auxinnepaul/pads_vending_machine_with_coin_acceptor/firmware_dev_paperwork/README.md

# Pad Dispenser — Paperwork Index

*Build. Connect. Automate.*

The documentation set for `pads_vending_machine_with_coin_acceptor.ino`.
**Start here** — this page says which doc to read for what.

Client: Rebecca Mpiima · Ref `BT-PADVEND-2026-001` · Firmware v2.0

---

## Which doc do I need?

| I want to… | Read | Audience |
|---|---|---|
| **Understand the whole machine** (what it is, what it proves, what it deliberately does not, a tour of the firmware) | [`OVERVIEW.md`](OVERVIEW.md) | **Everyone — start here** |
| **See what's been built, decided, verified on hardware, and what's next** | [`FIRMWARE_PROGRESS.md`](FIRMWARE_PROGRESS.md) | Anyone picking up the work |
| **Know why the money is handled the way it is** (pay-on-delivery, the claim vs the cash, why part payment expires, why a recovered pad waits) | [`DESIGN_DECISIONS.md`](DESIGN_DECISIONS.md) | **Read before changing anything that touches `credit`** |
| **Wire the machine** (every pin, the power tree, the PC817 coin line, both relays, the LCD level converter, as built and with what has been metered) | [`WIRING.md`](WIRING.md) | **Whoever has a soldering iron. Authoritative for wiring** |
| **Bring a machine up, or find the dispense timeout** (the order, what "good" looks like at each step, the soak procedure) | [`BENCH_TESTING.md`](BENCH_TESTING.md) | Whoever is at the bench |
| **Look up a console command** (all of them, what each is actually for) | [`CONSOLE_COMMANDS.md`](CONSOLE_COMMANDS.md) | Developer / field |
| **Debug something that is misbehaving** (LCD gibberish, phantom coins, a relay that will not switch, credit that vanishes) | [`TROUBLESHOOTING.md`](TROUBLESHOOTING.md) | Whoever is cursing at the machine |
| **Learn from what went wrong** (three dead boards, the money bugs, the diagnostics that lied, and a checklist for the next build) | [`LESSONS_LEARNED.md`](LESSONS_LEARNED.md) | Anyone building this machine, or starting the next project |
| **Pick the next thing to build** (what is parked, what stage two needs) | [`IMPROVEMENTS_BACKLOG.md`](IMPROVEMENTS_BACKLOG.md) | Whoever is planning the next session |

The [top-level README](../README.md) is the **build guide**: bill of materials,
suppression, and the things that kill hardware. For wiring and the pin map,
[`WIRING.md`](WIRING.md) is the current version. Start
there if you are assembling a machine. Start here if you are changing one.

---

## The rule everything else follows from

**The coin is in the cash box before the firmware knows it exists.**

The acceptor banks a coin and only then sends its pulses. There is no eject, no
return chute and no hopper anywhere in this machine. Nothing here can give
anybody their money back — not a fault handler, not a timeout, not a reboot.

So the firmware does not try to protect the cash. It protects **the claim**:
its own record that it owes somebody a pad. Every money decision in
[`DESIGN_DECISIONS.md`](DESIGN_DECISIONS.md) follows from that one fact, and
none of them make sense without it.

---

## Status at a glance

| | |
|---|---|
| Firmware | Complete, compiles clean on ESP32 core 2.0.11 |
| Size | ~339 KB flash (25%), 24 KB RAM |
| Coin handling | ✅ all four coins exact through the PC817 (1 / 5 / 10 / 20 pulses), accumulation, change, KSh 40 double vend |
| Coin-line protection | ✅ PC817 built and metered: no spike reaches the GPIO side. Three boards were lost before it |
| Power-cut recovery | ✅ verified on hardware |
| Jam retry / customer button | ✅ verified on hardware |
| Drop times | ⏳ first real drops 1038 & 1950 ms (2 pads); full 25–50 pad soak pending to set `DISPENSE_TIMEOUT_MS` (still 7000 ms) |
| Pads feeding off the coil | ⏳ **2 of 2 fed cleanly** (first real pads, 2026-10-22); full soak with a stack of pads still needed to prove it |
| LCD | ✅ working through an I²C level converter, found at 0x27 (`WIRING.md` §9) |
| Coin inhibit relay | ✅ active-HIGH module on the NC contact; clicks correctly, holds through boot |
| Motor noise | ✅ 0 pulses discarded |
| Loop timing | ✅ 51 ms idle, 227 ms around a vend (was 2.2 s) |
| New board (2026-10-01) | ✅ flashed, `SELF-TEST: PASS`, no relay click during boot |

`FIRMWARE_PROGRESS.md` is the living detail behind this table.
