auxinnepaul/pads_vending_machine_with_coin_acceptor/firmware_dev_paperwork/FIRMWARE_PROGRESS.md

# Firmware progress

The living memory for this project. **Read the RESUME block first.** Update it
every time the work moves on, and add a dated section saying what changed, why,
what the behaviour change is, and whether it is verified on hardware.

Mark **✅ verified on hardware** vs **⏳ pending** explicitly. A thing that
compiles is not a thing that works.

---

# ▶ RESUME HERE

**State as of 2026-10-22.** Assembled in the box; TVS and the GPIO 27
pull-down fitted; six days' unbroken uptime with flat heap; and the coil fed
its first real pads (2 of 2 present). The one open item is the full
soak — a bigger stack of pads to prove the coil and set the real dispense
timeout. Committed and pushed through `ba7f594`; the board runs that plus the
local `service_contact.h`.

### ⚡ Switch the 12 V off before plugging or unplugging the coin acceptor

The PC817 protects the ESP32 from the coin line, and the P6KE15CA TVS is now
fitted at the 12 V block, so the buck is protected too. Switching the 12 V off
before plugging the acceptor is no longer strictly required, but stays good
practice.

**Wiring as built: `WIRING.md`.** **Lessons so far: `LESSONS_LEARNED.md`.**

**The electronics are done and verified on the bench.** Every coin decodes
exactly, every vend delivers, the machine cannot open the slot or turn the
motor while booting, and the display no longer freezes the loop. What is left
is **mechanical**: a chute, real pads, and the soak.

### Verified on hardware ✅

- **Coins:** all four decode exactly through the PC817: **1 / 5 / 10 / 20**
  pulses → KSh 5 / 10 / 20 / 40, every gap 155 ms, same count every time.
  (The old 2 / 10 / 20 / 40 table was every pulse counted twice; fixed with
  a 75 ms debounce and a 400 ms coin gap. See the test log.)
- Accumulation 4 × KSh 5 and 2 × KSh 10; KSh 20; KSh 40 vends two pads
- Two coins inserted as fast as the acceptor allows read as two
- **Motor noise: 0 pulses discarded** (was 5–46/s)
- **Loop max 51 ms idle, 227 ms around a vend** (was up to 2.2 s: the LCD
  library's init() waited a second on every rebuild)
- Change carries across a vend; meter survives a power cut; recovered pad
  held and released by button or coin; jam retry and its three-attempt cap
- **Inhibit relay:** active HIGH on NC, clicks correctly (`n`), no click
  during boot, fail-safe (shorting the port inhibits)
- **Guard:** no stock-line flapping through 24 relay clicks and many vends
- **Boot window:** pull-downs hold GPIO 19 and 26; no relay moves at reset
- **Power:** 5.01 V buck, Schottky into VIN, 3V3 holds 3.33 V with the
  motor running, bulk caps at the 12 V block and buck output, 47 nF + 1N5408
  at the motor
- **PC817 coin line (meter):** 3.29 V idle, 33 mV held low, no change when
  the acceptor is unplugged and replugged
- **LCD** through the level converter (LV 3.29 V, HV 5.02 V), found at 0x27;
  backlight sleeps after 2 min; **the retry button or a coin wakes it**
- **Service number** set; the self-test no longer warns

### Pending ⏳

| | Blocked on |
|---|---|
| **TVS on the 12 V block** | ✅ P6KE15CA fitted 2026-10-22 (bidirectional) |
| **Real drop times** | No chute. Every timing so far is a finger at the IR sensor |
| **`DISPENSE_TIMEOUT_MS`** | **7000 ms placeholder.** Run `T25` down a real chute, set twice the slowest |
| **Do pads feed off the coil without jamming** | The number one risk in the whole project, still entirely open |
| **Which pass takes the 227 ms** | Not measured. Probably the coin-finish/vend-start pass, before the coil can drop a pad. The soak will show a missed drop if not |
| **`k`, `l`, `L` console commands** | Listed in the help, never implemented. Write them or remove them from the help |

**Service number now holds on the top line ✅ verified on hardware.**
It used to sit inside the paged sentence on line 2: two seconds a page, and
because pages break on spaces a spaced number could be split across two pages
depending on the credit shown before it. Every screen that gives the number
now puts it on line 1 via `callLine()` (`CALL <number>` if it fits 16, else
`TEL <number>`, else the number alone) and pages the message on line 2, so the
number is on screen for as long as the fault lasts. To verify: `t`, leave
the beam clear so the test vend times out, and the fault screen should show
the number on the top line while line 2 pages; `x` clears it. Done on the
bench 2026-10-01: the number held on the top line throughout the fault.

### Next session should

**At commissioning:** go through "Questions for Rebecca at commissioning" at the top of `IMPROVEMENTS_BACKLOG.md`, then set the firmware to her answers.

0. ~~Fit the 1 MΩ pull-down on GPIO 27~~ ✅ 2026-10-22. ~~Buy the TVS~~ ✅ P6KE15CA fitted.
1. **Build the chute and load the coil with real pads.**
2. **`T25`**: read `SLOWEST`, set `DISPENSE_TIMEOUT_MS` to twice that, reflash.
3. **The 50-cycle soak** — the number the client asked for.
4. ~~Buy and fit the TVS~~ ✅ P6KE15CA fitted 2026-10-22.
5. Decide `k`/`l`/`L`.

**Flashing on another computer:** create `service_contact.h` from
`service_contact.example.h` first, or the fault screen shows the placeholder.
The number is deliberately not in git.

---

## 2026-10-22 — In the box: TVS and pull-down fitted, 6-day run, first real pads

**Status: ✅ milestones, ⏳ full soak still pending (short of pads).**

Everything is assembled in the box.

**Fitted since the last session:**
- **P6KE15CA** TVS at the 12 V terminal block. The "C" is the bidirectional
  version — clamps both polarities, no band to fit the wrong way — and fine
  here (12.8 V standoff on a 12 V rail).
- **1 MΩ** pull-down on GPIO 27 (the 100 kΩ was too strong; see 2026-10-08).

**A six-day continuous run** (uptime 537,935 s): free heap flat at 306,880
(no leak), motor noise 0, loop max ~249 ms (the coin-finish pass, under the
300 ms flag). The watchdog `H` test was re-run on the assembled unit and
recovered: `task watchdog` → `SELF-TEST: PASS`. Buzzer cold and chirps.

**First real pads off the coil (the project's #1 open risk):**
```
T25 soak, pads loaded:
  #1  delivered in 1950 ms
  #2  delivered in 1038 ms
  #3..#5  NO PAD  -> auto-stopped (3 misses = empty coil)
```
Only two pads were on hand, so the "2 of 5 / 60% no pad" is the **empty coil,
not a feed failure**. Every cycle with a pad present fed and dropped: **2 of
2**, no misfeed, no jam. A single advance is ~1–2 s.

**Dispense timeout left at 7000 ms.** The soak recommended 4000 (2 × 1950),
but that is from only two drops. 7000 is safe (real drops are 1–2 s) and the
only cost of leaving it high is a few extra seconds before a genuine jam is
declared. Set the real value from a 25–50 pad soak, which is also the
acceptance test for the coil and the number the client asked for.

**Coil loading note (builder's observation).** The spiral has ~8 slots and
drops the *front* pad per rotation (~1–2 s), so a single dispense is fast
whatever the fill. A pad loaded at the *far* end with empty slots ahead has to
be wound all the way forward, which exceeds the 7 s timeout — but that only
happens when the front slots are empty. **Load full from the dropping side**
and every dispense is a quick single advance. Do **not** raise the timeout to
cover far-end loading. Watch, during the full soak, that the stock switch
reads EMPTY while a few pads still sit in the front slots, so the machine is
never asked to dispense the last pad from the far end.

**Next:** get a stack of pads, run `T25` (then `T50`), set
`DISPENSE_TIMEOUT_MS` to twice the true worst drop, flash.

---

## 2026-10-08 (night) — Lit, frozen screen; a loop watchdog

**Status: ✅ verified on hardware.**

**Reported by the builder:** the screen sat lit on `PAD = KSH 20` /
`THIS MACHINE` for over ten minutes, not rotating and not going dark.

**Investigated before changing anything.** `s` was sent with DTR/RTS held so
the board did not reset: the loop was alive (no hang), `faults : 1`. A typed
command wakes the display, which corrected the state; two minutes later the
backlight slept normally, which a correctly-tracked lit screen would have done
long before. **Reproduced on the old firmware:** idle until the backlight
slept, sensor VCC off (CHECK SENSOR), back on (recovered): lit and frozen
within seconds.

**Cause.** A rebuild in `say()` (set pending by the relay moving when the
slot shut) called `lcd.backlight()` unconditionally, lighting the screen while
`backlightOn` said asleep. The idle rotation and the sleep timer both require
`backlightOn`, so both stopped: lit, frozen, never sleeping. Separately, the
idle rotation stopped whenever the backlight slept, freezing mid-sentence in
the dark.

**Fixes.**
- The rebuild restores the backlight to what `backlightOn` says, and the
  raw re-sync bytes carry the matching backlight bit (no flash in the dark).
- The idle message keeps rotating while the backlight sleeps.
- A fault or out-of-stock wakes the screen, so `CALL THE NUMBER ABOVE` and
  `SORRY - NO PADS` are readable.
- `sayPaged()` rewrites only line 2 when line 1 is unchanged (the builder's
  suggestion): no clear, half the I²C traffic, no blink.
- **Loop watchdog** (the builder asked to guard against a real hang, where
  the coin interrupt would count coins that nothing banks): `enableLoopWDT()`
  at the end of setup, with the core's 5 s timeout and panic-and-reset.
  Deliberate waits call `feedWatchdog()`. Console `H` hangs the loop on
  purpose to test it.

**Results ✅**
- `H`: `task_wdt: Task watchdog got triggered ... Aborting`, restart, next
  boot `last reset : task watchdog` and `The firmware crashed last run`,
  `SELF-TEST: PASS`, back in service, all within ~5 s.
- Idle past 2 min: backlight off, text keeps moving; top line no longer blinks.
- Sensor VCC off: CHECK SENSOR and the screen lights. Back on: recovers.
  Two minutes later: dark, text still moving. No freeze.

---

## 2026-10-08 (evening) — Blank screen on some cold power-ups; pull-down fitted

**Status: ✅ verified on hardware** (results at the end of this section).

**Reported by the builder:** sometimes, on plugging the power in, the screen
showed nothing all session while coins, vends and everything else worked.

**Cause.** The LCD was looked for once, in self-test [4]. Missed then, `lcdOk`
stayed false and every screen update returned at once for the whole session,
which is why even a vend didn't bring it back. On a cold power-up the 5 V rail
ramps as its 1000 µF charges, and the ESP32 can run the self-test before the
backpack answers on I²C. An EN reset always finds it (rails already up).
Not reproduced on demand; the code path explains the symptom exactly.

**Fixes.**
- Self-test [4] waits up to `LCD_BOOT_WAIT_MS` (2 s) for the LCD to answer.
- If it is still missing, `loop()` looks again every `LCD_REPROBE_MS` (5 s),
  outside a vend, and brings the screen up the moment it answers.
- The library is always initialised at boot: `lcd.init()` is the only place
  that sets its line count, and `setCursor()` indexes an array with it.
- The display is re-initialised once more after the boot screen, when the
  rails have settled, in case its controller took its first setup on a
  still-rising rail.

**Also:** the 100 kΩ pull-down on GPIO 27 is fitted. Measured across its legs
it read 33 kΩ: that is the meter measuring the parallel path through the
sensor and the unpowered board, not a wrong resistor. The powered check
(GPIO 27 ≈ 3.0 V with the beam clear, 0 V with the sensor unplugged) is still
to record.

**Bench test plan:** unplug and replug the 12 V power several times, with the
USB unplugged (so the ESP32 starts from the ramping rail); the screen must
come up every time. If one boot does miss it, the console should say
`LCD answered after boot. Screen is up.` within about 5 s.

**Results ✅**
- **6 of 6 cold power-ups** (12 V replugged, USB unplugged): the screen came
  up every time. Each boot: buzzer chirp (self-test [9]), backlight off then
  on (`lcd.init()`), text.
- **2 of the 6 took an extra 2–4 s** before the backlight cycled. That is
  the new wait for the LCD to answer: on those two boots the backpack was not
  ready when the self-test first asked, which is exactly the case that used
  to leave the screen blank all session. (No console on those boots, so the
  `LCD answered after ... ms` line was not seen; the timing fits.)
- **Pull-down:** GPIO 27 reads **0.00 V** with the sensor's VCC disconnected,
  and the self-test halts on CHUTE BLOCKED, as intended.
- **❌ But with the sensor connected and the beam clear it reads 2.01 V**,
  below the ESP32's guaranteed HIGH (~2.5 V). It reads "clear" only because
  this chip happens to switch lower. A dip during a vend could read as a pad
  falling. 100 kΩ is too strong for this sensor. **Removed;** with no
  pull-down GPIO 27 reads **3.02 V** with the beam clear, which puts the
  sensor's output at ~3.02 V behind ~50 kΩ (not the ~10 kΩ assumed).
  **Fit 1 MΩ when one is bought** (~2.88 V clear; check ≥ 2.8 V). Until
  then an unplugged sensor floats, which on this board has drifted LOW.
  WIRING.md section 6 updated.
- With no pull-down and the sensor's **VCC** removed, GPIO 27 reads
  **0.000 V** and the machine goes out of order: the module's own pull-up ties
  the pin to its dead VCC. The 1 MΩ is therefore for a lost **OUT** wire (or
  the sensor unplugged, or likely a lost GND), where the pin truly floats.

---

## 2026-10-08 (later) — The buzzer coil carried current between every beep

**Status: ✅ verified on hardware.** Buzzer module VCC moved to the ESP32's
3V3; the module is now cold at idle (it was warm), and the beep is cleaner.

**Reported by the builder:** the buzzer works but the module gets slightly warm
when the board runs for a long time.

**Cause, confirmed in the source.** The module (ASK Electronics passive buzzer)
drives its coil with a 9012 PNP: the coil is on while the input is LOW. The
firmware silenced it with `ledcWriteTone(ch, 0)`, which in ESP32 core 2.0.11
is `ledcWrite(ch, 0)`: 0% duty, a steady LOW. So between beeps the transistor
was fully on and DC flowed through the coil the whole time. A passive buzzer
makes no sound on DC, so nothing was heard; the coil just got warm.

A firmware fix alone is not enough while the module is on 5 V: a 3.3 V HIGH
leaves ~1.7 V across the PNP's emitter-base and it stays partly on. The same
lesson as the active-LOW relay (`LESSONS_LEARNED.md` 1.4).

**Fix.** `buzzerSilence()` takes the pin off the PWM channel and drives it
HIGH; `beep()` reattaches it. Power the module from the ESP32's 3V3 so HIGH
turns the PNP fully off (WIRING.md section 6).

**To verify:** after moving VCC to 3V3 and flashing, the boot chirp and coin
beeps still sound; idle, GPIO 25 reads ~3.3 V and the module stays cold.

**Flashed 2026-10-08, buzzer VCC moved to 3V3:** boot chirp and coin beep
both sound, and the builder reports the beep is **cleaner** than before (the
coil now starts each beep from rest instead of already carrying DC). Idle
temperature: **cold** (checked after several minutes; previously warm).
The builder had swapped the module for another, thinking it faulty, and was
about to buy a new one: the part was fine, the circuit was not.

**Also added: `SOUND_ON`** (SECTION 6, default `true`). `false` makes the
machine silent; the screen still says everything and the bench test `b` still
chirps. A client decision: Q5 in "Questions for Rebecca at commissioning".
Flashed and verified: boot chirp and `b` play with `SOUND_ON = true`.

---

## 2026-10-08 — Sensor faults: read the beam always, clear by themselves; screens that can't be misread

**Status: ✅ verified on hardware 2026-10-08** (results at the end of this
section). Hardware still to fit: 100 kΩ pull-down on GPIO 27.

**Reported by the builder:**
1. The fault screen read "COINS ARE BEING TAKEN". The pager filled pages word
   by word and split `... - NO COINS ARE BEING TAKEN` after the "NO".
2. With the sensor unplugged at boot, the machine halted correctly, but
   plugging it back in did nothing until the button was held.
3. Unplugging the sensor on a running machine was not noticed at all.
4. `SEE SERIAL` on a customer screen means nothing.

**Causes:** (1) word-by-word paging; (2) faults latch by design, even when the
machine can see the fix; (3) the beam debouncer was only polled during a vend,
so at rest nothing read the sensor, and GPIO 27 floats when the sensor is
unplugged; (4) the boot halt never set the fault line, so the rotating fault
screen fell back to `SEE SERIAL`.

**Fixes:**
- `lcdPage()` honours `|` as a forced page break. Every customer message now
  pages deliberately (e.g. `OUT OF ORDER` / `CHUTE BLOCKED` /
  `COIN SLOT CLOSED` / `PLEASE CALL THE` / `NUMBER ABOVE`). No screen says
  `SEE SERIAL`; "no coins are being taken" is now `COIN SLOT CLOSED`.
- A boot halt copies its reason into the fault line, so it stays on screen.
- `padSeen()` runs on every pass. A beam blocked at rest for 5 s now goes to
  `FAULT CHECK SENSOR` and shuts the slot (was a console warning only).
- Beam faults (that one, the `CHECK SENSOR` refusal before a vend, and a boot
  halt for `CHUTE BLOCKED`) clear themselves once the beam reads clear for
  3 s; the boot case re-runs the self-test. Jams still latch.
- WIRING.md: **100 kΩ pull-down on GPIO 27**, so an unplugged sensor always
  reads BLOCKED. (47 kΩ was suggested first and was wrong: against the
  sensor's ~10 kΩ pull-up it, like the internal ~45 kΩ, leaves the clear
  level at ~2.7 V, too near the 2.5 V threshold. 100 kΩ gives ~3.0 V.)

Docs: DESIGN_DECISIONS 22c and 22d, LESSONS_LEARNED 3.8 and 3.9, WIRING.

**Bench test plan:**
1. Boot with the sensor unplugged: `OUT OF ORDER` / `CHUTE BLOCKED` /
   `COIN SLOT CLOSED` / `PLEASE CALL THE` / `NUMBER ABOVE`, and it stays on
   `CHUTE BLOCKED`. Plug it back in: within ~3 s the self-test re-runs and the
   machine returns to service on its own.
2. Running and idle, unplug the sensor: after ~5 s, `CHECK SENSOR`, relay
   click (slot shut). Plug back in: ~3 s later, back in service.
   (Without the pull-down this depends on which way the pin floats.)
3. Hold a finger in the chute for 5 s at rest: same as test 2.
4. A jam (KSh 20, no finger): `JAMMED` still needs the button.

**Bench results 2026-10-08 ✅**

| Test | Log | Result |
|---|---|---|
| Unplugged at boot | `FAIL: chute is BLOCKED` → `HALTED` → replugged → `The beam has read clear for 3 s` → self-test re-run `PASS` → `ENABLED` | recovered with no button |
| Unplugged while running | `BLOCKED at rest for 5 s` → `CHECK SENSOR`, slot `INHIBITED` → replugged → back in service | ✅ (pull-down not yet fitted; this board's pin floated LOW) |
| Finger in the chute | same | ✅ |
| Jam | `JAMMED` ×4, credit kept every time, attempts 3 → 0, button needed each time | jams still latch |

**Attendant recovery once the retries are spent** (asked by the builder):
1. Fix the jam, then lift the pads out and put them back. The stock switch
   cycling while faulted is treated as a service visit: retries reset and the
   owed pad dispenses at once. No tools.
2. EN reset on the ESP32 (inside the box). The credit survives in flash; the
   machine then holds the pad (`PAD IS PAID FOR` / `PRESS THE BUTTON TO
   COLLECT IT`) until a button press or a coin.
3. `x` from a laptop.

**Open policy question for the client:** if the payer has left before the
jam is fixed, the held pad goes to the next person who presses the button.
Whether staff should be able to cancel that credit is the client's call.
Logged as **Q1 in `IMPROVEMENTS_BACKLOG.md` → "Questions for Rebecca at
commissioning"**, to ask on the day and then implement as she decides.

---

## 2026-10-07 — Garbled LCD once on jumper wires; soldered

The sale-flow build (`fbbaf4f`) was flashed by the builder from the Arduino
IDE and is running on the board. Its bench test plan (2026-10-02 section) has
not been reported yet.

The display garbled once with the new firmware, while the LCD was connected
with Dupont jumper wires, and cleared itself on the next rebuild. A push-on
contact that breaks for a fraction of a millisecond under motor and relay
vibration has the same effect as a supply dip. The builder has since soldered
the LCD wiring (still through the level converter, I²C lines short and
crossing nothing).

**Fitted 2026-10-08:** a 100 nF ceramic soldered across the LCD backpack's
VCC and GND pins.

**LCD decoupling dropped from the to-do list.** The LCD is about 4 cm from the
buck's output, whose 1000 µF + 100 nF already serve as its local
decoupling; the wire inductance over that distance is negligible. A 100 nF
across the backpack's VCC/GND is optional.

**Not changing the I²C clock.** A suggestion to drop it to 10 kHz was
considered and rejected: the garbling is a power/contact effect, not an I²C
signal-integrity one, and at 10 kHz a full repaint would take ~0.4–0.5 s,
bringing back the blind spot at the start of every vend. Checked in the ESP32
core 2.0.11 source: the LCD library's second `Wire.begin()` logs "Bus already
started" and returns, so the sketch's `Wire.setClock(100000)` stays in effect.

---

## 2026-10-02 — Shut the slot during a sale, and make the sale talk

**Status: ✅ verified on hardware 2026-10-07** (flashed from the commit,
`fbbaf4f`; results at the end of this section).

### The money hole

The builder noticed a coin could be inserted while the machine was
dispensing. Decision 2 (25 Sep) kept the slot open mid-vend and banked those
coins; decision 18 (26 Sep) muted the coin line while the motor turns and
bins any burst. Together: a coin inserted while the coil turns is in the box
and never credited. Never reconciled until now (`LESSONS_LEARNED.md` 2.11).

**Fix.** New state `ST_PAID` between IDLE and DISPENSING. The slot rule is
now `state == ST_IDLE` and the credit short of a pad, so the acceptor shuts
the instant the price is met and stays shut through PAID, DISPENSING and
DELIVERED. PAID holds `PAID_HOLD_MS` (2 s) **and** waits for the coin line to
go quiet (up to `PAID_MAX_WAIT_MS`, 8 s) before the motor starts, so a coin
already inside the acceptor is counted, not muted. Cost: two relay operations
per sale.

**Not done, by recommendation:** shutting the slot for ~2 s after every coin.
Fast coins already read correctly, a coin dropped in during the shut window
would be rejected back out, and it would work the relay twice per coin.

### The screens

Each step now has its own screen, held by a deadline in loop() (nothing
blocks): `THAT IS KSH 5!` / `TOTAL KSH 5` (1.5 s) → `ADD KSH 15 MORE` /
`TIME LEFT 1:58` → `KSH 20 - PAID!` / `A FULL PAD!` (2 s) →
`HERE IT COMES...` → `PLEASE COLLECT` / `YOUR PAD :)` (2.5 s) →
`THANK YOU!` / `HAVE A GOOD DAY` (2 s, slot reopens). KSh 40: `2 PADS
COMING!`, `PAD 1 OF 2`, then `ONE MORE COMING` / `PAD 2 OF 2` (1 s). Every
line measured at 16 characters or fewer for any value a real sale produces.

Docs updated: DESIGN_DECISIONS 2 (rewritten) and 22b (new), OVERVIEW (six
states), README (behaviour diagram, screens table, part-payment examples, slot
rule), LOG_REFERENCE, LESSONS_LEARNED 2.11.

### Bench test plan

1. **KSh 5, then 5, 5, 5:** `THAT IS KSH 5!` each time with the total, then
   the `ADD ... MORE` countdown; at 20, `KSH 20 - PAID!` for ~2 s before the
   motor; the relay clicks the slot shut as PAID appears.
2. **Coin during the PAID pause or the motor run:** it must come back out
   (slot shut), or, if it was already inside, be banked toward the next pad.
3. **KSh 20:** `PAID!`, `HERE IT COMES...`, `PLEASE COLLECT YOUR PAD :)`,
   `THANK YOU!`, and the slot reopens (relay click) under THANK YOU.
4. **KSh 40:** `2 PADS COMING!`, `PAD 1 OF 2`, collect, `ONE MORE COMING`,
   `PAD 2 OF 2`, collect, THANK YOU. Slot shut throughout.
5. `s`: state names, and loop max still low.

### Bench results 2026-10-07 ✅

| Test | Log | Result |
|---|---|---|
| 4 × KSh 5 | `INHIBITED` → `Price met — pad 1 of 1. Slot shut` → motor → delivered → `ENABLED` | slot shut before the motor, reopened after |
| 2 × KSh 10, KSh 20 | same sequence | ✅ |
| KSh 40 | `pad 1 of 2` → delivered → `pad 2 of 2` → delivered → `ENABLED` | slot stayed shut between the two pads |
| KSh 40, first try | `Refusing to start: the beam already reads BLOCKED` → `CHECK SENSOR` | the finger was in the beam during the PAID pause; the machine refused to run blind, kept KSh 40, and one retry delivered both pads |
| KSh 20, no finger | `No pad in 7000 ms` → `JAMMED`, credit kept → retry → delivered | money kept through the fault |

The builder confirmed the screens worked. The CHECK SENSOR fault cannot
happen with real pads, which are never in the beam before the motor turns.

---

## 2026-10-01 — New board up: level converter, LCD and a clean first boot

**Status: ✅ verified on hardware** for everything listed below. No firmware
change; the sketch flashed is the repo's working tree (the active-HIGH relay
setting from `4bb1319` plus the still-uncommitted inhibit-relay/stock-switch
guard).

### Level converter

Wired per `WIRING.md` §9, with the channels as drawn (GPIO 21 → LV1 → HV1 →
LCD SDA, GPIO 22 → LV2 → HV2 → LCD SCL). Metered before the ESP32 was
connected:

| Pin | Reading |
|---|---|
| LV1, LV2 | 3.29 V |
| HV1, HV2 | 5.02 V |

Each side idles at its own rail, so the board has pull-ups on both sides and
the ESP32 can only ever see 3.3 V on SDA and SCL.

### First power-up of the new ESP32

- 12 V on, USB unplugged: nothing warm, no relay click. 3V3 pin 3.28 V.
- USB in: esptool connected first time with automatic reset (ESP32-D0WD-V3,
  rev 3.1, 40 MHz crystal, MAC `f4:2d:c9:89:bf:d4`). Flashed at 460800, all
  four images hash-verified.
- **COM3 was first refused with "Access denied":** the Arduino IDE's serial
  monitor was holding the port. Close it before flashing from the command
  line.

### Boot self-test: PASS

| Section | Reported |
|---|---|
| [3] Coin line | GPIO 18 reads HIGH (idle, correct), through the PC817 |
| [4] Screen | I²C scan finds 0x27; LCD present |
| [5] IR sensor | chute clear |
| [7] Inhibit | GPIO 19, active HIGH, NC, inhibited during the test |
| [8] Stock switch | PADS PRESENT |
| [8b] Stored balance | store open and writing, KSh 0. **Service number is still the placeholder** |
| [9] Buzzer | chirped |

After the self-test the firmware drove GPIO 19 HIGH and enabled the acceptor.

### Observed at the bench

- **No relay click before the chirp.** The pull-downs hold GPIO 19 and 26 low
  through reset, so the slot cannot open and the motor cannot twitch before
  the firmware is running.
- The LCD shows the idle screen and pages "PAD IS 20 / THIS MACHINE TAKES
  5 10 20 OR 40".
- After 2 minutes idle the backlight goes off (`BACKLIGHT_TIMEOUT_MS`); the
  text is still readable in the dark. Intended: a coin or the button wakes it.

### Bench test log

**Test 1 — inhibit relay ✅**

- `n` click test run four times. Each run drove GPIO 19 LOW (released, slot
  blocked) and HIGH (energised, slot live) three times; the relay clicked
  every time. `n0`/`n1` were not run separately: `n` drives both levels.
- Three EN resets: identical `SELF-TEST: PASS`, the inhibit pin LOW and coins
  inhibited during the test, GPIO 19 driven HIGH only after `Ready`. No click
  before the chirp.
- **No stock-switch change during 24 relay switches.** Before the guard and
  the new relay, relay switching flipped the stock line and reset the board
  twice. First evidence the guard (flashed, uncommitted) is holding. Idle
  only; not yet seen during a vend.

**Test 2 — coins through the PC817** ⏳ in progress

- **Step 1, one KSh 5 ✅.** `2 pulses`, `50 ms burst, gaps 50-50 ms`,
  recognised KSh 5, credit KSh 5 of 20, no vend. The first coin decoded
  through the optocoupler: clean, bounce-free pulse edges.
- **Observed:** ~60 garbled characters on the serial monitor just before the
  coin report, where its separator line starts. Suspected cause: the
  acceptor's gate solenoid fires on every coin, and its ground disturbance
  reaches the USB serial link, since the ESP32 ground is joined to the PC's
  through the USB cable. The coin decoded correctly regardless. **It did not
  repeat on any later coin**, so the per-coin solenoid explanation is
  withdrawn; most likely a one-off such as the serial monitor connecting.
  LCD showed KSh 5 credit and the countdown.
- **Step 2, three more KSh 5 ✅ for the vend.** Credit 10 → 15 → 20 (gaps
  50–51 ms), `Motor on — credit met`, `PAD DELIVERED in 1345 ms` (finger at
  the sensor). No phantom coins after the motor ran; no stock-line change
  during the vend.
- **❌ DEFECT under investigation: a KSh 5 coin swallowed twice.** The
  builder's account: the step-1 coin was then refused twice (came back out;
  no pulses logged, so a refused coin produces nothing, which is correct).
  A second KSh 5 was inserted five times: three times it sent 2 pulses and
  was credited, **twice it sent 1 pulse, was reported as not in the table,
  and went into the cash box.** KSh 10 lost. Both events passed the 20 ms
  debounce, so they were real low periods, not spikes.

  The ISR (falling edge, 20 ms debounce, pulses 50 ms apart) counts both
  pulses as long as the line returns high between them. Same coin, different
  counts, so it is not a coin that simply maps to an unused channel. Two
  candidate causes:

  1. **Acceptor programming.** It has 6 channels; COIN_TABLE uses 4. The
     table's own instructions suggest 1 pulse for the cheapest coin. If KSh 5
     was ever taught into a 1-pulse channel as well as the 2-pulse one, a KSh 5
     can match either. Fix on the acceptor.
  2. **A pulse lost in the new signal path** (the line not returning high
     between pulses). New wiring, so a fair suspect, but the PC817 switches
     in microseconds against a ~25 ms gap. Fix in the circuit.

  **Discriminating test:** a lost pulse would hit every coin (10 → 9,
  20 → 19); a channel mismatch only produces specific counts. Running KSh 10
  ×5, KSh 20 ×5, KSh 40 ×2, and asking whether KSh 5 was taught into more
  than one channel.

  **Result: it is pulse loss, on every coin. Cause 1 ruled out.** Every coin
  went into the cash box; none was rejected.

  | Coin | Expected | Counted |
  |---|---|---|
  | KSh 5 | 2 | 2, 2, 1, 2, 1, 2 (second run) |
  | KSh 10 | 10 | 10, 9, 8, 7, 8, 7, 8, 8, 7, 8, 9 |
  | KSh 20 | 20 | 16, 17, 19, 16, 15 |
  | KSh 40 | 40 | 33, 37 |

  Always short, never over; larger coins lose more. Gaps of 155 ms now appear
  where the acceptor's normal spacing is 50–105 ms, i.e. a pulse missing in
  between. **Retuning COIN_TABLE cannot fix this**: the same coin arrives with
  different counts. Nothing like this was recorded with the direct wiring, so
  the new signal path is the prime suspect.

  Not yet known: whether the missing pulses never pull GPIO 18 low, or the pin
  fails to return high between pulses. Those need opposite resistor changes.
  **Added console command `P`** (uncommitted, compiles clean): samples GPIO 18
  every ~20 µs for one coin and prints each LOW/HIGH period beside what the
  interrupt counted. Reads the pin only; counting and banking unchanged.

  **Separate finding:** the help lists `k`, `l` and `L`, but none is
  implemented, in HEAD or the working tree. Typing them gives "Unknown
  command". Backlog.

  **✅ ROOT CAUSE FOUND with `P` — the pulses were never lost; the
  firmware was counting extra ones.** One KSh 10 under the probe:

  ```
    #   LOW ms   then HIGH ms
     1  50.4     104.6
     2  50.4     104.7
     3  50.4     104.6
     4  50.4     104.8
     5  50.4     -  (end of coin)
    raw LOW periods seen : 5
    interrupt counted    : 9
  ```

  Five clean pulses on the wire; nine counts from the interrupt. The
  interrupt is FALLING, but a few-microsecond glitch on the ESP32's rising
  edge can fire it too, and that false count lands 50 ms after the real one,
  past the 20 ms debounce. **With the direct wiring it fired on every rising
  edge, so every coin read exactly double and COIN_TABLE was calibrated to
  the doubled counts (2/10/20/40).** The "gaps 50–105 ms" recorded back then
  (fall→rise, rise→next fall) was the fingerprint all along. The PC817 changed
  the edge shape so the false count became occasional, which is what
  exposed it. The data fits exactly: counts were never below the true number
  and never above double (KSh 10: 5 real, read 7–10; KSh 40: 20 real, read
  33 and 37).

  My earlier "pulses are being lost in the signal path" was wrong. The
  builder's instinct that the table needed changing was right, for a
  different reason.

  **Fix (uncommitted, compiles clean, flashing next):**
  - `COIN_PULSE_DEBOUNCE_MS` 20 → **75**: between the false count (+50 ms)
    and the next real pulse (+155 ms).
  - `COIN_GAP_MS` 250 → **400**: real pulses are 155 ms apart, so twice the
    widest gap is 310 ms; still under the 600 ms ceiling.
  - `COIN_TABLE` → **1 / 5 / 10 / 20** pulses for KSh 5 / 10 / 20 / 40.
  - Every comment stating the old counts updated.
  All existing self-test and per-coin sanity checks pass with these values.

**Test 2 result after the fix ✅** (flashed with debounce 75 ms, gap 400 ms,
table 1 / 5 / 10 / 20):

| Check | Result |
|---|---|
| `P` with a KSh 5 | raw LOW periods 1, interrupt counted 1 |
| KSh 5 × 4 | `1 pulse` each, 5 → 20, vend (1452 ms) |
| KSh 10 × 2 | `5 pulses` each, gaps 155–155 ms, vend (2108 ms) |
| KSh 20 | `10 pulses`, gaps 155–156 ms, vend (1307 ms) |
| KSh 40 | `20 pulses`, 2946 ms burst, two pads back to back (1163, 1902 ms) |
| Gap warnings | none |

Every gap is now the true 155 ms; the 50 and 105 ms gaps that marked the
double count are gone. Before the fix the KSh 10 read wrong on 10 of 11
drops. Drop times are a finger at the sensor and mean nothing yet. The
50-cycle soak is the full proof.

**3V3 under load ✅.** Meter on the ESP32's 3V3 pin during a vend: 3.33 V,
no visible dip while the motor ran. No brown-out risk from the motor start.

**Two fast coins ✅.** Two KSh 5 as fast as the acceptor would take them
(2 s apart): two separate `1 pulse` reports, credit 5 → 10. No merge at the
400 ms coin gap.

**Test 3 — motor noise ✅.** `s` after vends: `motor noise : 0 pulses
discarded`. It was 5–46/s before the PC817, 47 nF and 1N5408. The count is
taken before any debounce, so zero means no edges at all while the motor ran.

**⚠ Open from the same `s`:**
- **`loop max : 1288116 us`.** One pass of loop() took 1.3 s. The status
  line blames I²C, but that is an assumption in the firmware, not a
  measurement. The paged blocking screens (`sayAllPages`) only run on
  fault/refusal paths, none of which happened in that session. Matters
  because loop() watches the IR beam during a vend: a stall as a pad falls
  could miss the drop and fault or retry (a second pad). Coins are safe; the
  interrupt counts regardless. To find it: `r`, then `s` after each kind of
  event.
- **`stock changes : 2 in the last minute`** with no coin, motor or relay
  activity in that minute. **Resolved:** the builder was pressing the stock
  switch to test it.

**✅ Loop stall found: the LCD library's init() waits over a second.**
After `r`, loop max read **2.2 s** with the machine idle, and a KSh 20 vend
did not raise it. Both high readings (1.3 s, 2.2 s) came in a minute when the
stock switch was being pressed, which switches the inhibit relay, which marks
the display for a rebuild. The rebuild in `say()` called `lcd.init()`, and
`LiquidCrystal_I2C` 1.1.2's `begin()` runs `delay(50)` then **`delay(1000)`**
before anything else: ~1.07 s per rebuild, two in one pass = 2.2 s. The
status line's "means I2C is stalling" was a wrong guess.

It mattered in the vend: `motorOn()` marks the display for rebuild and the
dispensing screen follows, so for the first second of every vend loop() was
not watching the IR beam. A real pad falls through in a fraction of that and
would have been missed (retry = a second pad, or a false jam). The finger
tests hid it by holding the beam blocked.

**Fix (uncommitted, compiles clean):** `lcdResync()` re-syncs the 4-bit
interface with the HD44780 software reset (0x3 ×3, 0x2, then function set,
display on, clear, entry mode) in ~15 ms, writing the first nibbles straight
to the PCF8574 because the library keeps them private. Every rebuild trigger
is kept; they exist so a display garbled by a supply dip repairs itself, and
the reset sequence is what does that. The full `lcd.init()` stays at boot
only. To verify: loop max after `r`, a vend, a stock-switch press, and the
screen staying readable after each.

**Also:** the name removed from the boot banner and LCD boot screen
(`PAD DISPENSER` / `FIRMWARE v2.0`), and from LOG_REFERENCE's banner quote.

**Also: the retry button wakes a sleeping screen** (uncommitted, compiles
clean). Before, only a coin or a console command woke it. Now any debounced
press calls `wakeDisplay()` at once, before the 1 s hold, so the person at the
machine can read it; the hold still retries or releases a recovered pad. Two
comments still called it an attendant control "INSIDE the locked door",
contradicting the design note above them (moved to the front on purpose);
both corrected, and the README parts list with them. To verify: let the
backlight sleep (2 min), press the button, and the screen lights immediately.

**Verified on hardware ✅** (flashed, `SELF-TEST: PASS`):

| Check | Result |
|---|---|
| LCD boot screen | `PAD DISPENSER` / `FIRMWARE v2.0` |
| Retry button with the backlight asleep | lights the screen at once |
| `loop max` after `r`, idle | **51 ms** (was 2.2 s) |
| `loop max` after a KSh 20 vend | **227 ms** (was over 1 s on every vend) |

51 ms is one ordinary repaint: 32 characters through the PCF8574 at 100 kHz.
The 227 ms is most likely the pass that finishes a coin and starts the vend
(serial report, flash write, a repaint for the coin and one for dispensing),
which ends before the coil can have moved a pad; drops so far take over a
second. **Not measured which pass it was.** The soak with real pads will
show a missed drop if there is one; a per-state loop max would settle it.

The status line's "loop max over ~50000 us means I2C is stalling" called a
normal repaint a stall. Reworded to "a screen paint is ~50 ms; over
~300000 us, something blocked" (compiled; shows from the next flash).

---

## 2026-09-28 (later) — Why the boards keep dying: inductive kickback on the coin line

**Status: ✅ cause measured, ⏳ fix not yet built.** No firmware change. This is
the most consequential hardware finding in the project so far.

### The pattern

**Three ESP32 boards have gone silent.** That is not bad luck, it is a circuit
killing them. Do not put another board on the bench until the fix below is in.

### The measurement

Meter from supply ground to the acceptor's COIN output, **ESP32 disconnected**:

| Condition | Reading |
|---|---|
| Idle | ~0.002 mV — effectively 0 V |
| Hot-swapping the acceptor | **24 V**, and separately **36 V**, very briefly |

### What it means

**Idle 0 V clears the wiring.** The COIN output is a true open-collector, not
internally pulled to 12 V. The 10 k pull-up to 3.3 V is the correct way to
drive it. The wiring was never the mistake.

**24 V and 36 V are 2× and 3× the 12 V rail** — the signature of **inductive
kickback**. The acceptor contains a reject solenoid and motor windings.
Interrupting that current dumps the coil's stored energy as a spike
(`V = L·di/dt`) onto the signal line feeding the GPIO.

**The meter under-reports badly.** A DMM samples a few times a second and
filters heavily; it cannot capture a microsecond spike. A DMM showing 36 V
implies a true peak likely **well over 100 V**. The ESP32 GPIO absolute maximum
is **3.6 V**.

This explains everything observed: steady-state running is safe (the machine
worked for whole sessions), and every connect/disconnect fires a spike tens of
times over the pin rating. It also fits the previously logged motor coupling of
up to 472 induced pulses on GPIO 18 — that line has been abused for a while.

### Post-mortem on the dead boards ✅ (2026-09-30)

Continuity checks on two of the dead boards, unpowered:

| Board | Finding | Reading |
|---|---|---|
| A | **GPIO 18 shorted to GND.** 3V3 not shorted; stays cold when powered | The spike entered through the coin pin and destroyed its input stage |
| B | GPIO 18 not shorted. **3V3 shorted to GND; runs hot when powered** | The same path one step further: through the pin's clamp diode into the internal 3.3 V rail |

Board A shows the damage where the spike came in, board B shows the next step
along the path. This is direct physical evidence for the coin-line mechanism,
not an inference. Board A's 3V3 still regulates and is usable as a bench 3.3 V
source, with its GPIO 18 left unconnected. Board B must not be powered: its
shorted rail loads the buck.

### PC817 stage built and metered ✅ (2026-09-30)

Built as in the README, with the clamp diode (a 1N4007, as no 1N4148 was
bought) connected from COIN to the 12 V side of the 1 k rather than to pin 1.
That clamps COIN to about 12.6 V and still holds the LED to ~0.6 V reverse, so
it was kept. Meter at pin 4 (collector) to GND, pulled up to 3.3 V from a dead
board's still-working 3V3, GPIO 18 not connected:

| Check | Reading |
|---|---|
| Idle | 3.29 V |
| Coin dropped | dips to ~2.2 V on the meter and recovers (the meter averages the pulses) |
| COIN held to GND (a very long pulse) | **33 mV**, well below the 0.8 V logic-low threshold |
| Acceptor unplugged and replugged, several times | **No change** from 3.29 V |

The last row is the one that matters. The same action used to put 24–36 V on
the line. **⏳ Not yet verified with firmware:** coin decoding through the
optocoupler still has to be re-run on a live board.

Also fitted the same day: 10 k pull-downs on GPIO 19 and GPIO 26 (neither pin
had one), the active-HIGH inhibit relay, 1000 µF at the 12 V terminal block,
1000 µF + 100 nF at the buck output, 47 nF + 1N5408 at the motor. Buck
output 5.01 V; the VIN diode is a Schottky. **No TVS yet**, so switch the 12 V
off before plugging or unplugging the acceptor until one is fitted.

### Procedure is necessary but NOT sufficient

"Stop hot-plugging" is not a fix. **The solenoid energises and de-energises
during normal operation**, every time a coin is rejected. The same mechanism
fires on a healthy machine, smaller and less often. Plug-order discipline
(**ground first on connect, ground last on disconnect**; better, one switched
supply for everything) removes the worst case only.

### The fix — optocouple the coin line

Also expected to eliminate the motor-induced false pulses, since it removes the
galvanic path entirely:

```
12 V --[1k]--> PC817 LED ---- COIN signal (acceptor sinks it low)

PC817 transistor:
  collector --+-- ESP32 GPIO 18
              +--[10k]-- 3.3 V
  emitter   ----- ESP32 GND
```

Supporting parts, in order of value:

1. **Flyback diode (1N4007) across the solenoid**, at the coil — kills the
   spike at source rather than downstream.
2. **1 k in series** with the GPIO — limits fault current to what a clamp diode
   survives.
3. **3.3 V zener or TVS to GND** on the GPIO side, belt-and-braces.

### Also suspected, lower priority

The **5 V I2C LCD backpack** (PCF8574) idles SDA/SCL at 5 V through its
pull-ups. ESP32 GPIOs are not 5 V tolerant. But the current through typical
4.7 k pull-ups is only ~0.3 mA into the clamp diode — a slow degrader, not an
instant killer. Fix with an I2C level shifter or a 3.3 V-powered backpack.
**⏳ Unmeasured:** with the LCD powered and the ESP32 out of circuit, measure
SDA→GND and SCL→GND; 5 V confirms it needs shifting.

### Inhibit port: shorting inhibits ✅ (2026-09-29)

Shorting the acceptor's two inhibit pins by hand with it powered stops it
accepting coins. So **NC contacts are the fail-safe choice**: coil off (board
dead, booting or crashed) means contacts closed and the acceptor inhibited.

**Decided:** replace the active-LOW inhibit relay module with an **active-HIGH**
one matching the motor relay. When it is fitted: set
`INHIBIT_RELAY_ACTIVE_HIGH = true`, move GPIO 19's 10 k from pull-UP to
pull-DOWN, and rewrite the pull-up comment above that constant. No MOSFET.

**Flyback diode placement:** the solenoid is inside the acceptor, so the 1N4007
goes reverse-biased across the acceptor's 12 V input at its connector (cathode
to +12 V). It is a secondary defence; the PC817 is the primary one.

### Still to confirm

Reconnect the 10 k pull-up to 3.3 V, ESP32 still out of circuit, and measure
idle. Expect **3.3 V**, dropping to 0 V per coin pulse. Anything above 3.3 V
means a second problem.

---

## 2026-09-28 (later) — The board went silent, and the full disk was a red herring

**Status: ⏳ unresolved, blocked on bench measurement.** No firmware change.

### What was actually wrong with the tooling

`C:` had **zero bytes free**. `esptool` unpacks a Python runtime into a temp
directory on every run, so it was dying before it ever reached the serial port.
Every upload failure logged before this point is explained by that and says
nothing about the hardware. Disk cleared to 16.3 GB; `esptool` now runs to
completion.

### What is wrong with the board

With a working `esptool`, the board is silent in every state tested:

| Test | Result |
|---|---|
| `esptool --chip esp32 --port COM3 chip_id` | `No serial data received` |
| Passive listen @ 115200 and @ 74880 | 0 bytes |
| Forced EN reset via RTS, listening @ 74880 | 0 bytes |
| All four DTR/RTS combinations after reset | 0 bytes each |

**Two inferences worth keeping.**

1. **Zero bytes rules out a baud mismatch.** A wrong baud rate yields framing
   garbage, not silence. Nothing at all means no activity on the ESP32's TX
   line — an absent signal, not a misread one.
2. **The USB side is healthy.** COM3 enumerates as a CP210x, which runs off USB
   5 V. So the cable's data lines and the bridge chip are alive; the fault is
   downstream, on the ESP32 itself. The ROM bootloader prints its
   `ets Jul 29 2019` banner on every EN release regardless of flashed firmware,
   given power, a clock and a TX path. It printed nothing.

### Prime suspect

The board was **verified working earlier the same day** (all coin paths). The
last work done was the inhibit-relay investigation, which involved **jumpering
5 V** to release an active-low relay module. A slip there — 5 V onto a 3.3 V
GPIO or onto the 3V3 rail — would kill the regulator or the chip while leaving
the USB bridge enumerating exactly as observed. **Unconfirmed**, but inspect
before replacing anything.

### Next session: measure, in this order, stop at the first failure

1. **3V3 → GND** — expect ~3.3 V. 0 V or ~5 V means the regulator is gone.
2. **EN → GND** — expect ~3.3 V at rest. Near 0 V means permanent reset.
3. **Swap USB cable and port** — a cable that enumerates but sags on 5 V can
   brown out the ESP32 while the bridge still works.
4. **Try a spare ESP32 on COM3** and re-run `chip_id`. That settles
   board-versus-everything-else in one move.

### Unrelated, done the same session

The uncommitted working-tree changes to the sketch (173 insertions, stock
switch) now **compile clean** — 25% program storage, 6% dynamic memory, only
the cosmetic `LiquidCrystal_I2C` architecture warning. **⏳ Not flashed, not
verified on hardware**, and cannot be until the board responds.

---

## 2026-09-28 — The inhibit relay: an ESP32 cannot turn off a 5 V active-low module

**Settled, with the bare Blink example.** GPIO 19 toggling HIGH/LOW every
second, nothing else running, and the relay never moved. A jumper from **5 V**
releases it; a jumper from the ESP32's **3V3** does not.

Not a firmware problem. No firmware setting fixes it.

**Why the motor relay working was never evidence.** Two different circuits:

- **active HIGH** (motor): `pin -[R]-|>- GND`. 3.3 V switches it on, LOW off.
  A 3.3 V MCU drives it perfectly.
- **active LOW** (inhibit): `5V -|>-[R]- pin`. LOW switches it on. Turning it
  **off** needs the pin near 5 V; 3.3 V leaves ~1.7 V across the LED, enough
  to keep conducting. It energises and never releases.

I had this right first, retracted it when the motor-relay evidence was raised,
and was wrong to. The evidence was real but did not apply.

**Multi-channel boards dodge it** with a `JD-VCC` jumper separating logic from
coil supply. **Single-channel boards have no such jumper** — the case here.

**Fix: one NPN.** Pin HIGH → transistor on → pulls the module input to 0.2 V →
relay on. Pin LOW or floating → transistor off → module's own pull-up takes it
to 5 V → relay off.

Two config consequences when it is fitted:
- `INHIBIT_RELAY_ACTIVE_HIGH = true` — the transistor inverts the logic
- The pull resistor becomes a pull-**DOWN**, and the boot window becomes
  fail-safe by default rather than by careful wiring

**Verified.** ⏳ Transistor not yet fitted. Config unchanged until it is.

---

## 2026-09-28 — The soak stopped after every first cycle

**The bug.** `T25` ran one cycle and stopped:

```
  #1  delivered in 1127 ms
  Chute is blocked. Clear it and start again. Stopping.
```

Reproducible on every run, whatever the cycle count.

**Cause.** `padSeen()` is a debouncer and carries state from whenever it was
last called. Immediately after a delivery that state is BLOCKED — the pad
tripped the beam and nothing has called it since to notice the pad has gone.
The soak's beam check bailed out on the **first** reading, so it read that
stale value and declared a blocked chute on a chute that was empty.

**Why it never showed in a paid vend.** Luck. `ST_DELIVERED` polls `padSeen()`
on every pass for 2.5 seconds, so the debouncer was always fresh by the time
`startVend()` ran. Nothing polled it during the soak's gap between cycles.

**Fix.** One shared `chuteClear()` that polls the **whole** settle window and
only judges at the end, so the debouncer catches up before the verdict.
`startVend()`, `soakTest()` and `attemptClear()` all use it — the first had the
same latent bug and was surviving on that accident.

**Verified.** ⏳ Compiles. Needs a re-run of `T5` on hardware.

---

## 2026-09-28 — Paperwork, soak command, silent boot

**What changed.** Added `T<n>`, a soak that runs *n* vends back to back, times
every drop, and reports twice the slowest as the timeout to set. Added
`SERIAL_LOG_BOOT` so a field machine can boot completely silently. Created this
paperwork set.

**Why.** `DISPENSE_TIMEOUT_MS` had been set three times from whatever happened
to be in the last log, and once from a finger at the sensor. That is not a
measurement. The soak makes it one — and its ceiling is deliberately far longer
than the real timeout, because a stopwatch that stops before the event cannot
measure it.

`SERIAL_LOG_DEFAULT` did not cover the boot: the banner and self-test were
forced on regardless, so a unit set quiet still printed a second of text at
every power-up. "Off" was not off.

**Behaviour change.** A failing self-test on a quiet boot is re-run with the
console forced on. Silent when healthy, loud when broken.

**Verified.** ⏳ Compiles clean. Soak not yet run against real pads.

---

## 2026-09-28 — A recovered pad waits to be collected

**What changed.** A recovered balance covering a whole pad is now **held**
rather than dispensed on boot. A button press or a coin releases it.

**Why.** Power comes back at three in the morning, the machine wakes owing a
pad, and drops one into an empty washroom. Dispensing to nobody is not
honouring the debt — it is losing a pad on top of the money.

**Also fixed.** `REMEMBER_CREDIT_ACROSS_POWER_LOSS = false` did not fully
remove persistence: `setup()` still called `prefs.begin()` unconditionally. The
NVS partition is now never opened when the feature is off.

**Verified.** ✅ On hardware — both release routes seen in the log.

---

## 2026-09-27 — The unsigned underflow that broke KSh 5 and 10

**The bug.** Part payment was cleared on the very pass it was banked. Signature:

```
cleared after an actual wait of 4294967 s (limit 120 s)
```

2³²−1 ms. `lastCoinMs` was *ahead* of the loop's `now`, so `(now - lastCoinMs)`
wrapped to 4.29 billion and every timeout test built on it fired instantly.

**Cause — one word, a regression.** `loop()` reads `now` once at the top. The
original code stamped `lastCoinMs = now`. When banking moved into `bankCoin()`
it became `lastCoinMs = millis()`, which runs later in the same pass and is
therefore larger than `now`.

**Why only 5 and 10.** KSh 20 and 40 meet the price and vend before the timeout
check is ever reached. Only partial credit goes down that path.

**Fix.** Added `sinceMs()` to measure, used the existing wrap-safe `reached()`
to decide, and converted **all eight** comparisons of the stale `now` against a
stamp written later in the same pass. Two were live bugs: this one, and the
backlight sleeping on the first coin pulse.

**Verified.** ✅ On hardware.

---

## 2026-09-26 — Motor noise was being spent as money

**The bug.** KSh 40 vended three pads. Phantom 2-pulse "KSh 5" coins appeared
immediately after every `Motor on`.

**Cause.** Switching the coil induces edges on GPIO 18 indistinguishable from
coin pulses, arriving in ones and twos — the pulse count of the cheapest coin.
Up to **472 induced pulses in one 5-second run**.

**It was a regression of mine.** The older sketch *rejected* mid-vend coins, so
the noise was invisible. Changing to bank them turned it into money.

**Fix.** The coin interrupt counts nothing while the motor runs, nor for
`MOTOR_NOISE_SETTLE_MS` after. Discarded pulses are counted and reported with
their **rate**, because a fixed burst per run and a steady rate scaling with run
time are different faults needing different parts.

**Later finding.** The rate was 70/second steady — **brush arcing**, not the
switching spike. A flyback diode alone does nothing for it; it needs 100 nF
across the motor terminals. The earlier advice was wrong.

**Verified.** ✅ Muting works. ⏳ Suppression not finished — rate is 5–46/s.

---

## 2026-09-25 — The money model

A run of review rounds reshaped how money is handled. The full reasoning is in
[`DESIGN_DECISIONS.md`](DESIGN_DECISIONS.md); the headlines:

- **Pay on delivery, not on motor start.** Charging at motor start meant taking
  money for a pad that never came out
- **The meter survives a power cut.** Without it, a cut with KSh 5 on the meter
  was a clean swallow with no record anywhere
- **Never leave the stored balance above the real one** — that direction can
  vend a pad nobody paid for
- **A full pad's worth of credit never times out**, in any state
- **The retry button is a customer control**, on the front. `attemptClear()`
  was zeroing the credit, which threw away her money at the exact moment she
  was standing there asking for the pad

**Verified.** ✅ All on hardware.

---

## Recurring lesson

Three separate defects in this project came from **claims made without
checking**: that `putUShort()` compares before writing, that it was "three
writes per sale", that clearing a stale balance was strictly safe. Each was
fixed not by writing a more careful comment but by **removing the dependency on
the claim** — a shadow copy makes "identical writes are skipped" true by
construction; a `>` comparison makes the safety argument hold without a caveat.

A second pattern: every time the logic changed, a comment somewhere else kept
describing the old design. The inhibit rule, the state table, and the flash
claim were all the same failure. **A wrong comment is worse than none**, because
the next person reasons from it.
