auxinnepaul/pads_vending_machine_with_coin_acceptor/pads_vending_machine_with_coin_acceptor.ino

/*
  Pads Vending Machine — Coin Acceptor Prototype
  Bricapa Technologies · Client: Rebecca Mpiima
  Ref: BT-PADVEND-2026-001          Firmware v2.0

  ---------------------------------------------------------------------------
  WHAT THIS DOES
  ---------------------------------------------------------------------------
  Coin in  ->  acceptor pulses  ->  firmware decodes which coin it was
           ->  credit reaches the price  ->  relay closes  ->  motor turns
           ->  pad falls through the chute and breaks the IR beam
           ->  motor stops.  LCD and buzzer report each step.

  If no pad breaks the beam within DISPENSE_TIMEOUT_MS the motor stops anyway
  and the machine latches into a fault. It does NOT reverse and does NOT retry
  by itself — the relay drives one direction only, which is a deliberate design
  decision agreed with the client.

  ---------------------------------------------------------------------------
  THE SERIAL CONSOLE IS THE POINT OF THIS VERSION
  ---------------------------------------------------------------------------
  Open the Serial Monitor at 115200. Everything you need to bring the machine
  up, calibrate it and diagnose it is there. Type ? for the command list.

  Set the Serial Monitor line ending to "Newline" if you can. If you leave it
  at "No line ending" the console still works — it takes a command after a
  short pause in typing.

  ONE thing is stored in flash: the amount on the meter, so a power cut does
  not swallow part payment. See SECTION 3, REMEMBER_CREDIT_ACROSS_POWER_LOSS.

  Nothing else is. Every console setting, and every counter — vends, takings,
  faults — is lost on reset, and that is on purpose: the console is for finding
  the right number, then you write that number into CONFIG below and flash it.

  ---------------------------------------------------------------------------
  WIRING
  ---------------------------------------------------------------------------
    12 V adaptor --+-- LM2596 buck -> 5.0 V -> Schottky -> ESP32 VIN
                   |                        +- ESP32 3V3 pin -> KY-032 VCC
                   +-- coin acceptor  (12 V)
                   +-- relay COM/NO   -> motor  (flyback diode across motor)

    GPIO 21  LCD SDA
    GPIO 22  LCD SCL
    GPIO 18  Coin acceptor pulse   (via PC817, INPUT_PULLUP, pulled LOW per pulse)
    GPIO 19  Coin inhibit relay    (active HIGH, 10k pull-DOWN to GND, NC contact)
    GPIO 26  Relay control         (active HIGH, 10k pull-DOWN to GND)
    GPIO 27  KY-032 IR output
    GPIO 25  Passive buzzer

  ---------------------------------------------------------------------------
  BEFORE FIRST POWER-UP — three things that kill hardware
  ---------------------------------------------------------------------------
    1. Set the LM2596 to 5.0 V with a meter BEFORE connecting the ESP32.
    2. The coin line goes through a PC817, never straight to GPIO 18. It idles
       at 0 V, so measuring it proves nothing: plugging and unplugging the
       acceptor put 24-36 V on it and killed three boards. See README.
    3. Fit the 10k pull-down on GPIO 26 so the motor stays still through boot
       and through every reset while you are flashing.

  ---------------------------------------------------------------------------
  MAP OF THIS FILE — what lives where
  ---------------------------------------------------------------------------
  Everything you need to change to commission a machine is in CONFIG, in nine
  numbered sections. Below the END OF CONFIG banner is machinery you should be
  able to read but rarely need to touch.

    CONFIG
      SECTION 1   PIN MAP            which GPIO does what
      SECTION 2   COIN TABLE         pulses -> shillings, per coin
      SECTION 3   PRICE AND CHANGE   what a pad costs, what happens to change
      SECTION 4   POLARITY           IR, relays, stock switch, LCD address
      SECTION 5   TIMING             every delay and timeout, explained
      SECTION 6   SOUND              buzzer tones
      SECTION 7   CONSOLE / FIELD    logging switch, self-test behaviour

    MACHINERY
      STATE               the five states and what each one means
      ISR                 counting coin pulses without missing any
      HARDWARE HELPERS    motor, inhibit relay, buzzer, LCD, sensors
      FAULT / EMPTY       how the machine goes out of service and comes back
      SERIAL REPORTING    the per-coin report
      SELF-TEST           the nine checks run at every boot
      SERIAL CONSOLE      the commands, and what each one is for
      SETUP               boot order, and why it is that order
      LOOP                the main cycle, and why its order matters

  ---------------------------------------------------------------------------
  HOW THIS MACHINE HANDLES MONEY, AND WHY
  ---------------------------------------------------------------------------
  Read this before changing anything that touches `credit`. Every rule below
  exists because of one physical fact:

      THE COIN IS IN THE CASH BOX BEFORE THIS FIRMWARE KNOWS IT EXISTS.

  The acceptor banks a coin and only then sends its pulses. There is no eject,
  no return chute and no hopper anywhere in this machine. Nothing here can give
  anybody their money back — not a fault handler, not a timeout, not a reboot.

  So the firmware cannot protect the cash. What it protects instead is THE
  CLAIM: its own record that it owes somebody a pad. Five rules follow from
  that, and each one is a deliberate answer to "who loses if this goes wrong".

   1. PAY ON DELIVERY, NOT ON MOTOR START.
      Credit comes off the meter at the moment the beam confirms a pad fell,
      and nowhere else. A jam, an empty coil or a missed beam therefore costs
      the customer nothing — the claim is still on the meter and is honoured
      as soon as the machine can serve it. Charging at motor start would have
      meant taking money for a pad that never came out.
      -> ST_DISPENSING, the one line that calls setCredit() on delivery.

   2. A COIN THAT LANDS MID-VEND IS BANKED, NOT DISCARDED.
      Inhibiting the acceptor stops the NEXT coin; one already rolling through
      the mechanism still completes. Those states end in IDLE within a second
      or two, so the machine CAN honour it — it buys the next pad. Throwing it
      away would mean keeping the money and giving nothing back.
      EMPTY and FAULT still refuse, because there the machine genuinely cannot
      deliver and must not take the claim on.

   3. A FULL PAD'S WORTH OF CREDIT IS NEVER TIMED OUT.
      Part payment expires (rule 4). Credit that already covers a pad does not,
      in any state, because that is a debt the machine has already been paid
      for. It waits — through IDLE, through EMPTY, through a refill.

   4. PART PAYMENT EXPIRES, AND THAT IS A POLICY CHOICE, NOT A DEFAULT.
      No setting returns the money, so all CREDIT_TIMEOUT_MS decides is whether
      abandoned part-payment stays with the business or eventually buys a pad
      for whoever walks up next. Two minutes, with a countdown on the screen so
      she knows how long she has. Set it to 0 to wait forever.

   5. THE METER SURVIVES A POWER CUT.
      Without this, a cut with KSh 5 on the meter is a clean swallow: coin in
      the box, no record anywhere. The balance is the only thing this firmware
      writes to flash. The countdown restarts from boot rather than resuming,
      so a short cut protects the customer still standing there and a long one
      does not leave a stranger's balance up all night.

  Two places the money still goes nowhere, stated so nobody thinks otherwise:
  a coin already mid-flight when the machine faults or runs out, and part
  payment that nobody comes back for. Both are logged, never silent.

  ---------------------------------------------------------------------------
  THE SIX STATES
  ---------------------------------------------------------------------------
    IDLE        Waiting for money. Coins accepted.
    PAID        The price is met. "KSH 20 - PAID!" for a moment before the
                motor starts. Slot already shut.
    DISPENSING  Motor turning, watching the beam. Slot shut.
    DELIVERED   Pad fell, "PLEASE COLLECT YOUR PAD" on screen. Slot shut.
    EMPTY       Stock switch says no pads. Coins refused. NOT a fault: it
                comes back on its own the moment the coil is refilled.
    FAULT       Something is wrong that needs a person. Coins refused.
                Latched until the clear button is held, or  x  is typed.

  ---------------------------------------------------------------------------
  THE FOUR TIMINGS YOU WILL ACTUALLY TUNE
  ---------------------------------------------------------------------------
    DISPENSE_TIMEOUT_MS   how long to wait for a pad before deciding that
                          nothing dropped.  <- the one you asked about
    COIN_GAP_MS           how long a silence means "that coin is finished"
    CREDIT_TIMEOUT_MS     how long part-payment sits before it is forgotten
    MESSAGE_HOLD_MS       how long "PLEASE COLLECT YOUR PAD" stays up

  The first three can be changed live from the console, so you can find the
  right number without reflashing, then write it into SECTION 5. See the
  detailed notes on each one there.
*/

#include <Wire.h>
#include <LiquidCrystal_I2C.h>
#include <esp_system.h>
#include <esp_task_wdt.h>
#include <Preferences.h>

// The service phone number is kept out of git. It lives in service_contact.h
// next to this sketch, which .gitignore excludes; copy
// service_contact.example.h to create it. Without it the placeholder below is
// used and the boot self-test warns.
#if __has_include("service_contact.h")
#include "service_contact.h"
#endif
#ifndef SERVICE_CONTACT_TEXT
#define SERVICE_CONTACT_TEXT "07XX XXX XXX"
#endif

#define FW_VERSION "2.0"

// Declared up here, above everything else, because the Arduino build inserts
// its auto-generated function prototypes ahead of the first function in the
// file — and takeCoin() takes one of these. A struct used in any signature has
// to be visible before that insertion point or the sketch will not compile.
struct CoinBurst
{
  uint16_t pulses;
  uint16_t gapMin; // ms between pulses, smallest seen in this coin
  uint16_t gapMax; // ms between pulses, largest seen in this coin
  uint32_t durMs;  // first pulse to last pulse
};

// ---------------------------------------------------------------------------
//  Logging.  Every Serial.print in this sketch goes through these, so the one
//  switch in SECTION 7 silences the lot for a field install.
//
//  logEvents is the setting. logOn is the momentary gate: handleCommand()
//  forces it true for the duration of a typed command, so the console always
//  answers a human even on a machine installed with logging off, then puts it
//  back. Serial.begin/available/read are never gated — input always works.
// ---------------------------------------------------------------------------
bool logEvents = true; // set from SERIAL_LOG_DEFAULT in setup()
bool logOn = true;     // momentary gate, see above

#define LOG(...) do { if (logOn) Serial.print(__VA_ARGS__); } while (0)
#define LOGLN(...) do { if (logOn) Serial.println(__VA_ARGS__); } while (0)


// ###########################################################################
// #                                                                         #
// #   CONFIG — THIS IS THE PART YOU EDIT.  NOTHING BELOW SECTION 7 NEEDS    #
// #   CHANGING TO COMMISSION A MACHINE.                                     #
// #                                                                         #
// ###########################################################################

// ===========================================================================
//  SECTION 1 — PIN MAP
// ===========================================================================
//
//  These are not arbitrary. On an ESP32 most pins have a second job and only
//  some are safe for general use:
//
//    0, 2, 5, 12, 15   strapping pins. The chip reads them at boot to decide
//                      how to start. Pull one the wrong way and the board will
//                      not boot, or will boot into the wrong mode.
//    1, 3              the USB serial port. Using them kills the console.
//    6 - 11            wired to the flash chip. Touching them bricks the run.
//    34 - 39           INPUT ONLY, and with NO internal pull-up. Fine for an
//                      analogue sensor, useless for a switch to GND — which is
//                      why the stock switch is not up there.
//
//  Everything below is outside all of that. If you move a pin, check it
//  against this list first.
//
//  Three of these need an external resistor. See the header block at the top
//  of this file — a floating pin during the boot window is a motor that twitches
//  and a coin slot that is live.
//
const uint8_t PIN_COIN = 18;
const uint8_t PIN_RELAY = 26;
const uint8_t PIN_IR = 27;
const uint8_t PIN_BUZZER = 25;
const uint8_t PIN_SDA = 21;
const uint8_t PIN_SCL = 22;
const uint8_t PIN_INHIBIT = 19; // relay 2 -> HX-916 2-pin inhibit port
const uint8_t PIN_CLEAR = 23;   // jam-clear button to GND (INPUT_PULLUP)
// On 13 rather than 33 purely because 13 lands next to the terminal block on
// this build. Both are equally valid: plain GPIOs, no strapping, no flash, and
// both have the internal pull-up a switch-to-ground needs. 13 is ADC2, which
// does not matter here because this pin is only ever read digitally.
const uint8_t PIN_PADS = 13;    // stock limit switch to GND (INPUT_PULLUP)

// ===========================================================================
//  SECTION 2 — THE COIN TABLE.  WHAT EACH COIN IS WORTH.
// ===========================================================================
//
//  A multi-coin acceptor does not say "that was twenty shillings". It says
//  "that coin was channel 3", and it says it by sending three pulses in quick
//  succession. This table is where you write down what each channel is worth.
//
//  HOW TO FILL THIS IN
//    1. Put the acceptor in learn mode and teach it your coins. Give each coin
//       type a DIFFERENT pulse count. One pulse for the cheapest is the usual
//       convention. Write down which channel you taught which coin to.
//    2. Flash this sketch, open the Serial Monitor, and drop a real coin in.
//       The console prints the pulse count it saw, whether it recognised it,
//       and what it did with it. Unknown coins are reported loudly, never
//       silently swallowed.
//    3. Come back here and make the table agree with what you saw.
//
//  Pulse counts must be UNIQUE. Self-test refuses to run a table with
//  duplicates, because two coins on one channel is money you cannot account
//  for. Order does not matter.
//
struct CoinDef
{
  uint16_t pulses;  // how many pulses the acceptor sends for this coin
  uint16_t value;   // what it is worth, in whole shillings
  const char *name; // what the console calls it. Keep it short.
};

const CoinDef COIN_TABLE[] = {
    //  pulses   value   name
    {1, 5, "KSH 5"},
    {5, 10, "KSH 10"},
    {10, 20, "KSH 20"}, // two 20s taught as one channel, or delete
    {20, 40, "KSH 40"}, // delete any line you have not taught
    // Measured on the raw waveform with console  P  (2026-10-01): each pulse
    // is 50 ms LOW then 105 ms HIGH. An earlier table of 2 / 10 / 20 / 40 was
    // exactly double, because every pulse was being counted twice; see
    // COIN_PULSE_DEBOUNCE_MS.
};
const uint8_t COIN_TABLE_LEN = sizeof(COIN_TABLE) / sizeof(COIN_TABLE[0]);

// ===========================================================================
//  SECTION 3 — PRICE AND CHANGE
// ===========================================================================

// What one pad costs, in whole shillings.
uint16_t PAD_PRICE = 20;

// THE MACHINE GIVES NO CHANGE. It has no hopper and no second motor, so it
// physically cannot. This flag decides what happens to money above the price:
//
//   true  — overpayment stays on the meter. KSh 50 at a KSh 20 price buys two
//           pads back to back and leaves KSh 10 on screen, which the next
//           customer gets or which times out. Fairer, and what a real machine
//           does.
//   false — one pad per transaction, the rest is forfeit. Simpler to watch on
//           the bench. Do not ship it this way.
//
const bool KEEP_CHANGE_AS_CREDIT = true;

// --- SURVIVING A POWER CUT --------------------------------------------------
//
//  true  = the amount on the meter is written to flash whenever it changes, so
//          a power cut does not swallow part payment. Somebody who has put in
//          KSh 5 of KSh 20 when the power goes still has her KSh 5 when it
//          comes back.
//  false = nothing is written to flash at all. A power cut with money on the
//          meter loses it silently.
//
//  WHY THIS IS WORTH THE FLASH WRITES. Without it, a cut at the wrong moment
//  is a clean swallow: the coin is in the box, the firmware forgets it ever
//  arrived, and nobody — not the customer, not the log, not the takings — has
//  any record. That is the one failure this machine should never have, and
//  mains cuts are not hypothetical at a Kenyan site.
//
//  WHAT IT DOES NOT FIX. It restores the CLAIM, not the cash; nothing can
//  return the coin. And if the outage is long, the person who comes back to it
//  is not the person who paid. That is bounded on purpose: the countdown
//  restarts from boot, so a restored balance expires CREDIT_TIMEOUT_MS after
//  the power returns rather than sitting on the screen all night. A short cut
//  protects the customer standing there; a long one does not leave a standing
//  balance for a stranger.
//
//  COST. One write per coin plus one on the vend. With KSh 5 coins and a KSh 20
//  pad that is FIVE writes for a single sale, not three — the smallest coin in
//  the table sets the worst case, so re-check this if you add a smaller one.
//  Call it 90,000 writes a year at fifty sales a day.
//
//  That is still not a wear problem, but for the right reason rather than the
//  one first claimed here: NVS packs many writes into a flash page before it
//  erases anything, and wear-levels those erases across the partition, so the
//  flash sees far fewer erase cycles than the firmware does writes. Decades,
//  comfortably. Redundant writes are skipped in setCredit() by comparing
//  against a shadow of what is actually stored — Preferences does not do that
//  for you.
const bool REMEMBER_CREDIT_ACROSS_POWER_LOSS = true;

// What to do when a recovered balance already covers a whole pad.
//
//  true  = hold it and wait for a person. The machine says the pad is paid
//          for and asks for a press.
//  false = dispense it immediately on boot.
//
//  WHY HOLDING IS BETTER. Power comes back at three in the morning, the
//  machine wakes up owing a pad, and drops one into an empty washroom. Nobody
//  is there. It lies in the tray until whoever opens up finds it, or it walks.
//  Dispensing to nobody is not honouring the debt, it is losing a pad on top
//  of the money.
//
//  Held, the pad stays in the coil where it is safe until the next person
//  touches the machine — a button press, or a coin, which equally means
//  somebody is standing there. That is not the customer who paid either, but
//  she was gone the moment the power went, and at least the pad reaches a
//  person instead of a floor.
const bool HOLD_RECOVERED_PAD = true;

// ===========================================================================
//  SECTION 4 — SENSOR AND RELAY POLARITY
// ===========================================================================

// true  = sensor output goes LOW when it sees the pad  (usual for KY-032)
// false = sensor output goes HIGH when it sees the pad
// If you use the "aim across the chute at the far wall" trick, this inverts.
// Console command  i  shows the live reading so you can settle this in ten
// seconds with your hand.
const bool IR_DETECTED_IS_LOW = true;

// Relay module polarity. This build uses an active-high module.
const bool RELAY_ACTIVE_HIGH = true;

// I2C address of the LCD backpack. Almost always 0x27, sometimes 0x3F.
// Console command  z  scans the bus and tells you.
const uint8_t LCD_I2C_ADDR = 0x27;

// --- COIN ACCEPTOR INHIBIT -------------------------------------------------
// The HX-916's 2-pin port: upper pin floating = accepting, upper pin shorted
// to the lower pin (its GND) = inhibited. Driven by a dry relay contact, never
// by a GPIO — on some units that pin sits at 12 V.
//
// true  = the relay module energises when its input is driven HIGH. This is
//         the same module as the motor relay, and what is fitted.
// false = energises when pulled LOW. Do not go back to one: an ESP32's 3.3 V
//         cannot turn a 5 V active-LOW module OFF, so it energises and never
//         releases. That is why it was replaced.
// IMPORTANT: the pull resistor on PIN_INHIBIT follows this setting. Active HIGH
// needs a 10k pull-DOWN to GND (the same as the motor's GPIO 26); active LOW
// would need a pull-UP. Get it backwards and the relay energises through the
// boot window, the NC contact opens, and the slot is live on every reset.
const bool INHIBIT_RELAY_ACTIVE_HIGH = true;

// Which contact of the relay you wired across the 2-pin port.
//   true  = NC. Closed with the coil off, so the acceptor is inhibited
//           whenever this board is unpowered, booting, halted or crashed.
//           Fail-safe. Ship it this way.
//   false = NO. A dead controller accepts coins and delivers nothing.
//           Bench use only.
const bool INHIBIT_CONTACT_IS_NC = true;

// --- PAD STOCK SWITCH ------------------------------------------------------
// A mechanical limit switch that tells the machine whether there are pads left
// to dispense, so it can stop taking money BEFORE somebody pays for nothing.
//
// WIRE IT: one side to PIN_PADS, the other to GND. Nothing else. The ESP32's
// internal pull-up does the rest.
//
// CLOSED (pin LOW) = pads present.  OPEN (pin HIGH) = empty.
//
// That direction is deliberate and it is the safe one. A broken wire, a pulled
// connector or a corroded contact all leave the pin floating HIGH, which reads
// EMPTY — so the machine refuses money. Wired the other way round, the same
// faults read FULL and the machine cheerfully takes coins over an empty coil.
// A failure should always cost you a sale, never a customer's money.
const bool PADS_PRESENT_IS_LOW = true;

// Set this true ONLY once the switch is actually wired. While it is false the
// stock check is bypassed entirely and the machine behaves as it did before —
// otherwise an unwired pin floats HIGH, reads EMPTY, and the machine sits
// there refusing to vend while you wonder why.
const bool PAD_SWITCH_FITTED = true;

// --- RETRY BUTTON ---
//
//  This is a CUSTOMER control, on the front where she can reach it, not an
//  attendant control behind a lock. The reason is the money: by the time a
//  vend fails, her coin is already in the cash box and the machine owes her a
//  pad. Making her find a member of staff to get what she has paid for is the
//  wrong answer when the machine can simply try again.
//
//  Held for CLEAR_BTN_HOLD_MS it clears the fault AND KEEPS HER CREDIT, so the
//  machine dispenses on the next pass. A hold rather than a tap so that
//  brushing past it does nothing.
//
//  How many times she may retry before it stops listening. A jam that survives
//  this many attempts is not going to clear itself, and continuing just works
//  the coil against whatever is stuck. At that point it is genuinely a staff
//  problem: the console  x  still clears it, and so does a power cycle.
//  Reset by any successful delivery.
const uint8_t MAX_BUTTON_RETRIES = 3;

// What the screen tells her once the retries are gone and it really does need
// a person. Put the actual number that is printed on the machine here — a
// screen that says GET HELP without saying who to get is no help at all.
//
// SIXTEEN CHARACTERS MAXIMUM. The display is 16 x 2 and anything longer is
// silently cut off, which is worse than a short message.
//                                 |<-- 16 chars max -->|
const char *SERVICE_CONTACT      = SERVICE_CONTACT_TEXT; // set in service_contact.h

// --- RETRY BUTTON ----------------------------------------------------------
// Momentary NO button between PIN_CLEAR and GND. Mount it on the FRONT, where
// a customer can reach it: see the note above MAX_BUTTON_RETRIES. A press also
// wakes a sleeping screen.
const uint32_t CLEAR_BTN_DEBOUNCE_MS = 50;
const uint32_t CLEAR_BTN_HOLD_MS = 1000; // must be held, not brushed
const uint32_t FAULT_ROTATE_MS = 2000;   // LCD line 2 rotation

// ===========================================================================
//  SECTION 5 — TIMING
// ===========================================================================
//
//  Every delay and timeout in the machine, in one place.
//
//  Each one is written up the same way:
//
//    WHAT        what the number actually controls
//    TOO SHORT   what goes wrong if you set it too low
//    TOO LONG    what goes wrong if you set it too high
//    HOW TO SET  how to find the right value on the bench
//    CONSOLE     the live command, if it has one
//
//  Three can be changed from the console while the machine is running, so you
//  can hunt for the right number without reflashing every time. Those changes
//  are NOT saved — once you have the number, write it in here and flash it.
//
//  Quick index:
//    COIN_PULSE_DEBOUNCE_MS   noise filter on each individual coin pulse
//    COIN_GAP_MS              silence that means "that coin is finished"   [g]
//    DISPENSE_TIMEOUT_MS      give up waiting for the pad to drop          [o]
//    CREDIT_TIMEOUT_MS        forget part-payment nobody came back for
//    IR_DEBOUNCE_MS           noise filter on the drop beam
//    IR_SETTLE_MS             prove the chute is clear before starting
//    MESSAGE_HOLD_MS          how long "PLEASE COLLECT YOUR PAD" stays up
//    MOTOR_LIMIT_MARGIN_MS    the backstop that can never be reached normally
//    PAD_SWITCH_DEBOUNCE_MS   noise filter on the stock switch
//    IR_STUCK_WARN_MS         nag about something sitting in the chute
//

// ---------------------------------------------------------------------------
//  COIN_PULSE_DEBOUNCE_MS — noise filter on each individual coin pulse
// ---------------------------------------------------------------------------
//  WHAT        After a counted pulse, ignore every falling edge for this
//              long. Two falling edges closer together than this are one
//              pulse. This is NOT the gap between coins — that is COIN_GAP_MS.
//
//  WHY 75 AND NOT 20 — measured, and it cost real money to find.
//              The interrupt is set to FALLING, but on the ESP32 a rising
//              edge can also fire it: a glitch of a few microseconds on the
//              way up is enough. This acceptor's pulse is 50 ms LOW then
//              105 ms HIGH, so that false count lands exactly 50 ms after the
//              real one, where a 20 ms debounce does not reach it.
//
//              With the coin wired straight to the pin, EVERY rising edge fired
//              it, so every coin read exactly double and the coin table was
//              calibrated to the doubled numbers (2 / 10 / 20 / 40). The PC817
//              changed the edge shape and the false count became occasional:
//              a KSh 10 then read anywhere from 7 to 10, and coins were taken
//              and not credited. Console  P  recorded the raw waveform and
//              showed 5 clean pulses where the interrupt had counted 9.
//
//              75 ms sits between the false count (50 ms after a real one) and
//              the next real pulse (155 ms after it): 25 ms of margin on one
//              side, 80 ms on the other.
//  TOO SHORT   The false count on the rising edge comes back: coins read high
//              and at random.
//  TOO LONG    Real pulses get swallowed. At 155 ms or more, every second real
//              pulse is lost.
//  HOW TO SET  Run  P  and drop a coin. Set this between the LOW time and the
//              full LOW+HIGH period, with room on both sides. If the acceptor's
//              pulse speed setting is ever changed, measure again.
//  CONSOLE     none — needs a reflash
const uint32_t COIN_PULSE_DEBOUNCE_MS = 75;

// ---------------------------------------------------------------------------
//  COIN_GAP_MS — the silence that means "that coin is finished, count it"
// ---------------------------------------------------------------------------
//  WHAT        One coin is a burst of pulses. This is how long the line must
//              stay quiet before the firmware decides the burst has ended and
//              adds up what it counted. A KSh 40 coin is 20 pulses, 155 ms
//              apart, so its burst runs for about three seconds; this matters
//              more here than on a machine that only takes one coin type.
//  TOO SHORT   A single coin gets split in two. A KSh 20 (10 pulses) reads as
//              1 + 9: the first part is priced as KSh 5, the rest is unknown,
//              and the customer is short-changed by 15 shillings.
//  TOO LONG    Two coins inserted quickly get merged into one burst. Two KSh 5
//              coins become one 4-pulse "coin" that is in no table, and the
//              money is gone. The acceptor cannot physically deliver two coins
//              closer than about 600 ms, so that is your hard ceiling.
//  HOW TO SET  Drop one of each coin and read the PULSE TIMING line. Take the
//              WIDEST gap you see and roughly double it — that is your floor.
//              Then insert two coins as fast as the acceptor will take them
//              and confirm they still read as two. Anywhere comfortably
//              between those results is right. On this acceptor pulses are
//              155 ms apart (measured with  P ), so the floor is about 310 ms;
//              400 ms leaves margin below the 600 ms ceiling. The old 250 ms
//              only worked while the rising edge was also being counted,
//              which halved the apparent gap.
//  CONSOLE     g<ms>   e.g.  g350
uint32_t COIN_GAP_MS = 400;

// ---------------------------------------------------------------------------
//  DISPENSE_TIMEOUT_MS — how long to wait before deciding NOTHING DROPPED
// ---------------------------------------------------------------------------
//  This is the one to get right. It decides whether a perfectly good machine
//  starts throwing faults at people.
//
//  WHAT        The motor starts and the firmware watches the IR beam across
//              the chute. If a pad breaks that beam the motor stops and the
//              screen says PLEASE COLLECT. If nothing breaks it within this
//              time, the firmware concludes no pad came out. What happens then
//              depends on the stock switch:
//
//                stock switch says EMPTY  ->  goes to EMPTY, which recovers by
//                                             itself the moment you refill
//                stock switch says FULL   ->  it cannot be empty, so it is a
//                                             jam. Latches FAULT "JAMMED"
//                no stock switch fitted   ->  cannot tell, so it stays
//                                             cautious: FAULT "EMPTY OR
//                                             JAMMED"
//
//              Either way the motor stops and the console says plainly that
//              the customer paid for that pad and did not get it.
//  TOO SHORT   The machine gives up while the pad is still on its way out. You
//              get faults on a machine that works perfectly, and every one of
//              them takes a person with a key to clear. This is by far the
//              more likely mistake.
//  TOO LONG    The coil keeps turning after a real jam, which can chew a pad
//              or stall the motor, and the customer stands there waiting.
//  HOW TO SET  With the coil loaded, run the motor in fixed bursts until you
//              have timed ONE full revolution:
//
//                  m500     m1000     m1500     m2000   ...
//
//              The console prints the exact moment the beam broke, so you get
//              the real drop time rather than a guess. Set this to about
//              DOUBLE the slowest drop you saw. Margin here is cheap; a
//              phantom fault in a washroom is not.
//  CONSOLE     o<ms>   e.g.  o5000
//
//  7000 IS A PLACEHOLDER. It is not measured and must not be treated as if it
//  were.
//
//  Every timing in the log so far came from a finger being waved at the IR
//  sensor to mimic a pad, because the chute and panel do not exist yet. Those
//  numbers measure how fast somebody moves their hand. They say nothing about
//  how long a pad takes to fall, and the 3503 ms "slow drop" that this value
//  was derived from was a slow finger.
//
//  7000 is deliberately generous so bench work is not interrupted by faults
//  that mean nothing. It errs the safe way: too long only wastes a few
//  seconds on a real jam, while too short tells a paying customer the machine
//  is broken when it is not.
//
//  SET IT PROPERLY once pads fall down a real chute:
//    1. Load the coil and run twenty or thirty vends.
//    2. Read  slowest drop  from  s  — the firmware tracks it for you.
//    3. Set this to about twice that, with  o<ms>, then write it in here.
//  Status warns whenever the timeout drops under twice the slowest drop it
//  has actually seen, so the machine will tell you when this number is wrong.
uint32_t DISPENSE_TIMEOUT_MS = 7000;

// ---------------------------------------------------------------------------
//  CREDIT_TIMEOUT_MS — how long to keep asking for the rest of the money
// ---------------------------------------------------------------------------
//  WHAT        Somebody puts KSh 10 into a KSh 20 machine. For this long the
//              screen keeps telling her what to add and counts down the time
//              she has left, once a second. If the countdown reaches zero the
//              credit is cleared and the machine goes back to INSERT COIN.
//
//              >>> SET THIS TO 0 TO WAIT FOREVER. <<<
//              Zero means part payment never expires: the screen keeps asking
//              for the rest indefinitely, until somebody tops it up. Nothing
//              else changes.
//
//  THE HONEST  There is no refund path. The coin banks into the housing before
//  TRADE-OFF   this firmware hears a single pulse, so no value here gets the
//              money back to the person who paid it. All this number decides
//              is who ends up with it:
//
//                shorter   the business keeps abandoned part-payment
//                longer    she gets a better chance to find the second coin
//                0         the money always eventually buys a pad — but for
//                          whoever walks up next, not for her
//
//  TOO SHORT   A customer digging in her bag loses the coin she already put
//              in. Twenty seconds was not enough for that; two minutes is.
//  TOO LONG    A standing balance sits on the screen, and the next person
//              tops up a stranger's money and gets a discounted pad. With 0
//              that is permanent, which may be exactly what you want in a
//              school washroom and is certainly not what you want on a
//              machine that has to pay for itself.
//  HOW TO SET  Two minutes is the default because it is long enough to find a
//              coin, ask a friend, or give up honestly. Watch real users.
//  CONSOLE     w<ms>   e.g.  w120000,  or  w0  to wait forever
//              (shorten it to something like w15000 to test the countdown
//              without standing there for two minutes)
uint32_t CREDIT_TIMEOUT_MS = 120000; // 2 minutes. 0 = never expire.

// ---------------------------------------------------------------------------
//  IR_DEBOUNCE_MS — noise filter on the drop beam
// ---------------------------------------------------------------------------
//  WHAT        The beam must read the same for this long before the reading is
//              believed. Stops dust, a flickering sensor or the edge of the
//              coil from registering as a delivered pad.
//  TOO SHORT   Noise counts as a pad. The motor stops early and the customer
//              gets nothing while the screen cheerfully says PLEASE COLLECT.
//  TOO LONG    A fast-falling pad can clear the beam before the filter accepts
//              it, so a real delivery is missed and you get a phantom jam.
//  HOW TO SET  15 ms is right for a pad falling under gravity. If the console
//              reports a delivery under 150 ms it warns you, because that
//              usually means the sensor is seeing the coil rather than a pad —
//              re-aim the sensor rather than changing this.
//  CONSOLE     none — needs a reflash
const uint32_t IR_DEBOUNCE_MS = 15;

// ---------------------------------------------------------------------------
//  IR_SETTLE_MS — prove the chute is clear BEFORE the motor starts
// ---------------------------------------------------------------------------
//  WHAT        Before every vend the firmware watches the beam for this long
//              and refuses to start if anything is in the way. It will not run
//              the motor blind into a chute that already has something in it.
//              Nothing is charged if this check refuses: the credit stays on
//              the meter, because that is not the customer's fault.
//  TOO SHORT   A brief clear moment lets a vend start over a real blockage.
//  TOO LONG    A visible pause between paying and the motor starting, which
//              makes the machine feel broken.
//  HOW TO SET  150 ms is long enough to be sure and short enough to feel
//              instant. No reason to change it.
//  CONSOLE     none — needs a reflash
const uint32_t IR_SETTLE_MS = 150;

// ---------------------------------------------------------------------------
//  MESSAGE_HOLD_MS — how long "PLEASE COLLECT YOUR PAD" stays on the screen
// ---------------------------------------------------------------------------
//  WHAT        After a successful vend, how long the machine holds that
//              message before going back to INSERT COIN.
//  TOO SHORT   The customer looks up and the message is already gone, so she
//              is not sure anything happened.
//  TOO LONG    The next customer waits at a screen that is not ready for her.
//  HOW TO SET  Purely how it feels. 2.5 s reads comfortably at arm's length.
//  CONSOLE     none — needs a reflash
const uint32_t MESSAGE_HOLD_MS = 2500;

// ---------------------------------------------------------------------------
//  THE SALE, SCREEN BY SCREEN — how long each step is held
// ---------------------------------------------------------------------------
//  The machine says what it understood at every step instead of jumping
//  straight from a coin to a running motor:
//
//    a coin, short     THAT IS KSH 5!   / TOTAL KSH 5       COIN_ACK_MS
//    then              ADD KSH 15 MORE  / TIME LEFT 1:58    until next coin
//    price met         KSH 20 - PAID!   / A FULL PAD!       PAID_HOLD_MS
//    (KSh 40)          KSH 40 - PAID!   / 2 PADS COMING!
//    motor             HERE IT COMES... / (PAD 1 OF 2)      until it drops
//    delivered         PLEASE COLLECT   / YOUR PAD :)       MESSAGE_HOLD_MS
//    next of two       ONE MORE COMING  / PAD 2 OF 2        NEXT_PAD_HOLD_MS
//    done              THANK YOU!       / HAVE A GOOD DAY   THANKS_MS
//
//  None of these blocks. They are deadlines checked by loop(), so the beam and
//  the coin line are watched throughout.
//
//  PAID_HOLD_MS IS ALSO A MONEY RULE, not only a pause to read. The slot shuts
//  the instant the price is met, but a coin already rolling through the
//  acceptor cannot be stopped. Its pulses must finish arriving BEFORE the
//  motor starts, because the coin line is muted while the coil turns and a
//  burst caught by the mute is thrown away: coin in the box, nothing credited.
//  So the motor waits for the hold AND for the coin line to be quiet, up to
//  PAID_MAX_WAIT_MS (a KSh 40 is about three seconds of pulses).
//  CONSOLE     none — needs a reflash
const uint32_t COIN_ACK_MS = 1500;
const uint32_t PAID_HOLD_MS = 2000;
const uint32_t NEXT_PAD_HOLD_MS = 1000;
const uint32_t PAID_MAX_WAIT_MS = 8000;
const uint32_t THANKS_MS = 2000;

// ---------------------------------------------------------------------------
//  MOTOR_LIMIT_MARGIN_MS — the backstop, on top of DISPENSE_TIMEOUT_MS
// ---------------------------------------------------------------------------
//  WHAT        A hard ceiling on motor run time: DISPENSE_TIMEOUT_MS + this.
//              Checked on EVERY pass of loop(), in EVERY state, before
//              anything else runs, and it does not trust the state machine to
//              have stopped the motor. In normal operation it is unreachable,
//              because the dispense timeout always fires first.
//  TOO SHORT   It could fire during a slow but legitimate vend and report a
//              firmware bug that is not there.
//  TOO LONG    A genuinely runaway motor runs longer before anything catches
//              it.
//  HOW TO SET  Leave it. If this ever fires, the console says so and calls it
//              a firmware bug rather than a jam, because that is what it is.
//              Report it rather than raising this number.
//  CONSOLE     follows  o<ms>  automatically
const uint32_t MOTOR_LIMIT_MARGIN_MS = 2000;

// ---------------------------------------------------------------------------
//  MOTOR_NOISE_SETTLE_MS — how long the coin line stays untrusted after the
//                          motor stops
// ---------------------------------------------------------------------------
//  WHAT        The coin input is not counted while the motor is running, nor
//              for this long after it stops. Switching the relay and the coil
//              induces edges on GPIO 18 that look exactly like coin pulses —
//              on this machine, bursts of one or two with 21-50 ms gaps,
//              arriving the instant the motor starts or stops. A real coin
//              from this acceptor has 50-105 ms gaps and lasts seconds.
//
//              This is a HARDWARE problem and the flyback diode, the
//              capacitors and star wiring are the cure. Muting the input is
//              what stops the firmware spending money that was never inserted
//              while you fix it.
//  TOO SHORT   The turn-off spike still lands in a counted window. The relay
//              de-energising is the worst moment, not the start.
//  TOO LONG    A real coin inserted just after a vend is missed. The acceptor
//              needs about 600 ms per coin anyway, so there is room here.
//  HOW TO SET  Leave it at 500 unless the console reports discarded pulses on
//              every vend, which means the spike outlasts it. Status counts
//              them, so you can tell suppression working from suppression
//              missing.
//  CONSOLE     none — needs a reflash
const uint32_t MOTOR_NOISE_SETTLE_MS = 500;

// ---------------------------------------------------------------------------
//  PAD_SWITCH_DEBOUNCE_MS — noise filter on the pad stock switch
// ---------------------------------------------------------------------------
//  WHAT        How long the stock switch must read the same before the machine
//              believes it. A mechanical switch under a stack of pads chatters
//              badly as the stack shifts and settles, so this is debounced far
//              harder than any electronic sensor here.
//  TOO SHORT   The machine flips between in-service and OUT OF STOCK as the
//              stack settles, clicking the inhibit relay every time.
//  TOO LONG    A refill takes a noticeable moment to be noticed. Harmless.
//  HOW TO SET  Type  k  to watch the switch live, then work the lever and load
//              a stack. If the reading dances, raise this. 400 ms is a
//              deliberately generous starting point.
//  CONSOLE     none — needs a reflash
const uint32_t PAD_SWITCH_DEBOUNCE_MS = 400;

// ---------------------------------------------------------------------------
//  INHIBIT_SETTLE_MS — how long the stock switch is not believed after the
//                      coin-inhibit relay moves
// ---------------------------------------------------------------------------
//  WHAT        A blackout window. For this long after the inhibit relay is
//              driven to a new level, the stock switch is not sampled at all,
//              and its debounce clock is restarted so a change still has to
//              hold for PAD_SWITCH_DEBOUNCE_MS AFTER the window closes.
//
//  WHY IT EXISTS — this is a real fault, seen on this bench, not a precaution.
//              The machine sat in this loop, forever, a few times a second:
//
//                relay energises  ->  stock line reads EMPTY
//                enterEmpty()     ->  relay releases
//                relay releases   ->  stock line reads PADS PRESENT
//                back in service  ->  relay energises  ->  ...
//
//              The log gives the causation away by its ordering: every single
//              stock change landed immediately after a relay line, never on
//              its own. A switch under a stack of pads does not change state
//              in lockstep with a relay coil. The relay was moving the stock
//              line — through the rail, the ground, or coupling between the
//              two runs of wire.
//
//              It is not a cosmetic fault. Hammering a relay coil several
//              times a second reset the board twice: once TG1WDT_SYS_RESET
//              (interrupt watchdog) and once a Guru Meditation double
//              exception part-way through printing the self-test.
//
//  THE REAL FIX IS PHYSICAL. Separate the stock switch run from the relay
//              wiring, give the relay module its own supply decoupling, and
//              make the grounds meet at one point. This constant stops the
//              firmware amplifying the problem into a reset loop; it does not
//              make the coupling go away.
//
//  TOO SHORT   The oscillation comes back — the induced reading outlasts the
//              window and gets believed.
//  TOO LONG    A genuine refill or a genuine empty coil takes this long plus
//              PAD_SWITCH_DEBOUNCE_MS to be noticed. At 600 ms that is about
//              a second in the worst case, which nobody can perceive.
//  CONSOLE     none — needs a reflash
const uint32_t INHIBIT_SETTLE_MS = 600;

// ---------------------------------------------------------------------------
//  IR_STUCK_WARN_MS — how long a blocked beam at rest is tolerated
// ---------------------------------------------------------------------------
//  WHAT        If the beam reads BLOCKED for this long while the machine sits
//              idle, it goes to FAULT "CHECK SENSOR" and shuts the slot, so
//              nobody pays into a machine that cannot see a pad drop. That is
//              what an unplugged sensor looks like (with the 1 M pull-down
//              on GPIO 27, see WIRING.md), as well as a pad stuck in the chute.
//              It used to be a console warning only, and the beam was not
//              even read while idle, so an unplugged sensor went unnoticed.
//  TOO SHORT   A hand collecting a pad, or reaching into the chute, trips it.
//  TOO LONG    A dead sensor sits with the slot open for that long.
//  CONSOLE     none — needs a reflash
const uint32_t IR_STUCK_WARN_MS = 5000;

// ---------------------------------------------------------------------------
//  BEAM_CLEAR_RECOVER_MS — how long the beam must read clear to undo that
// ---------------------------------------------------------------------------
//  WHAT        A CHECK SENSOR or CHUTE BLOCKED fault caused by a blocked beam
//              clears ITSELF once the beam has read clear for this long: plug
//              the sensor back in, or take the pad out, and the machine goes
//              back to work without anyone holding the button. A boot halt for
//              a blocked chute re-runs the whole self-test first.
//              Jams (no pad within the dispense timeout) still latch: the beam
//              is clear during a jam, so it proves nothing there.
//  CONSOLE     none — needs a reflash
const uint32_t BEAM_CLEAR_RECOVER_MS = 3000;

// ---------------------------------------------------------------------------
//  SOAK TEST  (console command  T<n> )
// ---------------------------------------------------------------------------
//  How long a soak cycle waits for a pad before calling it a failure.
//
//  This is deliberately far longer than DISPENSE_TIMEOUT_MS, and that is the
//  whole point. You cannot measure the slowest drop with a stopwatch that
//  stops before it: a 6 s drop under a 5 s timeout is recorded as "no pad",
//  and the number you are hunting never appears. Keep this generous, find the
//  real distribution, then set the real timeout from it.
//
//  Like  m<ms> , a soak blocks, so the loop() motor backstop is not running
//  while it does. This ceiling is the only limit on one cycle. That is fine
//  for a command an operator types while watching the machine and wrong for
//  anything automatic, which is why nothing automatic uses it.
const uint32_t SOAK_MAX_WAIT_MS = 15000;

//  Pause between cycles: lets the pad clear the beam, the coil settle, and
//  gives you time to watch what the mechanism is actually doing.
const uint32_t SOAK_GAP_MS = 2000;

// ===========================================================================
//  SECTION 6 — SOUND
// ===========================================================================
//
//  This machine lives in a public washroom and its customer may well be
//  embarrassed to be standing at it. Sound is there to confirm that something
//  happened, not to announce it to the room. Keep every tone SHORT.
//
//  Each is a frequency in Hz and a duration in ms. The four are deliberately
//  distinguishable with your back turned:
//
//    COIN    high and very short   — "that went in"
//    REJECT  low and flat          — "no, try again" (unknown coin, or the
//                                    machine is busy, faulted or empty)
//    VEND    mid and brief         — "your pad is there"
//    FAULT   low and long          — "something is wrong"
//
//  The buzzer is non-blocking: beep() starts a note and returns immediately,
//  and buzzerService() in loop() stops it when the time is up. A vending
//  machine must never be sitting in delay() while a coin is going in.
//
// SOUND_ON — the machine's sounds, on or off. The client's decision
// (IMPROVEMENTS_BACKLOG.md, "Questions for Rebecca at commissioning", Q5).
//   true  = coin, reject, vend and fault tones, and the boot chirp
//   false = silent; the screen still says everything. The console's  b
//           still chirps, so the buzzer can be checked on the bench.
const bool SOUND_ON = true;

const uint16_t TONE_COIN_HZ = 2200;
const uint16_t TONE_COIN_MS = 60;
const uint16_t TONE_REJECT_HZ = 600;
const uint16_t TONE_REJECT_MS = 200;
const uint16_t TONE_VEND_HZ = 1800;
const uint16_t TONE_VEND_MS = 150;
const uint16_t TONE_FAULT_HZ = 350;
const uint16_t TONE_FAULT_MS = 500;

// ===========================================================================
//  SECTION 7 — WHAT THE CONSOLE DOES ON ITS OWN
// ===========================================================================

// Click the relay once during the boot self-test to prove it is alive.
// LEAVE THIS false UNTIL THE MOTOR IS DISCONNECTED. It jerks the coil.
const bool SELFTEST_CLICKS_RELAY = false;

// Print a one-line health report every so often. Useful for leaving a soak
// test running. Toggle it live with  h.
bool heartbeatOn = false;
const uint32_t HEARTBEAT_MS = 10000;

// --- FIELD LOGGING SWITCH --------------------------------------------------
// true  = the console narrates every coin, vend, warning and fault. What you
//         want on the bench and during commissioning.
// false = SHIP IT THIS WAY. Routine event chatter is silenced once the machine
//         is installed. Nothing else changes:
//           - the boot banner and the full self-test still print, always, so a
//             reset in the field still tells a service visit what it needs;
//           - every typed console command still answers in full. Plug a laptop
//             in, press s, and you get the whole status whatever this is set to.
//         Toggle it live with  L  if you want the chatter back for a minute.
const bool SERIAL_LOG_DEFAULT = true;

// Does the BOOT output print — the banner and the nine-part self-test?
//
//  true  = yes. What you want on the bench and during commissioning.
//  false = silent boot. The self-test still RUNS and still gates the machine
//          exactly as before; it just does not narrate. Nothing is skipped
//          and nothing is weakened.
//
//  SERIAL_LOG_DEFAULT alone does not give you this. The banner and self-test
//  are deliberately forced on in setup() regardless of it, so a field machine
//  set quiet was still printing about a second of text at every power-up.
//  This is the switch for that.
//
//  A FAILING SELF-TEST STILL SHOUTS. If the check fails with this off, it is
//  run again with logging forced on so the reason reaches the console. Silent
//  when healthy, loud when broken — a machine that refuses to work and will
//  not say why is worse than one that chatters.
//
//  Either way  d  still prints the whole thing on demand, because a typed
//  command always answers.
const bool SERIAL_LOG_BOOT = true;

// Refuse to leave setup() if the self-test found something fatal. The machine
// shows the fault on the LCD and waits rather than pretending to work.
const bool HALT_ON_SELFTEST_FAIL = true;

// --- LCD HEALTH ------------------------------------------------------------
// How often to rebuild the display even when nothing has disturbed it.
//
//  The event triggers (motor, relay, coin) catch the three things we KNOW dip
//  the rail. This catches the ones we do not: a spike from something else on
//  the mains, a marginal connector, cable pickup, a glitch nobody diagnosed.
//
//  It is the difference between a display that recovers from known causes and
//  one that cannot stay corrupted at all. In a machine that sits in a washroom
//  for months, that is worth 50 ms a minute.
//
//  Set to 0 to disable.
const uint32_t LCD_REFRESH_MS = 60000;

// ---------------------------------------------------------------------------
//  LCD_BOOT_WAIT_MS / LCD_REPROBE_MS — finding a screen that is slow to wake
// ---------------------------------------------------------------------------
//  WHAT        At power-up the 5 V rail ramps as its 1000 uF charges, and the
//              ESP32 can run its self-test before the LCD backpack is powered
//              enough to answer on I2C. The screen used to be looked for once:
//              miss it and the machine ran the whole session with a blank
//              screen while everything else worked (seen on the bench,
//              2026-10-08, on cold power-ups but never on an EN reset).
//              Now the self-test waits up to LCD_BOOT_WAIT_MS for it, and if
//              it is still missing, loop() looks again every LCD_REPROBE_MS and
//              brings the screen up the moment it answers.
//  CONSOLE     none — needs a reflash
const uint32_t LCD_BOOT_WAIT_MS = 2000;
const uint32_t LCD_REPROBE_MS = 5000;

// How long the machine sits untouched before the backlight goes out.
//
//  The backlight is nearly all of what this display consumes — roughly 20 mA
//  against 2 mA for the logic — and it is the only part of the LCD that wears.
//  A washroom machine is idle almost all of the time, so leaving it lit buys
//  nothing and costs the backlight's life.
//
//  It is also the cleanest possible refresh. Waking ALWAYS rebuilds the
//  display from scratch, and waking happens on the first coin pulse — so the
//  screen is at its freshest at the exact moment somebody starts using it.
//  Corruption that happened while nobody was looking never gets seen.
//
//  Only plain idle sleeps. A machine showing OUT OF ORDER or SORRY - NO PADS
//  stays lit, because that message is the whole point of it being there, and
//  a machine with credit on the meter stays lit because somebody is mid-
//  transaction.
//
//  Set to 0 to keep the backlight on always.
const uint32_t BACKLIGHT_TIMEOUT_MS = 120000; // 2 minutes

// ###########################################################################
// #                 END OF CONFIG.  Below here is machinery.                #
// ###########################################################################

// ===========================================================================
//  STATE
// ===========================================================================
//
//  The machine is always in exactly one of six states, and the state decides
//  two things: what is on the screen, and whether the coin acceptor is live.
//
//    ST_IDLE        Waiting for money. Coins accepted. Leaves here when
//                   credit reaches the price (-> PAID), or when the stock
//                   switch says the coil is empty.
//
//    ST_PAID        The price is met. The slot shuts at once, "KSH 20 -
//                   PAID!" holds for PAID_HOLD_MS, and the motor waits until
//                   the coin line is quiet so a coin already inside the
//                   acceptor is counted before the mute starts. -> DISPENSING.
//
//    ST_DISPENSING  Motor turning, watching the beam. Slot shut. Ends when a
//                   pad breaks the beam (-> DELIVERED) or when
//                   DISPENSE_TIMEOUT_MS runs out (-> EMPTY or FAULT).
//
//    ST_DELIVERED   Pad fell. "PLEASE COLLECT YOUR PAD" holds for
//                   MESSAGE_HOLD_MS, then back to IDLE: straight on to PAID if
//                   the credit buys another pad, else THANK YOU and the slot
//                   reopens.
//
//    ST_EMPTY       Stock switch says no pads. COINS INHIBITED. NOT a fault
//                   and NOT latched: it returns to IDLE on its own the moment
//                   the switch says pads are back, so a refill is all it takes
//                   and nobody has to drive out with a key.
//
//    ST_FAULT       Something is wrong that needs a person: a jam, a sensor
//                   reading wrong, or a failed self-test. COINS INHIBITED.
//                   LATCHED — it stays here until the clear button is held for
//                   CLEAR_BTN_HOLD_MS or  x  is typed, and even then it
//                   refuses while the beam still reads blocked.
//
//  THE RULE THE WHOLE DESIGN RESTS ON: the coin slot is live only in IDLE, and
//  only while the credit is short of a pad. It is derived in one line of
//  loop() and written nowhere else, so the slot can never disagree with what
//  the machine is doing.
//
//  It used to stay open during a vend, on the reasoning that a coin landing
//  mid-vend is banked. That stopped being true when the coin line was muted
//  around motor runs: a coin inserted while the coil turns has its pulses
//  binned, so the money was taken and never credited. Shutting the slot from
//  the moment the price is met until the pad is collected costs two relay
//  operations per sale (a relay is rated for 100,000+).
//
enum State
{
  ST_IDLE,
  ST_PAID,
  ST_DISPENSING,
  ST_DELIVERED,
  ST_EMPTY,
  ST_FAULT
};
State state = ST_IDLE;

const char *stateName(State s)
{
  switch (s)
  {
  case ST_IDLE:
    return "IDLE";
  case ST_PAID:
    return "PAID";
  case ST_DISPENSING:
    return "DISPENSING";
  case ST_DELIVERED:
    return "DELIVERED";
  case ST_EMPTY:
    return "EMPTY";
  case ST_FAULT:
    return "FAULT";
  }
  return "?";
}

LiquidCrystal_I2C lcd(LCD_I2C_ADDR, 16, 2);
bool lcdOk = false; // false = run headless, console only

// Set whenever the motor runs; cleared by the next say().
//
//  WHY THIS EXISTS. The LCD is driven over I2C in 4-BIT mode — every byte
//  goes across as two nibbles. If the display misses a single nibble, every
//  byte after it is shifted by four bits, and what comes out is not wrong
//  letters but gibberish: the HD44780 font has Japanese katakana at 0xA0-0xDF,
//  so mangled bytes land there and the screen fills with what look like
//  Chinese characters. It stays that way until the display is re-initialised,
//  because nothing about the LCD knows it lost sync.
//
//  What makes it miss a nibble is anything that dips the rail hard enough for
//  the LCD controller to brown out while the ESP32 — which has its own
//  regulator and a far better supply — carries on talking to it.
//
//  THREE THINGS ON THIS MACHINE DO THAT, and all three set this flag:
//
//    the motor        switching the coil is the biggest single dip
//    the inhibit relay  a relay coil de-energising kicks the rail
//    the acceptor     it fires a gate solenoid on EVERY coin it accepts or
//                     rejects, and it draws a surge when first powered
//
//  The acceptor is the one that catches people out, because it corrupts the
//  display on a bench with no motor connected at all — which is exactly what
//  happened on this build before the motor was even fitted.
//
//  So: after anything that kicks the rail, rebuild the display from scratch
//  before writing to it again. It costs about 50 ms, only at moments when the
//  screen was about to be repainted anyway, and it makes the symptom
//  self-clear instead of persisting until somebody power-cycles the machine.
//
//  This is a belt-and-braces measure, not a substitute for fixing the supply.
//  See README, "Funny symbols on the screen".
bool lcdNeedsReinit = false;
uint32_t lcdRefreshMs = 0;    // next scheduled rebuild, see LCD_REFRESH_MS
uint32_t lcdProbeMs = 0;      // next look for a screen missed at boot
bool backlightOn = true;      // false = asleep, see BACKLIGHT_TIMEOUT_MS
char lcdTopLine[17] = "";     // what say() last put on line 1
bool loopWdtOn = false;       // the loop watchdog is armed (end of setup)
uint32_t lastActivityMs = 0;  // last coin pulse or console command
uint32_t lastPulseTotal = 0;  // to spot a pulse the moment it arrives

// Coin pulses are counted in an ISR and decoded into whole coins in loop().
volatile uint16_t isrBurst = 0;
volatile uint32_t isrLastMs = 0;
volatile bool isrSeenOne = false;
volatile uint32_t isrTotal = 0; // every pulse ever, for diagnostics
portMUX_TYPE coinMux = portMUX_INITIALIZER_UNLOCKED;

// Gap statistics for the burst being counted right now. With a 20-pulse coin
// in the table these are the numbers that decide whether COIN_GAP_MS is safe,
// and there is no other way to see them. Reported with every coin.
// While this is true the coin interrupt counts nothing. Set the moment the
// motor starts and cleared MOTOR_NOISE_SETTLE_MS after it stops.
volatile bool coinMuted = false;
volatile uint32_t isrMutedPulses = 0; // how much noise we threw away, for status
uint32_t coinUnmuteMs = 0;

volatile uint16_t isrGapMin = 0xFFFF;
volatile uint16_t isrGapMax = 0;
volatile uint32_t isrBurstStartMs = 0;

// The coin interrupt is attached only once the self-test has passed. A machine
// that halted at boot must never return to service with this false, or the
// acceptor takes money the firmware cannot count.
bool coinIsrAttached = false;

Preferences prefs;   // holds only the meter balance
bool creditStoreOpen = false;     // did prefs.begin() ever succeed?
bool creditPersistOk = false;     // and are writes actually reaching flash?
uint32_t storeRetryMs = 0;        // next attempt to open a store that refused
bool creditPersistWarned = false; // shout about a failure once, not forever
uint16_t creditInFlash = 0;       // what we last successfully wrote

uint16_t credit = 0; // shillings on the meter
uint32_t lastCoinMs = 0;
uint32_t prevCoinMs = 0;        // the one before it, so the gap can be reported
bool holdForCollection = false; // a recovered pad, waiting for a person
uint32_t creditTickMs = 0; // next countdown repaint, see ST_IDLE
uint8_t idleMsgIdx = 0;    // which page of the idle prompt is showing
uint32_t idleRotateMs = 0; // next idle repaint
uint32_t dispenseStartMs = 0;
uint32_t messageUntilMs = 0;

// The sale's screens (see THE SALE, SCREEN BY SCREEN in SECTION 5).
bool bannerUp = false;       // IDLE leaves the screen alone while this is up
uint32_t bannerUntilMs = 0;  // ...until this deadline
uint32_t paidSinceMs = 0;    // when PAID began, or its hold was restarted
uint32_t paidHoldMs = 0;     // PAID_HOLD_MS, or NEXT_PAD_HOLD_MS mid-sale
uint16_t orderPads = 0;      // pads this sale is buying; 0 = no sale running
uint16_t orderIndex = 0;     // which of them is next, or being dispensed

// Debounced IR state
bool irRaw = false;
bool irStable = false;
uint32_t irChangedMs = 0;
uint32_t irBlockedSince = 0;
bool irStuckWarned = false;
bool irWatch = false; // console command  i

// Motor backstop
bool motorRunning = false;
uint32_t motorOnSince = 0;
uint32_t lastMotorRunMs = 0;  // how long the last run lasted
uint32_t mutedMotorMs = 0;    // total motor time since the coin line was muted
uint32_t inhibitChangedMs = 0; // when the inhibit relay was last driven to a
                               // NEW level. Two things hang off it: the stock
                               // switch is deaf for INHIBIT_SETTLE_MS after it,
                               // and the slot is never re-opened sooner than
                               // that after it was closed.
uint32_t slowestDropMs = 0;   // worst delivery this session, sets the timeout

// Counters. RAM only, and reset on every boot. The meter balance is the
// only thing that survives a power cut — see setCredit().
uint32_t vendCount = 0;
uint32_t coinsAccepted = 0;
uint32_t coinsUnknown = 0;
uint32_t faultCount = 0;
uint32_t shillingsIn = 0;
uint32_t noisePulses = 0; // induced pulses discarded, a suppression health check
uint32_t bootMs = 0;

// Loop health
uint32_t loopMaxUs = 0;
uint32_t lastBeatMs = 0;

// Self-test verdict
bool selfTestPassed = false;
char haltReason[24] = "";

// Serial console line buffer
char cmdBuf[32];
uint8_t cmdLen = 0;
uint32_t cmdLastMs = 0;
const uint32_t CMD_IDLE_FLUSH_MS = 80; // makes "No line ending" monitors work

// millis() wraps after ~49.7 days and this machine is meant to run for months,
// so never compare two timestamps directly. Signed difference is wrap-safe.
static inline bool reached(uint32_t now, uint32_t deadline)
{
  return (int32_t)(now - deadline) >= 0;
}

// Milliseconds since a timestamp, clamped at zero.
//
//  THE BUG THIS EXISTS TO KILL, because it cost a whole bench session.
//
//  loop() reads `now` once at the top. Anything that stamps a timestamp with
//  millis() LATER in that same pass produces a value AHEAD of `now`. The
//  unsigned subtraction (now - stamp) then wraps to about 4.29 billion, and
//  every "has enough time passed?" test built on it fires instantly.
//
//  That is exactly what broke part payment: bankCoin() stamped lastCoinMs with
//  millis(), the credit timeout compared it against the stale `now`, and a
//  KSh 5 was cleared on the very pass it was banked. It only showed on 5 and
//  10 because 20 and 40 meet the price and vend before the timeout is reached.
//
//  So: never write (now - stamp) directly. Use sinceMs() to measure, and
//  reached(now, stamp + interval) to decide — both are correct whether the
//  stamp is behind, level with, or slightly ahead of `now`, and both survive
//  the millis() rollover as well.
static inline uint32_t sinceMs(uint32_t now, uint32_t stamp)
{
  int32_t d = (int32_t)(now - stamp);
  return (d > 0) ? (uint32_t)d : 0;
}

static inline uint32_t motorHardLimitMs()
{
  return DISPENSE_TIMEOUT_MS + MOTOR_LIMIT_MARGIN_MS;
}

// attemptClear() is defined above both of these but has to call them.
bool selfTest(bool verbose);
void attemptClear(const char *who, bool fromButton);
void attachCoinIsr();
static bool vendInFlight();
void repaintForState();
void wakeDisplay();
void sleepDisplay();
void soakTest(uint16_t cycles);
bool chuteClear();
bool ensureCreditStore();

// Debounced pad stock switch
bool padsRaw = true;
bool padsStable = true;
uint32_t padsChangedMs = 0;
bool stockWatch = false; // console command  k

// Stock-switch flap detector. A coil being refilled changes state once or
// twice. A line picking up the relay changes state over and over, and that
// pattern is worth shouting about because it is the one that resets the board.
uint16_t stockFlaps = 0;        // settled changes inside the current window
uint32_t stockFlapWindowMs = 0; // when the current 60 s window started
bool stockFlapWarned = false;   // warn once per window, not once per flap
uint32_t emptyRotateMs = 0;
uint8_t emptyMsgIdx = 0;

// added section on purpose of disabling the coin acceptor when jammed
bool coinsAllowed = false; // starts inhibited, on purpose
bool clearBtnRaw = false;
bool clearBtnStable = false;
uint32_t clearBtnChangedMs = 0;
uint32_t clearBtnDownMs = 0;
bool clearBtnHandled = false;
uint8_t buttonRetries = 0;     // consecutive button clears with no pad delivered
uint32_t lastRefusalMs = 0;    // rate-limit the out-of-retries message
bool serviceCycleSeen = false; // stock switch went EMPTY during a fault
char faultLine2[17] = "";
bool faultClearsWhenBeamClear = false; // a beam fault, undone by a clear beam
uint32_t beamClearSinceMs = 0;         // when the beam last turned clear in FAULT
bool beamClearTiming = false;
uint8_t faultMsgIdx = 0;
uint32_t faultRotateMs = 0;

// ===========================================================================
//  ISR — counting coin pulses without missing any
// ===========================================================================
//
//  HOW A MULTI-COIN ACCEPTOR TALKS
//  It does not say "that was twenty shillings". It pulls one line LOW a fixed
//  number of times, quickly, and the NUMBER OF PULSES identifies which coin it
//  was. On this machine: 1 pulse = KSh 5, 5 = KSh 10, 10 = KSh 20,
//  20 = KSh 40. See SECTION 2.
//
//  So reading a coin is two jobs, and they are split in two on purpose:
//
//    onCoinPulse()  runs in an interrupt, on the falling edge of every pulse.
//                   It does the absolute minimum — count, timestamp, return —
//                   because an interrupt that dawdles loses the next pulse.
//                   It also debounces, so one pulse is never counted twice,
//                   including the false FALLING interrupt an ESP32 can fire on
//                   the pulse's rising edge (COIN_PULSE_DEBOUNCE_MS).
//
//    takeCoin()     runs in loop(). It watches for the line to go quiet for
//                   COIN_GAP_MS, which is what "that coin is finished" looks
//                   like, and only then hands the finished count over to be
//                   priced.
//
//  It also measures the gaps between pulses as it goes, because with a
//  20-pulse coin those numbers are the only way to know whether COIN_GAP_MS
//  has enough margin on both sides. They print with every coin.
//
void IRAM_ATTR onCoinPulse()
{
  uint32_t now = millis();
  portENTER_CRITICAL_ISR(&coinMux);

  // THE COIN LINE IS NOT TRUSTED AROUND A MOTOR RUN.
  //
  //  Switching the relay and the coil induces edges on this pin that are
  //  indistinguishable from coin pulses at the input, and they arrive in ones
  //  and twos — which is exactly the pulse count of the cheapest coin in the
  //  table. Counted, they become credit nobody paid, and credit nobody paid
  //  becomes pads nobody paid for.
  //
  //  Inhibiting the acceptor does NOT help here: that stops the mechanism
  //  taking a coin, it does nothing about induced voltage on a signal wire.
  //  The only reliable answer in firmware is to stop counting.
  if (coinMuted)
  {
    isrMutedPulses++;
    portEXIT_CRITICAL_ISR(&coinMux);
    return;
  }
  // isrLastMs starts at 0, so a plain debounce guard would swallow a coin
  // dropped in the first COIN_PULSE_DEBOUNCE_MS after boot. isrSeenOne makes
  // the first pulse unconditional and debounces every one after it.
  if (!isrSeenOne || (now - isrLastMs) >= COIN_PULSE_DEBOUNCE_MS)
  {
    if (isrBurst == 0)
    {
      isrBurstStartMs = now;
      isrGapMin = 0xFFFF;
      isrGapMax = 0;
    }
    else
    {
      uint32_t g = now - isrLastMs;
      if (g > 0xFFFF)
        g = 0xFFFF;
      if (g < isrGapMin)
        isrGapMin = (uint16_t)g;
      if (g > isrGapMax)
        isrGapMax = (uint16_t)g;
    }
    isrSeenOne = true;
    // Saturate rather than wrap. A noisy or oscillating coin line could
    // otherwise count past 65535 and come back round onto a number that
    // matches a real coin in the table — free pads, from electrical noise.
    // Stopped here, a runaway burst stays an absurd number, matches nothing,
    // and is refused.
    if (isrBurst < 1000)
      isrBurst++;
    isrTotal++;
    isrLastMs = now;
  }
  portEXIT_CRITICAL_ISR(&coinMux);
}

// A coin is "finished" once the acceptor has been quiet for COIN_GAP_MS.
// Returns true and hands back the pulse count exactly once per coin.
// True while a coin's pulses are still arriving. PAID waits on this, so a
// coin already inside the acceptor when the slot shut is counted before the
// motor starts and the mute would bin it.
bool coinBurstInProgress()
{
  portENTER_CRITICAL(&coinMux);
  bool busy = isrBurst > 0;
  portEXIT_CRITICAL(&coinMux);
  return busy;
}

bool takeCoin(CoinBurst &b)
{
  bool ready = false;
  portENTER_CRITICAL(&coinMux);
  if (isrBurst > 0 && (millis() - isrLastMs) >= COIN_GAP_MS)
  {
    b.pulses = isrBurst;
    b.gapMin = (isrGapMin == 0xFFFF) ? 0 : isrGapMin;
    b.gapMax = isrGapMax;
    b.durMs = isrLastMs - isrBurstStartMs;
    isrBurst = 0;
    ready = true;
  }
  portEXIT_CRITICAL(&coinMux);
  return ready;
}

// Ceiling on the meter, as a hard stop rather than an assumption.
//
//  In normal operation credit never climbs anywhere near this: the machine
//  vends the instant credit reaches the price, so it cannot exceed PAD_PRICE
//  plus one coin before dropping again. Coins are refused outright in EMPTY
//  and FAULT, so it cannot pile up there either.
//
//  It exists because "cannot happen" is a bad thing to rely on in the one
//  variable that represents somebody's money. If a future state ever holds
//  credit without spending it, this stops a 16-bit counter wrapping and
//  handing the next customer a fortune. If it ever trips, that is a firmware
//  bug and the console says so.
const uint16_t MAX_CREDIT = 10000;

// THE ONLY PLACE THE METER IS EVER WRITTEN.
//
//  Everything that moves money goes through here so the stored copy can never
//  drift from the live one. There is no way to change credit somewhere else
//  and forget to persist it, because nothing else assigns to it.
//
//  TWO THINGS HERE ARE NOT OBVIOUS, AND BOTH WERE WRONG ONCE.
//
//  First, Preferences does NOT skip a write when the value is unchanged. It
//  goes straight to nvs_set_u16() + nvs_commit() every time — checked in the
//  core source, not assumed. The creditInFlash shadow below is what actually
//  makes "identical writes are free" true, rather than a hope about somebody
//  else's implementation.
//
//  Second, putUShort() returns 0 when it fails, including when begin() never
//  succeeded, and ignoring that is exactly the failure this whole feature
//  exists to prevent: the machine would think a balance was safe, say so, and
//  lose it at the next power cut with nothing logged.
//
//  A failure does NOT stop the machine trading. Refusing sales because flash
//  is unhappy helps nobody — it just turns a degraded machine into a dead one.
//  What it does is say so, loudly and once, and keep saying so in status and
//  in the self-test, so the power-cut protection is never quietly absent.
void setCredit(uint16_t value)
{
  credit = value;
  if (!REMEMBER_CREDIT_ACROSS_POWER_LOSS)
    return;

  // A store that refused at boot may be available now. This also seeds
  // creditInFlash, without which the overstated-balance check below is blind.
  ensureCreditStore();

  // Nothing to write. Only trust this when the last write actually landed,
  // otherwise a retry of the same value would be skipped forever.
  if (creditPersistOk && value == creditInFlash)
    return;

  if (prefs.putUShort("credit", value) != 0)
  {
    creditInFlash = value;
    if (!creditPersistOk)
    {
      creditPersistOk = true;
      creditPersistWarned = false;
      LOGLN(F("The meter balance is being saved again."));
    }
    return;
  }

  creditPersistOk = false;

  // NEVER LEAVE THE STORED BALANCE ABOVE THE REAL ONE.
  //
  //  The two directions of error are not equally bad, and that asymmetry is
  //  the whole rule:
  //
  //    stored ABOVE the truth  the next boot over-credits. If it holds a full
  //                            pad's worth the machine wakes up, believes it
  //                            owes a pad, and vends one into an empty
  //                            washroom where it is simply lost. Part payment
  //                            hands a discount to whoever walks up next.
  //                            DANGEROUS.
  //
  //    stored BELOW the truth  the next boot under-credits. The customer
  //                            recovers part of her claim instead of all of
  //                            it, which is worse for her than a working
  //                            machine but better than nothing, and it can
  //                            never produce a pad nobody paid for. SAFE.
  //
  //  So a stored value already at or below the meter is left exactly where it
  //  is. Clearing it would destroy a claim that was saved successfully,
  //  earlier, for no safety benefit at all — somebody who put in KSh 10, had
  //  it stored, then added a second KSh 10 whose write failed would lose BOTH
  //  coins instead of keeping the one that was safe.
  //
  //  Only an overstated balance is worth writing over, and zero is the safest
  //  thing to put there. If that write fails too, nothing is lost that was not
  //  already lost.
  if (creditInFlash > value && prefs.putUShort("credit", 0) != 0)
  {
    creditInFlash = 0;
    LOGLN(F("!! The stored balance was higher than the meter, so it has been"));
    LOGLN(F("!! cleared — a reset must not restore it and vend a pad nobody"));
    LOGLN(F("!! paid for. A stored balance BELOW the meter is left alone."));
  }

  if (!creditPersistWarned)
  {
    creditPersistWarned = true;
    LOGLN();
    LOGLN(F("!! THE METER BALANCE IS NOT REACHING FLASH."));
    LOG(F("!! KSH "));
    LOG(value);
    LOGLN(F(" is on the meter in RAM only, and a power cut will"));
    LOGLN(F("!! lose it — the exact thing this is supposed to prevent."));
    LOGLN(F("!! The machine keeps trading; stopping would not help anybody."));
    LOGLN(F("!! Check the NVS partition. Status and  d  both report this."));
  }
}

// Open the credit store, or keep trying if it refused at boot.
//
//  WHY THIS RETRIES AT ALL. If prefs.begin() fails during setup() we cannot
//  read what is in NVS, so we do not know whether an old balance is sitting in
//  there. Everything downstream is then blind: the "is the stored value too
//  high" check compares against a creditInFlash of zero and can never fire, so
//  an old balance survives the whole session untouched. If NVS then opens
//  normally on some later boot, that balance is restored as gospel and can
//  vend a pad nobody paid for. The danger is not the failure, it is the
//  failure being invisible.
//
//  Note prefs.begin() returns FALSE when the store is already open, so this
//  has to track "open" separately from "writes are working" — calling begin()
//  again on a healthy store would otherwise look like a failure.
bool ensureCreditStore()
{
  if (creditStoreOpen)
    return true;
  if (!prefs.begin("padvend", false))
    return false;

  creditStoreOpen = true;

  // Same optimistic assumption setup() makes: a store that opens is presumed
  // to write until a write actually fails. Without this the alarm raised when
  // it would not open stays latched forever, and  s  and  d  keep reporting a
  // flash fault that has healed — sending somebody to chase a problem that is
  // no longer there. A diagnostic that lies is worse than no diagnostic.
  creditPersistOk = true;
  creditPersistWarned = false;

  uint16_t stored = prefs.getUShort("credit", 0);
  creditInFlash = stored;

  LOG(F("Credit store opened late. It holds KSH "));
  LOGLN(stored);

  //  ANYTHING FOUND NOW IS STALE BY DEFINITION. The boot restore has already
  //  been and gone; this balance belongs to a session we could not read. It is
  //  not restored, because hours may have passed and the machine has been
  //  trading without it. It is reconciled DOWN to the meter for the same
  //  reason as everywhere else: a stored value above the truth can vend a pad
  //  nobody paid for, one at or below it cannot.
  if (stored > credit)
  {
    if (prefs.putUShort("credit", credit) != 0)
    {
      creditInFlash = credit;
      LOGLN(F("  Stale and higher than the meter, so it has been overwritten."));
      LOGLN(F("  A later boot cannot now restore it and vend an unpaid pad."));
    }
    else
    {
      // The store opens but will not take data. That is the other failure, and
      // it is now proven rather than assumed, so say so.
      creditPersistOk = false;
      creditPersistWarned = true;
      LOGLN(F("  Stale and higher than the meter, but it will not overwrite."));
      LOGLN(F("  The store opens and refuses writes. A later boot could still"));
      LOGLN(F("  restore this and vend an unpaid pad."));
    }
  }
  return true;
}

// The only place money is added to the meter. Returns false if it refused.
bool bankCoin(const CoinDef *coin)
{
  if ((uint32_t)credit + coin->value > MAX_CREDIT)
  {
    LOGLN(F("!! CREDIT CEILING HIT. Coin NOT banked."));
    LOGLN(F("!! Credit is not being spent when it should be. That is a"));
    LOGLN(F("!! firmware bug, not a coin problem. Report it."));
    return false;
  }
  setCredit(credit + coin->value);
  shillingsIn += coin->value;
  coinsAccepted++;
  // millis() here is AHEAD of the `now` loop() is holding, because this runs
  // later in the same pass. Everything that reads lastCoinMs goes through
  // reached() or sinceMs() for exactly that reason — see sinceMs().
  prevCoinMs = lastCoinMs; // keep the old stamp: the gap is measured from it
  lastCoinMs = millis();
  return true;
}

const CoinDef *lookupCoin(uint16_t pulses)
{
  for (uint8_t i = 0; i < COIN_TABLE_LEN; i++)
  {
    if (COIN_TABLE[i].pulses == pulses)
      return &COIN_TABLE[i];
  }
  return nullptr;
}

// The only place the coin interrupt is ever attached. Everything that puts the
// machine into service goes through here, so there is one thing to check when
// asking "can this machine actually count a coin right now?".
void attachCoinIsr()
{
  if (coinIsrAttached)
    return;
  attachInterrupt(digitalPinToInterrupt(PIN_COIN), onCoinPulse, FALLING);
  coinIsrAttached = true;
  LOGLN(F("Coin interrupt attached."));
}

// ===========================================================================
//  HARDWARE HELPERS
// ===========================================================================
void motorOn()
{
  // Mute BEFORE the relay moves, and bin any burst already in progress — a
  // coin that was still being read when a vend started cannot be trusted now
  // that noise is about to be mixed into it.
  // A soak blocks, so loop() never runs between its cycles and the mute is
  // never released. Motor time therefore has to ACCUMULATE across every run in
  // one mute window, or the pulse count gets divided by the last cycle alone
  // and reports a rate several times too high.
  if (!coinMuted)
    mutedMotorMs = 0; // a fresh mute window starts a fresh total

  portENTER_CRITICAL(&coinMux);
  coinMuted = true;
  isrBurst = 0;
  portEXIT_CRITICAL(&coinMux);

  digitalWrite(PIN_RELAY, RELAY_ACTIVE_HIGH ? HIGH : LOW);
  motorOnSince = millis();
  motorRunning = true;
  lcdNeedsReinit = true; // the coil kick is what corrupts the display
}

void motorOff()
{
  digitalWrite(PIN_RELAY, RELAY_ACTIVE_HIGH ? LOW : HIGH);
  lastMotorRunMs = millis() - motorOnSince;
  mutedMotorMs += lastMotorRunMs;
  motorRunning = false;
  // The coil collapsing as the relay opens is the WORST moment for induced
  // pulses, worse than starting. Keep the line muted well past it.
  coinUnmuteMs = millis() + MOTOR_NOISE_SETTLE_MS;
}

// Turn the coin slot on or off, through the second relay.
//
//  Called from exactly two places: once in setup() before any state exists,
//  and once per pass of loop() from the single rule that derives the slot from
//  the machine's state. Nothing else touches it, so the slot can never
//  disagree with what the machine is doing.
//
//  Writing the same level repeatedly costs nothing and does not chatter the
//  relay — the pin simply stays where it is. Only a real change is logged.
//
//  There are two independent polarities to get right here, which is why this
//  is a function and not a digitalWrite:
//
//    INHIBIT_CONTACT_IS_NC       which relay contact you wired to the acceptor
//    INHIBIT_RELAY_ACTIVE_HIGH   which way the relay module's input works
//
//  With the shipped settings (NC contact, active-HIGH module) it works out as:
//
//      want        contact      relay      pin
//      ----------  -----------  ---------  ------
//      inhibit     closed       off        LOW
//      accept      open         on         HIGH
//
//  The NC contact is the important half. Closed means inhibited, and a relay
//  with no power sits closed — so an unpowered, booting, halted or crashed
//  controller refuses money instead of eating it. Change INHIBIT_CONTACT_IS_NC
//  only if you also move the wire.
//
//  WHAT THIS CANNOT DO. Inhibit stops the acceptor taking the NEXT coin. It
//  cannot give back one already taken. The acceptor banks a coin into the cash
//  box and only then sends its pulses, so by the time this firmware knows any
//  money arrived, that money is physically in the housing with no path back
//  out. There is no eject, no return chute and no hopper anywhere in this
//  machine.
//
//  That single fact shapes the whole money design. The firmware cannot refund,
//  so it must instead never lose track of what it owes: credit is taken off
//  the meter only when a pad is confirmed delivered, and a full pad's worth of
//  credit is never quietly timed out. See ST_DISPENSING and ST_EMPTY.
void coinAcceptorAllow(bool allow)
{
  uint32_t now = millis();

  //  ONE-WAY RATE LIMIT. Closing the slot happens on the instant, always.
  //  Re-opening it waits until INHIBIT_SETTLE_MS has passed since the relay
  //  last moved.
  //
  //  This is deliberately asymmetric, because the two directions are not
  //  equally dangerous. Blocking money a moment early costs nothing. Letting
  //  money in a moment early is how a machine takes a coin it cannot honour.
  //  So the delay only ever applies to the direction that risks the customer's
  //  money, and never to the direction that protects it.
  //
  //  It also drains the oscillation described at INHIBIT_SETTLE_MS: a relay
  //  that cannot be re-energised for 600 ms cannot chatter at several hertz,
  //  whatever the stock line does.
  //
  //  Nothing is lost by returning here. loop() calls this on every single pass
  //  from one rule, so a deferred open simply happens on a later pass — there
  //  is no queue to remember and nothing to retry by hand.
  if (allow && !coinsAllowed && !reached(now, inhibitChangedMs + INHIBIT_SETTLE_MS))
    return;

  bool contactClosed = !allow; // closed == inhibited
  bool energised = INHIBIT_CONTACT_IS_NC ? !contactClosed : contactClosed;
  bool level = (energised == INHIBIT_RELAY_ACTIVE_HIGH);
  digitalWrite(PIN_INHIBIT, level ? HIGH : LOW);
  if (allow != coinsAllowed)
  {
    coinsAllowed = allow;
    inhibitChangedMs = now; // starts the stock switch's deaf window
    // A relay coil collapsing kicks the rail. Treat the display as suspect.
    lcdNeedsReinit = true;

    // Print the ELECTRICAL intent, not just the word. "Coins inhibited" only
    // says what the firmware decided; this says what it did to the pin and
    // what it expects the relay to do about it. If the relay disagrees with
    // the last line here, the fault is in the wiring or in
    // INHIBIT_RELAY_ACTIVE_HIGH — and it is no longer a matter of opinion.
    LOG(F("  [GPIO "));
    LOG(PIN_INHIBIT);
    LOG(F(" driven "));
    LOG(level ? F("HIGH") : F("LOW"));
    LOG(F(" -> expect the relay to be "));
    LOG(energised ? F("ENERGISED") : F("RELEASED"));
    LOG(F(", contact "));
    LOGLN(contactClosed ? F("CLOSED = slot blocked]") : F("OPEN = slot live]"));
    LOG(F("Coin acceptor "));
    LOGLN(allow ? F("ENABLED") : F("INHIBITED — coins will be returned"));
  }
}

void armClearButtonForNewFault()
{
  // Snapshot the clear button's raw level right now and mark it already
  // handled. A hold already in progress — or a line stuck/shorted low —
  // can't ride straight into clearing THIS fault. It has to be seen
  // released, then pressed and held fresh, same as a human would do it.
  clearBtnRaw = clearBtnStable = (digitalRead(PIN_CLEAR) == LOW);
  clearBtnHandled = true;
}

// ---------------------------------------------------------------------------
//  Buzzer.  tone() only exists from ESP32 core 3.0 onward; before that the
//  buzzer has to be driven through the LEDC peripheral. This works on both, so
//  the sketch compiles whichever core is installed.
//
//  It is also non-blocking on both: beep() starts the note and returns, and
//  buzzerService() silences it when the time is up. A vending machine must not
//  sit in delay() while a coin is going in.
// ---------------------------------------------------------------------------
#ifndef ESP_ARDUINO_VERSION_MAJOR
#define ESP_ARDUINO_VERSION_MAJOR 2
#endif

const uint8_t BUZZER_LEDC_CH = 0;
uint32_t buzzUntilMs = 0;
bool buzzing = false;

// SILENT MEANS THE PIN HELD HIGH, NOT LOW.
//
//  The buzzer module switches its coil with a 9012, a PNP transistor: the
//  coil is ON while the input is LOW. A passive buzzer makes no sound on
//  steady DC, so a pin left LOW between beeps is silent but drives current
//  through the coil the whole time, and the module ran warm.
//  ledcWriteTone(ch, 0), which this used to silence with, sets 0% duty: LOW.
//  So between beeps the pin is taken off the PWM channel and driven HIGH.
//
//  HIGH only turns the PNP fully off if the module's VCC is the same 3.3 V.
//  From a 5 V VCC a 3.3 V HIGH still leaves ~1.7 V across emitter-base and
//  the transistor stays partly on, so the module is powered from the ESP32's
//  3V3 pin (WIRING.md section 6).
void buzzerSilence()
{
#if ESP_ARDUINO_VERSION_MAJOR < 3
  ledcDetachPin(PIN_BUZZER);
#else
  noTone(PIN_BUZZER);
#endif
  pinMode(PIN_BUZZER, OUTPUT);
  digitalWrite(PIN_BUZZER, HIGH);
}

void buzzerInit()
{
#if ESP_ARDUINO_VERSION_MAJOR < 3
  ledcSetup(BUZZER_LEDC_CH, 2000, 8);
#endif
  buzzerSilence();
}

// Plays whatever SOUND_ON says. Use toneOut() only for the bench test.
void toneOut(uint16_t hz, uint16_t ms);
void beep(uint16_t hz, uint16_t ms)
{
  if (SOUND_ON)
    toneOut(hz, ms);
}
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
void loop()
{
  uint32_t loopStartUs = micros();
  uint32_t now = millis();

  // A live watch is an explicit request to see something, so it overrides the
  // field logging switch for as long as it is running.
  logOn = logEvents || irWatch || stockWatch;

  buzzerService();
  pollSerial();
  clearButtonService();

  // ---- Trust the coin line again once the motor has been still a while ----
  if (coinMuted && !motorRunning && reached(now, coinUnmuteMs))
  {
    uint32_t junk;
    portENTER_CRITICAL(&coinMux);
    junk = isrMutedPulses;
    isrMutedPulses = 0;
    isrBurst = 0; // anything counted during the window is noise by definition
    coinMuted = false;
    portEXIT_CRITICAL(&coinMux);

    if (junk)
    {
      noisePulses += junk;
      LOG(F("Discarded "));
      LOG(junk);
      LOG(junk == 1 ? F(" pulse induced by the motor over ")
                    : F(" pulses induced by the motor over "));
      LOG(mutedMotorMs);
      LOGLN(F(" ms of running."));

      //  THE RATE IS THE DIAGNOSIS, not the count. Two quite different faults
      //  produce noise here and they need different parts:
      //
      //    a FIXED burst per run, whatever the run length, is the relay coil
      //    and the motor's field collapsing as it switches — a flyback diode
      //    across the motor is the cure;
      //
      //    a STEADY RATE that scales with run time is continuous arcing at the
      //    brushes, and a flyback diode does nothing for it. That wants
      //    capacitors across the motor terminals.
      //
      //  Printing per-second lets the bench tell them apart at a glance.
      if (mutedMotorMs > 100)
      {
        uint32_t perSec = (junk * 1000UL) / mutedMotorMs;
        LOG(F("  That is about "));
        LOG(perSec);
        LOGLN(F(" per second of motor run."));
        if (perSec > 20)
        {
          LOGLN(F("  A steady rate like that is brush arcing, not the switching"));
          LOGLN(F("  spike, so a flyback diode alone will not fix it. Fit a"));
          LOGLN(F("  ceramic across the motor terminals — anything from 10 to"));
          LOGLN(F("  100 nF helps, bigger cuts more. See README."));
        }
      }
      if (noisePulses == junk)
        LOGLN(F("  Not coins. Every one would have been free credit."));
    }
  }

  // ---- Wake on the FIRST pulse, not on the finished coin ----
  //
  //  takeCoin() does not hand a coin over until the acceptor has been quiet
  //  for COIN_GAP_MS, and on a 20-pulse coin that is seconds away. Watching
  //  the raw pulse counter instead lights the screen the instant her coin
  //  registers, which is when she is looking at it.
  uint32_t pulsesNow = isrTotal;
  if (pulsesNow != lastPulseTotal)
  {
    lastPulseTotal = pulsesNow;
    wakeDisplay();
  }

  // ---- Sleep only when there is genuinely nothing to show ----
  if (BACKLIGHT_TIMEOUT_MS > 0 && backlightOn && state == ST_IDLE &&
      credit == 0 && reached(now, lastActivityMs + BACKLIGHT_TIMEOUT_MS))
  {
    sleepDisplay();
  }

  // ---- Backstop. Checked in every state, before anything else can run. ----
  // Nothing below this line is trusted to stop the motor on its own.
  if (motorRunning && reached(now, motorOnSince + motorHardLimitMs()))
  {
    motorOff();
    LOGLN(F("!! Hard motor limit hit. The state machine did not stop it."));
    LOGLN(F("!! That is a firmware bug, not a jam. Report it."));
    enterFault("MOTOR RUNAWAY");
  }

  // ---- Read the beam on EVERY pass ----
  //  padSeen() is a debouncer and only knows what it was last asked. It used
  //  to be polled only during a vend, so at rest the machine never noticed an
  //  unplugged sensor or a pad stuck in the chute. One digitalRead per pass.
  padSeen();

  // ---- Live IR watch, for aiming the sensor ----
  if (irWatch)
  {
    static uint32_t lastWatch = 0;
    static bool lastVal = false;
    bool v = padSeen();
    if (v != lastVal || (now - lastWatch) > 1000)
    {
      lastVal = v;
      lastWatch = now;
      LOG(F("IR: raw="));
      LOG(digitalRead(PIN_IR) == LOW ? F("LOW ") : F("HIGH"));
      LOG(F("  debounced="));
      LOGLN(v ? F("BLOCKED") : F("clear"));
    }
  }

  // ---- A beam that stays blocked at rest: shut the slot ----
  //  Something is in the chute, or the sensor is unplugged (with the 1 M
  //  pull-down an unplugged sensor reads BLOCKED). Either way a vend could
  //  not see its pad drop, so stop taking money now rather than after a
  //  customer has paid. It clears itself once the beam reads clear again.
  if (state == ST_IDLE && irStable && !irStuckWarned &&
      reached(now, irBlockedSince + IR_STUCK_WARN_MS))
  {
    irStuckWarned = true;
    LOGLN(F("The chute has read BLOCKED at rest for 5 s: something is in it,"));
    LOGLN(F("or the IR sensor is unplugged. Shutting the coin slot."));
    enterFault("CHECK SENSOR");
    faultClearsWhenBeamClear = true;
  }

  // ---- ...and undo a beam fault once the beam reads clear again ----
  if (state == ST_FAULT && faultClearsWhenBeamClear)
  {
    if (irStable)
    {
      beamClearTiming = false;
    }
    else if (!beamClearTiming)
    {
      beamClearTiming = true;
      beamClearSinceMs = now;
    }
    else if (reached(now, beamClearSinceMs + BEAM_CLEAR_RECOVER_MS))
    {
      beamClearTiming = false;
      LOGLN(F("The beam has read clear for 3 s. Trying to return to service."));
      attemptClear("the sensor reading clear again", false);
      // If it is still faulted, something other than the beam is wrong:
      // leave it for a person rather than retrying every three seconds.
      if (state == ST_FAULT)
        faultClearsWhenBeamClear = false;
    }
  }

  // ---- Coins ----
  CoinBurst cb;
  if (takeCoin(cb))
  {
    // The acceptor has just fired its gate solenoid to take or reject that
    // coin, and that dips the 12 V rail. On this build the acceptor corrupted
    // the display on a bench with no motor connected, so this is not
    // theoretical. The screen is about to be repainted anyway, so rebuilding
    // it first costs nothing.
    lcdNeedsReinit = true;

    const CoinDef *coin = lookupCoin(cb.pulses);

    if (!coin)
    {
      coinsUnknown++;
      beep(TONE_REJECT_HZ, TONE_REJECT_MS);
      reportCoin(cb.pulses, coin, &cb);
      if (state == ST_IDLE)
      {
        // "SEE SERIAL" means nothing to somebody standing in a washroom. Tell
        // her which coins this machine actually takes.
        sayAllPages("COIN NOT TAKEN", acceptedCoins, 1400);
        showIdle();
      }
    }
    else if (state == ST_EMPTY || state == ST_FAULT)
    {
      // The slot was inhibited, so this can only be a coin that was already
      // mid-flight when things went wrong. The machine cannot promise a pad,
      // so it must not go on the meter. It is lost — the coin banked into the
      // housing before the firmware heard a single pulse and there is no way
      // out of there — but it is reported rather than pocketed in silence.
      beep(TONE_REJECT_HZ, TONE_REJECT_MS);
      reportCoin(cb.pulses, coin, &cb);
    }
    else
    {
      // IDLE, PAID, DISPENSING or DELIVERED: the machine can honour this, so
      // bank it. Outside IDLE the slot is shut, so this is a coin that was
      // already inside the acceptor; those states end in IDLE within seconds
      // and the credit buys the next pad.
      // A coin means somebody is standing at the machine, which is the only
      // thing a held pad was ever waiting for.
      if (holdForCollection)
      {
        holdForCollection = false;
        LOGLN(F("Somebody is here — releasing the pad held from before the"));
        LOGLN(F("power cut as well."));
      }

      if (bankCoin(coin))
        beep(TONE_COIN_HZ, TONE_COIN_MS);
      else
        beep(TONE_REJECT_HZ, TONE_REJECT_MS);
      reportCoin(cb.pulses, coin, &cb);
      coinScreenAfterBank(coin);
    }
  }

  // ---- Stock. Only ever acted on between vends: a dispense already running
  // is never aborted, because the IR beam is the authority on whether a pad
  // actually fell, not a switch under a shifting stack. ----
  bool stocked = padsPresent();
  if (state == ST_IDLE && !stocked)
  {
    enterEmpty();
  }
  else if (state == ST_EMPTY && stocked)
  {
    LOGLN(F("Stock switch reports pads loaded. Back in service."));
    state = ST_IDLE;
    showIdle();
  }

  //  A LATCHED JAM CLEARS ITSELF WHEN SOMEBODY HAS CLEARLY BEEN INSIDE.
  //
  //  Nothing the machine can sense tells it a jam has been fixed — the beam
  //  was already clear while it was jammed, so that proves nothing. But
  //  emptying and refilling the coil is something only a person with the door
  //  open can do, and it is exactly what fixing a jam involves. So the stock
  //  switch going away and coming back is treated as a service visit, and the
  //  machine tries to go back to work on its own.
  //
  //  Without this a jam that ran out its three retries stays dead until
  //  somebody thinks to plug in a laptop, which is not a reasonable thing to
  //  need after a refill.
  if (state == ST_FAULT)
  {
    if (!stocked)
    {
      serviceCycleSeen = true;
    }
    else if (serviceCycleSeen)
    {
      serviceCycleSeen = false;
      LOGLN();
      LOGLN(F("Stock cycled away and back while faulted — somebody has been"));
      LOGLN(F("inside. Treating it as a service visit and returning to work."));
      buttonRetries = 0; // whoever refilled it earned a fresh budget
      lastRefusalMs = 0;
      attemptClear("a refill", false);
    }
  }
  else
  {
    serviceCycleSeen = false;
  }

  // ---- Live stock watch, for mounting the switch ----
  if (stockWatch)
  {
    static uint32_t lastStockWatch = 0;
    static bool lastStockVal = false;
    if (stocked != lastStockVal || (now - lastStockWatch) > 1000)
    {
      lastStockVal = stocked;
      lastStockWatch = now;
      LOG(F("STOCK: raw="));
      LOG(digitalRead(PIN_PADS) == LOW ? F("LOW ") : F("HIGH"));
      LOG(F("  debounced="));
      LOGLN(stocked ? F("PADS PRESENT") : F("EMPTY"));
    }
  }

  // ---- The coin slot. One rule, evaluated here and nowhere else. ----
  //
  //  The acceptor is LIVE only while the machine is waiting for money: IDLE,
  //  with the credit still short of a pad (or a recovered pad waiting for
  //  someone, whose coin is what releases it). It shuts on the very pass the
  //  price is met and stays shut through PAID, DISPENSING and DELIVERED, as
  //  well as in EMPTY and FAULT.
  //
  //  Why shut during a sale: the coin line is muted while the motor turns,
  //  and a coin whose pulses arrive then is binned, money taken and nothing
  //  credited. A coin already inside the acceptor when the slot shuts is
  //  still counted, because PAID waits for the coin line to go quiet before
  //  the motor starts.
  //
  //  Driving it from state in one place means the slot can never disagree with
  //  what the machine is actually doing. There is no way to enter a state and
  //  forget to open or close it, because nothing else touches it.
  coinAcceptorAllow(state == ST_IDLE && !(credit >= PAD_PRICE && !holdForCollection));

  switch (state)
  {

  // -----------------------------------------------------------------
  case ST_IDLE:
  {
    // ---- A banner (coin acknowledgement, thank-you) holds the screen ----
    if (bannerUp && reached(now, bannerUntilMs))
      showIdle(); // clears bannerUp

    // ---- Part payment: keep asking, and show how long is left. ----
    if (credit > 0 && credit < PAD_PRICE)
    {
      // Repaint line 2 once a second. Line 1 already says what to add, and
      // does not change until another coin lands, so it is left alone.
      if (!bannerUp && reached(now, creditTickMs))
      {
        creditTickMs = now + 1000;
        char l2[17];
        creditPromptLine(l2, sizeof(l2), now);
        sayLine2(l2);
      }

      // CREDIT_TIMEOUT_MS of 0 means wait forever, so the clock never runs
      // out. Without this guard a zero would make (now - lastCoinMs) > 0 true
      // almost immediately and wipe the credit on the very next pass.
      if (CREDIT_TIMEOUT_MS > 0 && reached(now, lastCoinMs + CREDIT_TIMEOUT_MS))
      {
        // Print the MEASURED wait, not the configured one. Printing the
        // setting here made the log useless for telling "she really did take
        // two minutes" apart from "something cleared it early" — the two look
        // identical, and only one of them is a bug.
        LOG(F("Part payment of KSH "));
        LOG(credit);
        LOG(F(" cleared after an actual wait of "));
        LOG(sinceMs(now, lastCoinMs) / 1000);
        LOG(F(" s (limit "));
        LOG(CREDIT_TIMEOUT_MS / 1000);
        LOGLN(F(" s)."));
        LOGLN(F("  Nobody came back for it. The coin is in the box and there"));
        LOGLN(F("  is no way to return it — see CREDIT_TIMEOUT_MS."));
        setCredit(0);
        showIdle();
      }
    }

    // THE CUSTOMER PAYS ON DELIVERY, NOT ON THE MOTOR STARTING.
    //
    //  Nothing is taken off the meter here. The money comes off in
    //  ST_DISPENSING, at the moment the beam confirms a pad actually fell.
    //
    //  This machine cannot give change and cannot give refunds — there is no
    //  hopper and nothing to pay out with. So the only way it can be honest
    //  about a vend that fails is to never have taken the money in the first
    //  place. Charge on delivery and a jam, an empty coil or a missed beam
    //  all leave the credit sitting on the meter where the customer can see
    //  it, instead of quietly consuming it for a pad that never arrived.
    //  A pad recovered from a power cut waits for a person. Everything else
    //  vends straight away: somebody is standing there, they just paid.
    if (credit >= PAD_PRICE && !holdForCollection)
      enterPaid();
    break;
  }

  // -----------------------------------------------------------------
  case ST_PAID:
  {
    // The slot is already shut (the rule above). This pause is for her to
    // read the screen, AND for any coin that was already inside the acceptor
    // when the slot shut: its pulses must finish before the motor starts,
    // because the coin line is muted while the coil turns.
    if (!stocked)
    {
      LOGLN(F("Stock ran out before the motor started. Credit stays."));
      enterEmpty();
      break;
    }
    bool quiet = !coinBurstInProgress();
    if (quiet && reached(now, paidSinceMs + paidHoldMs))
    {
      startVend("credit met");
    }
    else if (reached(now, paidSinceMs + PAID_MAX_WAIT_MS))
    {
      LOGLN(F("Coin line still busy at PAID_MAX_WAIT_MS. Starting anyway."));
      startVend("credit met");
    }
    break;
  }

  // -----------------------------------------------------------------
  case ST_DISPENSING:
  {
    if (padSeen())
    {
      motorOff();
      uint32_t took = millis() - dispenseStartMs;
      if (took > slowestDropMs)
        slowestDropMs = took;

      // Delivered. NOW take the money — this is the only line in the firmware
      // that spends a customer's credit.
      //
      // The >= guard is not decoration: PAD_PRICE can be changed from the
      // console with  p  while a vend is in flight, and an unsigned subtraction
      // that went negative would wrap to about 65000 shillings of credit and
      // hand out free pads until someone noticed.
      uint16_t charged = (credit >= PAD_PRICE) ? PAD_PRICE : credit;
      setCredit(KEEP_CHANGE_AS_CREDIT ? (credit - charged) : 0);

      // KNOWN RACE, ACCEPTED DELIBERATELY. There are a few milliseconds
      // between the pad landing and the new balance reaching flash. A power
      // cut in exactly that gap leaves the OLD balance stored, so the machine
      // boots owing a pad it has already delivered and vends one more.
      //
      // The alternative is writing flash BEFORE confirming delivery, which
      // reopens the far worse failure this ordering exists to close: taking
      // money for a pad that never came out. Given a choice of which way to
      // be wrong in a window of milliseconds, err toward the customer.

      vendCount++;
      buttonRetries = 0; // it worked, so the retry budget is whole again
      lastRefusalMs = 0;
      // A request, not an order. Any change left over is named on the
      // THANK YOU screen that follows.
      say("PLEASE COLLECT", "YOUR PAD :)");
      beep(TONE_VEND_HZ, TONE_VEND_MS);
      messageUntilMs = millis() + MESSAGE_HOLD_MS;
      state = ST_DELIVERED;
      rule();
      LOG(F("PAD DELIVERED in "));
      LOG(took);
      LOGLN(F(" ms"));
      LOG(F("  session vends : "));
      LOGLN(vendCount);
      LOG(F("  charged       : KSH "));
      LOGLN(charged);
      LOG(F("  credit left   : KSH "));
      LOGLN(credit);
      if (took < 150)
      {
        LOGLN(F("  NOTE: that was very fast. Either the beam was"));
        LOGLN(F("  already breaking, or the sensor sees the coil."));
      }
      rule();
    }
    else if (reached(now, dispenseStartMs + DISPENSE_TIMEOUT_MS))
    {
      motorOff();
      LOG(F("No pad in "));
      LOG(DISPENSE_TIMEOUT_MS);
      LOGLN(F(" ms."));
      if (credit > 0)
      {
        LOG(F("  KSH "));
        LOG(credit);
        LOGLN(F(" is still on the meter — NOT taken for this attempt."));
      }

      // The stock switch can tell the two causes apart, and they want
      // opposite handling: running dry is routine and has to come back on its
      // own after a refill, while a jam needs somebody to open the door.
      // Latching OUT OF ORDER every time the machine merely ran out would
      // waste a call-out and leave the site dead until someone drove there.
      if (PAD_SWITCH_FITTED && !padsPresent())
      {
        LOGLN(F("  Stock switch says the coil is empty, so this is not a jam."));
        enterEmpty();
      }
      else
      {
        LOGLN(F("  Pad wedged, coil empty, or the timeout is too short for"));
        LOGLN(F("  this motor. Time a revolution with  m1000."));
        enterFault(PAD_SWITCH_FITTED ? "JAMMED" : "EMPTY OR JAMMED");
      }
    }
    break;
  }

  // -----------------------------------------------------------------
  case ST_DELIVERED:
  {
    // Let the beam clear as the pad finishes falling.
    padSeen();
    if (reached(now, messageUntilMs))
    {
      state = ST_IDLE;
      LOGLN(F("Ready."));
      if (credit >= PAD_PRICE && !holdForCollection)
      {
        // More pads in this sale (a KSh 40). IDLE moves straight to PAID on
        // the next pass, and the slot stays shut in between.
      }
      else
      {
        orderPads = 0;
        orderIndex = 0;
        showThanks(); // the slot reopens underneath it
      }
    }
    break;
  }

  // -----------------------------------------------------------------
  case ST_EMPTY:
  {
    // Credit can still be sitting here from someone who paid just as the last
    // pad went. It buys a pad the moment the coil is refilled, or it times out
    // like any other partial payment.
    // Same rule as ST_IDLE: only PART payment times out. Credit that is
    // enough for a whole pad stays put and waits for the refill.
    //
    //  The reason is that the coin is already in the cash box. The acceptor
    //  banks a coin before it sends a single pulse, so by the time this
    //  firmware knows money arrived, the money is gone into the housing and
    //  nothing can eject it. Inhibiting the acceptor stops the NEXT coin; it
    //  cannot undo one already taken.
    //
    //  So a full pad's worth of credit is not a number on a screen, it is a
    //  debt the machine has already been paid for. Wiping it would mean money
    //  in the box and no pad out of it, which is the exact failure that paying
    //  on delivery exists to prevent — it would be pointless to fix that at the
    //  vend and then undo it with a timeout twenty seconds later.
    if (CREDIT_TIMEOUT_MS > 0 && credit > 0 && credit < PAD_PRICE &&
        reached(now, lastCoinMs + CREDIT_TIMEOUT_MS))
    {
      LOG(F("Part payment of KSH "));
      LOG(credit);
      LOGLN(F(" timed out while out of stock, cleared."));
      setCredit(0);
    }
    // The screen is the only thing standing between a customer and a locked
    // door, so say all three things in turn: that it is empty, that she is not
    // being charged, and — if she already paid — that her money is still here.
    if (reached(now, emptyRotateMs))
    {
      emptyRotateMs = now + FAULT_ROTATE_MS;
      char msg[80];
      if (credit > 0)
        snprintf(msg, sizeof(msg),
                 "COIN SLOT CLOSED|YOUR KSH %u|IS SAFE AND|WAITING FOR YOU",
                 credit);
      else
        snprintf(msg, sizeof(msg),
                 "COIN SLOT CLOSED|PLEASE COME|BACK LATER");
      sayPaged("SORRY - NO PADS", msg, emptyMsgIdx);
    }
    break;
  }

  // -----------------------------------------------------------------
  case ST_FAULT:
  {
    // Latched on purpose. No reverse, no self-retry. Coins are inhibited,
    // so it costs nobody anything to sit here until someone opens the door.
    if (reached(now, faultRotateMs))
    {
      faultRotateMs = now + FAULT_ROTATE_MS;
      //  Two quite different messages, because two quite different people are
      //  standing there. With credit on the meter it is a customer who has
      //  paid and has no pad: tell her to hold the button, not that the
      //  machine is out of order. With nothing owed it really is out of order.
      //  Three different people can be standing here and they need three
      //  different things said to them. Every line below is 16 characters or
      //  fewer, because the display silently cuts off anything longer.
      //  Three different people can be standing here and they need three
      //  different things said to them. Each bottom line is written as a whole
      //  sentence and paged across frames rather than abbreviated to fit.
      if (buttonRetries >= MAX_BUTTON_RETRIES)
      {
        //  Out of retries. She cannot fix this, so stop telling her to try.
        //
        //  Two audiences read this same screen and neither has a laptop: the
        //  customer standing there, and whoever eventually opens the door. The
        //  customer's part comes first because she is here now, and the reason
        //  to call is named — "you have paid" is what makes a call worth
        //  making. The staff hint goes last, where it does not delay her.
        //
        //  The number holds on the top line (callLine()) for as long as the
        //  fault lasts, so it can be written down; only line 2 pages. The
        //  first page still carries the point on its own, that she has paid,
        //  and the staff hint trails behind where it delays nobody.
        //
        //  Nothing here promises her money back. The machine cannot give it
        //  back and must not imply otherwise; a person on the phone can.
        char msg[120];
        if (credit > 0)
          snprintf(msg, sizeof(msg),
                   "YOU PAID KSH %u|OUT OF ORDER|PLEASE CALL THE|NUMBER ABOVE"
                   "|STAFF: CHECK THE|COIL AND SENSOR",
                   credit);
        else
          snprintf(msg, sizeof(msg),
                   "OUT OF ORDER|CANNOT DISPENSE|PLEASE CALL THE|NUMBER ABOVE"
                   "|STAFF: CHECK THE|COIL AND SENSOR");
        sayPaged(callLine(), msg, faultMsgIdx);
      }
      else if (credit >= PAD_PRICE)
      {
        // She has paid and has no pad, and the button will try again for her.
        sayPaged("PAID - NO PAD",
                 "HOLD THE BUTTON|FOR 1 SECOND|TO TRY AGAIN", faultMsgIdx);
      }
      else
      {
        // Nobody is owed anything, so it is simply broken. Never "SEE SERIAL":
        // that means nothing to somebody standing in a washroom.
        char msg[96];
        snprintf(msg, sizeof(msg),
                 "OUT OF ORDER|%s%sCOIN SLOT CLOSED|PLEASE CALL THE|NUMBER ABOVE",
                 faultLine2, faultLine2[0] ? "|" : "");
        sayPaged(callLine(), msg, faultMsgIdx);
      }
    }
    break;
  }
  }

  // ---- Cycle the idle prompt so the whole of it gets read ----
  //  It keeps cycling while the backlight is asleep. The text is readable in
  //  the dark, and this used to stop with the backlight, freezing the screen
  //  mid-sentence ("PAD = KSH 20" / "THIS MACHINE") until somebody came by.
  //  A repaint is ~50 ms every two seconds.
  if (state == ST_IDLE && lcdOk && !bannerUp &&
      reached(now, idleRotateMs) && (credit == 0 || holdForCollection))
  {
    idleRotateMs = now + FAULT_ROTATE_MS;
    if (holdForCollection)
    {
      sayPaged("PAD IS PAID FOR", "PRESS THE BUTTON|TO COLLECT IT", idleMsgIdx);
    }
    else
    {
      char l1[17];
      snprintf(l1, sizeof(l1), "PAD = KSH %u", PAD_PRICE);
      sayPaged(l1, acceptedCoins, idleMsgIdx);
    }
  }

  // ---- Rebuild the display periodically, whatever happened to it ----
  //
  //  Belt and braces on top of the event triggers. Whatever corrupted the
  //  screen, and whether or not we know what it was, it cannot survive longer
  //  than this. Skipped mid-vend: the beam matters more than the screen, and
  //  a vend is over in seconds anyway.
  //  Skipped while asleep: waking rebuilds the display anyway, so refreshing a
  //  dark screen would be work nobody benefits from.
  if (LCD_REFRESH_MS > 0 && lcdOk && backlightOn && !vendInFlight() &&
      reached(now, lcdRefreshMs))
  {
    lcdRefreshMs = now + LCD_REFRESH_MS;
    lcdNeedsReinit = true;
    repaintForState();
  }

  // ---- A screen missed at boot is looked for until it answers ----
  //  Not mid-vend: bringing it up paints the screen, and while the coil turns
  //  the beam comes first.
  if (!lcdOk && !vendInFlight() && reached(now, lcdProbeMs))
  {
    lcdProbeMs = now + LCD_REPROBE_MS;
    if (i2cPresent(LCD_I2C_ADDR))
    {
      lcdOk = true;
      backlightOn = true;
      lastActivityMs = now;
      lcdNeedsReinit = true; // say() runs the full HD44780 init sequence
      LOGLN(F("LCD answered after boot. Screen is up."));
      repaintForState();
    }
  }

  // ---- A store that refused at boot is retried until it opens ----
  //
  //  setCredit() also tries, but only when money moves. An idle machine with
  //  an unreadable store would otherwise never find out that an old balance is
  //  waiting in NVS to be restored by a later boot.
  if (REMEMBER_CREDIT_ACROSS_POWER_LOSS && !creditStoreOpen &&
      reached(now, storeRetryMs))
  {
    storeRetryMs = now + 30000;
    ensureCreditStore();
  }

  // ---- Heartbeat, for soak tests ----
  if (heartbeatOn && reached(now, lastBeatMs + HEARTBEAT_MS))
  {
    lastBeatMs = now;
    LOG(F("[hb] "));
    LOG((now - bootMs) / 1000);
    LOG(F("s  "));
    LOG(stateName(state));
    LOG(F("  credit KSH "));
    LOG(credit);
    LOG(F("  vends "));
    LOG(vendCount);
    LOG(F("  faults "));
    LOG(faultCount);
    LOG(F("  beam "));
    LOG(irStable ? F("BLOCKED") : F("clear"));
    LOG(F("  stock "));
    LOG(!PAD_SWITCH_FITTED ? F("n/a") : (padsStable ? F("ok") : F("EMPTY")));
    LOG(F("  heap "));
    LOGLN(ESP.getFreeHeap());
  }

  // ---- Loop health ----
  uint32_t took = micros() - loopStartUs;
  if (took > loopMaxUs)
    loopMaxUs = took;

  // Hand the CPU back. The idle task needs it to feed the watchdog, and 1 ms
  // is well inside the IR debounce window so nothing is missed.
  delay(1);
}
