auxinnepaul/pads_vending_machine_with_coin_acceptor/(commit log)

2026-09-19 Pad dispenser prototype firmware: coin acceptor, coil drive, IR drop sensor
    ESP32 firmware for the first-build pad dispenser agreed with the client
    (ref BT-PADVEND-2026-001): coin in, coil turns, IR beam confirms the pad
    fell, motor stops. LCD and buzzer report each step; faults latch rather
    than reverse, because the relay drives one direction only.
    Scope matches the "first build will be simpler" section of the feasibility
    study — no battery, no sleep mode, no cabinet, no M-Pesa.
    Two defects fixed while reviewing:
    - millis() rollover made the DELIVERED message hold compare two absolute
    timestamps, which would strand the machine on that screen for ~25 days
    every ~49.7 days of uptime.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
    [pads_vending_machine_with_coin_acceptor.ino]
2026-09-19 v2: coin table, boot self-test, serial calibration console, no flash writes
    The acceptor is a multi-coin unit, so pulses identify a CHANNEL, not an
    amount. Firmware now groups pulses into whole coins (quiet gap = coin
    finished) and prices each one from COIN_TABLE. Credit is held in shillings
    instead of pulses. Every coin prints what went in, whether it was
    recognised, what it is worth, what the credit now stands at, and what will
    be vended — an unrecognised coin prints the exact table line to add.
    Dropped Preferences/NVS entirely. Nothing is written to flash. Vend count,
    takings and fault count are session-only, which is the honest scope of a
    bench prototype.
    Self-diagnosis, seven sectio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
2026-09-25 Coin inhibit relay, jam-clear button, measured coin table, pulse timing
    Machine changes (author: Auxinne Paul), plus the fixes and calibration
    support below.
    A second relay now inhibits the HX-916 on every fault and for the duration
    of every vend, wired to the NC contact so an unpowered, booting, halted or
    crashed controller refuses money rather than eating it. A jam-clear button
    inside the locked door returns the machine to service: hold 1 s, and the
    firmware re-checks the beam and refuses while the chute is still blocked.
    A fault arriving while the button is already held cannot ride that hold
    into clearing itself. A blocked chute at boot is now a fatal self-test
    result.
    Coin table replac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
    [pads_vending_machine_with_coin_acceptor.ino]
2026-09-25 Pad stock switch, active-low inhibit relay, field logging switch
    STOCK SWITCH (GPIO 33). A mechanical limit switch now tells the machine
    whether there are pads left, so it stops taking money before somebody pays
    for nothing. Closed to GND = pads present; open = empty. That direction is
    the fail-safe one: a broken wire, pulled connector or corroded contact all
    float the pin HIGH and read EMPTY, so a wiring failure costs a sale rather
    than a customer's money. The opposite polarity would read FULL on those
    same faults and sell pads that are not there. PADS_PRESENT_IS_LOW inverts
    it if the switch has to be mounted the other way round.
    Out of stock is a new state, not a fault, and deliberately d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
    [pads_vending_machine_with_coin_acceptor.ino]
2026-09-25 Review pass: use the stock switch to tell "ran out" from "jammed"
    A dispense timeout was always latching OUT OF ORDER as "EMPTY OR JAMMED".
    Now that a stock switch exists the machine can ask it, and the two causes
    want opposite handling: running dry is routine and has to come back by
    itself on a refill, while a jam needs somebody with a key. Latching every
    time a site merely ran out would leave it dead until someone drove there.
    Timeout with the switch reading empty now goes to EMPTY; with the switch
    reading full it is a jam and says so by name. With no switch fitted it
    cannot tell, so it stays cautious and latches as before. Either way the
    console now states plainly that the customer paid f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
    [pads_vending_machine_with_coin_acceptor.ino]
2026-09-25 Comment the whole file for someone who has to maintain it
    Comments only. The compiled binary is byte-identical at 307,817 bytes, which
    is the check that nothing functional moved.
    Header now carries a map of the file, the five states in plain words, and a
    short list of the four timings anyone actually tunes, with a pointer to the
    detail.
    SECTION 5 rewritten. Every timing constant gets the same five headings:
    WHAT it controls, what goes wrong if it is TOO SHORT, what goes wrong if it
    is TOO LONG, HOW TO SET it on the bench, and the live CONSOLE command if it
    has one. DISPENSE_TIMEOUT_MS — the one that decides when the machine gives
    up waiting for a pad — gets the fullest treatment, inclu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
    [pads_vending_machine_with_coin_acceptor.ino]
2026-09-25 Self-heal the LCD after a vend; explain the garbage characters
    The display sometimes fills with what look like Chinese characters. That is
    a specific fault, and the character set is the clue: the LCD is driven in
    4-bit mode, so every byte crosses as two nibbles, and losing one nibble
    shifts every byte after it by four bits. The HD44780 font carries Japanese
    katakana at 0xA0-0xDF, so mangled bytes land there. Nothing about the
    display knows it lost sync, so it stays corrupted until re-initialised.
    What makes it lose a nibble is the motor. Switching the coil drops the 5 V
    rail for a few milliseconds; the LCD browns out while the ESP32, which has
    its own regulator and a far better supply, carr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
2026-09-25 The customer pays on delivery, not when the motor starts
    External review, correctly, called this the serious one: credit was taken
    the moment the coil started turning, so a vend that then jammed, ran out or
    missed the beam consumed the customer's money and gave nothing back. The
    console said as much and there was no refund and no record of what was owed.
    Rather than add refund logic to a machine that physically cannot refund —
    no hopper, nothing to pay out with — the money is now taken at the moment
    the beam confirms a pad actually fell. There is exactly one line in the
    firmware that spends credit and it runs after delivery.
    That turns the whole class of failure into a non-event. A jam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
    [pads_vending_machine_with_coin_acceptor.ino]
2026-09-25 No eject path: protect the claim, since the cash can never come back
    Confirmed with the builder: the acceptor banks a coin into the housing and
    only then sends its pulses. By the time this firmware knows any money
    arrived it is already in the box, and there is no eject, no return chute and
    no hopper in this machine. Inhibit stops the NEXT coin; nothing can undo one
    already taken.
    That makes the distinction sharper than the last commit stated it. Paying on
    delivery does not get anybody their money back — nothing can. What it
    protects is the CLAIM: the machine's own record that it owes a pad. Written
    up that way now, at the inhibit relay, in the README, and wherever the
    promise is made, bec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
2026-09-25 Simplify the coin slot to one rule: live unless EMPTY or FAULT
    The flow the machine should have, and now does: power on and the slot is
    open, a coin goes in, the pulses are counted and acted on, and the slot
    closes only when there is a reason — no pads, or something broken.
    The acceptor was being inhibited for the duration of every vend as well.
    That made sense when a coin landing mid-vend was discarded, but it is not
    discarded any more — it is banked and buys the next pad. So the inhibit was
    protecting against nothing while working the relay twice on every single
    sale, which is thousands of needless operations over a machine's life and an
    audible click each time.
    Five scattered coinAc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
    [pads_vending_machine_with_coin_acceptor.ino]
2026-09-25 Console commands that block must refuse while the coil is turning
    From external review. The d command ran the full self-test with no state
    guard. While a vend is in flight, loop() is the only thing watching the beam
    and enforcing both the dispense timeout and the motor backstop; the
    self-test blocks for over a second and resets the beam debouncer, so a pad
    could fall unnoticed while the coil kept turning with nothing counting the
    time. Both d and l now refuse mid-vend, matching the guards m and t
    already had. l had the same problem and was not flagged: it holds the
    screen for two seconds.
    Also fixed while there: both commands repainted the idle screen
    unconditionally when they fi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
    [pads_vending_machine_with_coin_acceptor.ino]
2026-09-25 Part payment: keep asking, with a countdown, for two minutes by default
    Twenty seconds was not long enough for the situation it exists to handle —
    somebody digging in a bag for a second coin in a washroom. The machine now
    keeps asking for two minutes and shows how long is left, refreshed once a
    second:
    CREDIT KSH 10
    ADD 10 IN 1:35
    CREDIT_TIMEOUT_MS = 0 waits forever: part payment never expires and the
    screen just keeps asking, with no countdown. That needed a guard in both
    places the timeout is tested — a bare (now - lastCoinMs) > 0 would have been
    true almost immediately and wiped the credit on the very next pass, so zero
    would have meant "expire instantly" rather than "never"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
2026-09-25 Keep the meter balance through a power cut
    Your call, and it closes a real hole. A cut with KSh 5 on the meter was a
    clean swallow: the coin is in the box, the firmware forgot it ever arrived,
    and nobody — not the customer, not the log, not the takings — had any
    record. Mains cuts are not hypothetical at a Kenyan site.
    The balance is now written to flash whenever it changes and restored at
    boot. It is the only thing this firmware stores.
    One decision worth arguing with, because it is what makes this safe: THE
    COUNTDOWN RESTARTS FROM BOOT rather than resuming where it left off. A short
    cut protects the customer who is still standing there. A long one must not
    leave a stranger's balance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
    [pads_vending_machine_with_coin_acceptor.ino]
2026-09-25 One screen for part payment, however she got there
    Balance 5, insert 20, a pad comes out and 5 is left over — you asked whether
    that lands back in the "please add more" state cleanly. It did not, quite.
    Change left over from a vend went through showIdle(), which drew
    "PAD = KSH 20 / CREDIT KSH 5": it named the amount but never said to add
    more and never showed the countdown. About a second later the countdown tick
    overwrote line 2 only, leaving a half-updated screen whose two lines came
    from different places.
    There are two routes to having part payment — she paid part of the price, or
    she overpaid and a vend handed the remainder back — and they were drawing
    different screens. Now sho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
2026-09-25 Fix stale state docs and the screen a bench command hands back
    Both from external review, both mine, both left behind when the coin-slot
    logic was simplified two commits ago.
    The state block still described the OLD inhibit rule: that IDLE was the only
    state accepting coins and that DISPENSING and DELIVERED refused them. The
    opposite is now true — the slot stays live through a vend and a coin landing
    there is banked for the next pad. Comments that contradict the code are
    worse than no comments, because the next person trusts them. Rewritten to
    state the actual rule, including why the slot stays open during a vend.
    runMotorFor() ended with showIdle() unconditionally. The command is
    deliber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
    [pads_vending_machine_with_coin_acceptor.ino]
2026-09-25 Correct the last two "nothing is stored in flash" claims
    The file header and the console section both still said nothing is written
    to flash. The meter balance has been persisted since the power-cut commit,
    so both were wrong.
    My earlier sweep for this missed them because I grepped for the wording I
    had used rather than for the subject. Redone properly across every mention
    of flash in the file: these two were the only stale ones. The rest are
    either about reflashing the sketch, the flash pins to avoid on an ESP32, or
    the persistence itself described correctly.
    Both now say the same thing the README and setup() already did: the amount
    on the meter is kept, and nothing else is — no console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
    [pads_vending_machine_with_coin_acceptor.ino]
2026-09-25 LCD corruption: it is the acceptor too, not only the motor
    Field correction from the builder: the display corrupted on this bench with
    NO MOTOR CONNECTED, while powering the coin acceptor. I had attributed it to
    the motor with more confidence than the evidence supported.
    The mechanism is the same — a rail dip browns out the LCD controller while
    the ESP32, which has its own regulator, carries on clocking data at it, and
    a lost nibble shifts every byte after it into the HD44780's katakana block.
    But the acceptor fires a gate solenoid on EVERY coin it takes or rejects,
    and draws a surge when first powered. That is an inductive load being
    switched several times a minute, and the firmware was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
    [pads_vending_machine_with_coin_acceptor.ino]
2026-09-25 Sleep the backlight, and make waking a full rebuild
    Your idea, and it puts the refresh exactly where it is worth most.
    After two minutes of a genuinely idle machine the backlight goes out. The
    FIRST COIN PULSE brings it back — deliberately not the finished coin.
    takeCoin() waits for COIN_GAP_MS of silence before handing a coin over, and
    on a 40-pulse KSh 40 that is seconds away, while she is looking at the screen
    from the moment it drops. Watching the raw pulse counter lights it the
    instant her coin registers.
    Waking is always a full rebuild, never just switching the light back on. That
    is the part that matters: whatever happened to the display while nobody was
    watching is gone before th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
2026-09-25 Check that the balance actually reaches flash, and stop claiming what does not
    Both findings confirmed against the core source at
    2.0.11/libraries/Preferences/src/Preferences.cpp rather than from memory,
    and both were mine.
    putUShort() returns 0 on failure, including when begin() never succeeded,
    and setCredit() ignored it. bankCoin() therefore reported success on a coin
    whose balance had not been stored — the machine believing money was safe and
    losing it at the next power cut, with nothing logged, which is precisely the
    failure this feature exists to prevent. begin() was unchecked too.
    Both are checked now. A failure does NOT stop the machine trading: refusing
    sales because flash is un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
    [pads_vending_machine_with_coin_acceptor.ino]
2026-09-25 Clear the stored balance when it can no longer be kept in step
    The review accepted the degraded-mode trade-off, but its phrasing — "or
    restore an older balance and vend it again" — points at something worse than
    losing credit, and worse than I had thought through.
    Trace it: flash holds 20, writes start failing, the machine vends,
    setCredit(0) fails, power cut. The next boot restores 20, believes it owes a
    pad, and vends one into an empty washroom where it is simply lost. A stale
    part payment is milder but the same shape: a discount handed to whoever
    walks up next.
    So a stored balance the firmware can no longer keep in step is not merely
    stale, it is a landmine, and it is armed in favou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
    [pads_vending_machine_with_coin_acceptor.ino]
2026-09-25 Only clear a stored balance that is too HIGH, never one that is too low
    The previous safeguard was too blunt and the review is right about what it
    cost. Flash holds KSh 10, saved successfully. The customer adds another
    KSh 10 and the write of 20 fails. The cleanup then wrote zero over a claim
    that was safe, so a power cut lost BOTH coins instead of the one that had
    never reached flash.
    The two directions of error are not equally bad, and that asymmetry is the
    whole rule:
    stored ABOVE the meter over-credits on the next boot. A full pad's worth
    makes the machine wake up believing it owes a pad
    and vend one into an empty washroom. Part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
    [pads_vending_machine_with_coin_acceptor.ino]
2026-09-25 Retry a credit store that refused to open, and reconcile what turns up
    The review found the remaining hole and it is the nastiest shape so far: a
    balance we cannot even SEE, surfacing two boots later.
    If prefs.begin() failed at setup, creditInFlash stayed at its default of
    zero. Every safety check downstream compares against that, so the
    overstated-balance check could never fire, and an old balance survived the
    whole session untouched in NVS. Open the store normally on some later boot
    and it is restored as gospel — potentially a full pad's worth, vended to
    nobody. The danger was never the failure; it was the failure being invisible.
    The store is now retried every 30 s, and again whenever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
    [pads_vending_machine_with_coin_acceptor.ino]
2026-09-25 Do not leave the flash alarm latched after the store recovers
    A store that opened late and successfully reconciled its stale balance left
    creditPersistOk false and the warning flag set, so s and d kept reporting
    "open but NOT WRITING" after a write had demonstrably just worked.
    That matters more than a wrong label. These two lines exist to send somebody
    to the right fault, and a diagnostic that reports a flash problem which has
    healed sends them chasing nothing. Worse than saying nothing at all.
    A late open now makes the same optimistic assumption setup() does — a store
    that opens is presumed to write until a write actually fails — and clears the
    alarm. If the reconciliation write then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
    [pads_vending_machine_with_coin_acceptor.ino]
2026-09-25 Link the bench wiring card, and redraw the ASCII rail diagram
    The diagram predated the second relay: it showed a Schottky that is not in
    the current design, no inhibit relay, and no suppression. Redrawn to match
    what the firmware actually expects — both relays, where each capacitor goes,
    the flyback diode's orientation, and the note that the acceptor's inhibit
    port needs a dry contact because that pin can sit at 12 V on some units.
    Also states the star-wiring rule at the top of the section rather than
    leaving it to the LCD troubleshooting notes, since it is a wiring decision
    made once and awkward to undo.
    The card link is marked private to the Bricapa account, and the README
    tables named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
2026-09-25 Stop counting the coin line while the motor runs — it was inventing money
    You were right, and this is my regression. I read the old sketch: its coin
    reading is identical to this one, same ISR, same takeCoin, same gap logic.
    That was never the difference. The difference is one line I changed when you
    asked me to stop inhibiting during a vend — mid-vend pulses went from being
    REJECTED to being BANKED.
    The phantom pulses were always there. The old code threw them away, so they
    were invisible. Banking them turned them into credit and extra vends, which
    is why KSh 40 ran three times.
    The signature in your logs is unambiguous. Real coins from this acceptor:
    50-105 ms between pulses, bursts l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
2026-09-25 Add an inhibit-relay click test, and document why it may not release
    Correcting myself first: PAD_SWITCH_FITTED was already true in the sketch
    that was actually flashed. I diagnosed from the repo copy instead of asking
    what was on the board, and got it wrong.
    On the jam not inhibiting, the firmware is not at fault and the log proves
    it — "Coin acceptor INHIBITED" printed, so the pin was driven. What did not
    happen is the relay moving, and those are different claims. Only one of them
    is visible from a console.
    The likely cause is voltage. An ESP32 drives HIGH at 3.3 V. On a 5 V opto
    module the input LED's anode is at 5 V, so a 3.3 V "off" leaves 1.7 V across
    the LED and its resistor, whic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
    [pads_vending_machine_with_coin_acceptor.ino]
2026-09-25 Move the coin inhibit to GPIO 13, and make its polarity measurable
    Retracting the 3.3 V theory. It was wrong and the bench disproves it: the
    motor relay is driven from the same 3.3 V logic and switches perfectly, and
    a jumper on the inhibit pin moves that relay too. The pin level reaches the
    module. I was reasoning from a plausible mechanism instead of from what the
    hardware was doing, and should have built the measurement first.
    Inhibit moved from GPIO 19 to GPIO 13 on the builder's experience of 19
    misbehaving in other projects. On paper 19 is a plain GPIO — no strapping,
    no flash, not an ADC pin — so it should have worked. It did not, and
    measured behaviour beats a datasheet. Only th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
    [pads_vending_machine_with_coin_acceptor.ino]
2026-09-25 Revert the inhibit pin to 19; move the stock switch to 13 for the terminal block
    The pin move was based on my misreading of a description, not on a fault. 19
    is a plain GPIO — no strapping, no flash, not an ADC pin — and there was
    never evidence against it. Reverted.
    The stock switch moves 33 -> 13 instead, for the reason that actually
    matters on a bench: 13 lands next to the terminal block on this build. Both
    pins are equally valid for a switch to ground — plain GPIOs with the
    internal pull-up that needs — and 13 being ADC2 is irrelevant because the
    pin is only ever read digitally. The comment says so, since "why not 33"
    will be asked again.
    Kept from the last commit because they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
    [pads_vending_machine_with_coin_acceptor.ino]
2026-09-25 Print the electrical intent when the coin slot switches
    Your log shows the mute working and catching real damage: 33 pulses induced
    by one motor run, every one of which would have been free credit before. It
    also shows the inhibit line still not matching the relay, so here is the
    instrumentation you asked for.
    "Coins inhibited" only reports what the firmware decided. It now also prints
    what it did to the pin and what it expects of the relay:
    [GPIO 19 driven HIGH -> expect the relay to be RELEASED,
    contact CLOSED = slot blocked]
    If the relay disagrees with that line, the fault is in the wiring or in
    INHIBIT_RELAY_ACTIVE_HIGH, and it stops being a matter of opinion. Self-test
    [7] a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
    [pads_vending_machine_with_coin_acceptor.ino]
2026-09-25 The button retries the vend and keeps her credit, instead of wiping it
    Your call, and it exposed a real bug of mine: attemptClear() was zeroing the
    credit. So clearing a jam would have thrown away the KSh 20 already in the
    cash box and given nothing for it — the exact failure the whole pay-on-
    delivery design exists to prevent, reintroduced at the one moment the
    customer is standing there asking for her pad.
    The credit now stays. ST_IDLE sees credit >= price on the very next pass and
    dispenses, so holding the button IS the retry. No new dispense path, just
    the removal of the line that was destroying the claim.
    Reframed the control to match: it belongs on the FRONT where she can reach
    it,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
    [pads_vending_machine_with_coin_acceptor.ino]
2026-09-25 Name who to call, and let a refill put a latched jam back to work
    Two things you asked for, plus a bug of mine they exposed.
    GET HELP without saying who to get is no help at all, so SERVICE_CONTACT in
    SECTION 4 now carries the number printed on the machine and the screen shows
    it. The self-test measures its length and warns if it would be cut off, and
    nags if there is no digit in it — a placeholder that ships to a site is worse
    than nothing.
    A refill now clears a latched jam on its own. Nothing the machine can sense
    tells it a jam has been FIXED: the beam was already clear while it was
    jammed, so that proves nothing. But emptying and refilling the coil is
    something only a person with the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
    [pads_vending_machine_with_coin_acceptor.ino]
2026-09-25 Page whole sentences across the display instead of abbreviating them
    Your point, and it is the right one: sixteen columns is not a reason to
    write in abbreviations. HOLD BTN 1 SEC is what you get from squeezing a
    sentence into the hardware. Paging it across three frames is the same
    hardware used properly, and a stranger in a hurry can actually read it.
    lcdPage() breaks a long line into 16-character pages on word boundaries,
    never splitting a word unless one is longer than the display. sayPaged()
    cycles a page per call for screens that already rotate; sayAllPages() walks
    through once for one-shot messages that have no rotation to live in.
    The top line holds still as an anchor while the botto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
2026-09-26 Print the measured wait, not the configured one, when part payment clears
    Twenty and forty work, and the meter survived two power cuts. Five and ten
    do not accumulate, and I cannot diagnose it from these logs because the
    message I wrote is not reporting a measurement.
    "timed out after 120 s" printed CREDIT_TIMEOUT_MS / 1000 — the SETTING. So
    "she really did wait two minutes" and "something cleared it early" produce
    byte-identical output, and only one of those is a bug. That is a useless log
    line masquerading as evidence, and it is mine.
    It now prints the actual elapsed wait alongside the limit:
    Part payment of KSH 10 cleared after an actual wait of 7 s (limit 120 s)
    Every coin repo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
    [pads_vending_machine_with_coin_acceptor.ino]
2026-09-26 Fix the unsigned underflow that cleared part payment instantly
    Your bench log named it exactly:
    cleared after an actual wait of 4294967 s (limit 120 s)
    4,294,967 s is 2^32-1 ms. lastCoinMs was AHEAD of `now`, so (now - lastCoinMs)
    wrapped to 4.29 billion and every timeout test built on it fired on the spot.
    A KSh 5 was cleared on the very pass it was banked.
    It is my regression, and it is one word. loop() reads `now` once at the top.
    The old sketch stamped lastCoinMs = now — the loop's value, which can never
    be ahead of itself. When I moved banking into bankCoin() I wrote
    lastCoinMs = millis(), which runs later in the same pass and is therefore
    larger than `now`. Unsigned subtractio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
    [pads_vending_machine_with_coin_acceptor.ino]
2026-09-26 Raise the dispense timeout from measurement, and fix my own gap diagnostic
    Part payment now accumulates correctly on the bench: 10+10 and 5+5+5+5 both
    reach KSH 20 and vend, twice each. The underflow was the whole of it.
    Two things the same log showed.
    DISPENSE_TIMEOUT_MS was too tight. Thirteen successful drops measured 775,
    980, 1121, 1127, 1209, 1436, 1465, 1510, 1545, 1752, 1819, 1940 and 2299 ms.
    At 3000 the slowest left 700 ms of margin, and the run at the end of the log
    faulted JAMMED on a coil that was working. 5000 is a little over double the
    slowest observed drop, which is the rule this file already asks for. The
    numbers are recorded in SECTION 5 so the next person can see where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
    [pads_vending_machine_with_coin_acceptor.ino]
2026-09-26 Report the noise RATE, because it says brush arcing, not switching
    All three coin paths now work on the bench: 40 vends two pads, 10+10 and
    5+5+5+5 both reach KSH 20 and vend, the gap diagnostic reads correctly at
    11 s / 2 s / 1 s, and the meter survived every reboot in the log. The
    underflow was the whole of the coin problem.
    The noise numbers say I gave you the wrong part. Over 27.7 s of motor
    running across ten runs: 1937 discarded pulses, a steady 70 per second,
    from runs of 1.0 to 5.0 s.
    run ms pulses per second
    1061 74 70
    1636 149 91
    1243 145 117
    1143 129 113
    1456 152 104
    1176 72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
    [pads_vending_machine_with_coin_acceptor.ino]
2026-09-28 A recovered pad waits to be collected instead of dropping into an empty room
    Your call and the right one. Power returns at three in the morning, the
    machine wakes owing a pad, and vends it to nobody. It lies in the tray until
    whoever opens up finds it, or it walks. That is losing a pad on top of the
    money, not honouring the debt.
    A recovered balance that covers a whole pad is now HELD. The pad stays in the
    coil where it is safe and the screen says so:
    PAD IS PAID FOR
    PRESS THE BUTTON TO COLLECT IT
    Either a button press or a coin releases it. Both mean somebody is standing
    there, which is the only thing it was ever waiting for — and a coin is the
    more likely of the two, since the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
2026-09-28 Set the dispense timeout from the machine's own worst drop, not from a guess
    Everything in that log works. All four coin paths, change carried across a
    vend, and both release routes for a held pad — the button ("releasing the pad
    that was paid for before the power went") and a coin ("somebody is here").
    One number in it matters more than the rest: a delivery took 3503 ms. Every
    other drop was 930-1401. That outlier is what the timeout has to survive,
    because a machine has to work on its worst day, not its average one. At 5000
    it had 43% margin over that, and the log shows exactly what too little margin
    produces — a working coil telling a paying customer OUT OF ORDER.
    Raised to 7000, tw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
2026-09-28 The dispense timeout is a placeholder, not a measurement — say so
    The drop times in every log so far came from a finger waved at the IR sensor,
    because the chute and panel do not exist yet. They measure how fast a hand
    moves. They say nothing about how long a pad takes to fall.
    So the 3503 ms "slow drop" I built an argument on last commit was a slow
    finger, and I read meaning into noise — presented as "MEASURED ON THIS
    MACHINE" with a list of numbers, which is exactly the kind of false
    precision that gets believed later.
    No code change: 7000 stays, because it errs the safe way. Too long only
    wastes a few seconds on a real jam; too short tells a paying customer the
    machine is broken whe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
    [pads_vending_machine_with_coin_acceptor.ino]
2026-09-28 Let a field machine boot silently, which SERIAL_LOG_DEFAULT never did
    You were right to check. The switch existed but did not cover the boot: the
    banner and the nine-part self-test were forced on in setup() regardless of
    it, so a unit set quiet still printed about a second of text at every
    power-up. "Off" was not off.
    SERIAL_LOG_BOOT in SECTION 7 is the switch for that. Set both false and the
    machine says nothing unless spoken to.
    Nothing is weakened. The self-test still RUNS and still gates the machine
    with boot logging off — it only stops narrating. Every typed command still
    answers in full whatever both switches say, because handleCommand forces
    logging on for its own duration; d repr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
2026-09-28 Add firmware_dev_paperwork, matching the bricapa_firmwares convention
    Same layout as bricapa_firmwares: firmware_dev_paperwork/ with
    SCREAMING_SNAKE_CASE docs, a README.md index using the "I want to… / Read /
    Audience" table, CLAUDE.md at the root pointing at the paperwork as the
    source of truth, and FIRMWARE_PROGRESS.md as the living memory with a
    ▶ RESUME HERE block.
    README.md index — which doc for what, status at a glance
    OVERVIEW.md what the machine is, what it proves, tour of the
    firmware: states, coin decoding, loop order, money,
    persistence, display, self-test
    DESIGN_DECISIONS.md 27 decision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
2026-09-28 Fix the soak stopping after every first cycle — a stale debouncer reading
    Your T5 found it, and it was reproducible on every run whatever the count:
    #1 delivered in 1127 ms
    Chute is blocked. Clear it and start again. Stopping.
    padSeen() is a debouncer and carries state from whenever it was last called.
    Immediately after a delivery that state is BLOCKED — the pad tripped the beam
    and nothing has called it since to notice the pad has gone. The soak's beam
    check bailed out on the FIRST reading, so it read that stale value and
    declared a blocked chute on a chute that was empty.
    It never showed in a paid vend purely by luck. ST_DELIVERED polls padSeen()
    on every pass for 2.5 secon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
    [pads_vending_machine_with_coin_acceptor.ino]
2026-09-28 Fix the noise rate being several times too high during a soak
    The soak fix worked — 5 of 5, twice, no more stopping after the first cycle.
    But the numbers it produced exposed a reporting bug of mine.
    A soak blocks, so loop() never runs between its cycles and the coin-line mute
    is never released. The discarded-pulse count therefore accumulates across all
    five runs, while lastMotorRunMs only ever held the LAST one. The rate was
    2034 pulses divided by 1313 ms and printed as 1549 per second, when the real
    figure was 2034 over 18120 ms of total motor time — about 112 per second, in
    line with every earlier measurement.
    Motor time now accumulates across every run in one mute window and resets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
    [pads_vending_machine_with_coin_acceptor.ino]
2026-09-28 Give the motor capacitor as a range, not a single value
    I had been naming 100 nF as though it were the only answer. It is not — the
    standard range across a motor's terminals is 10 to 100 nF and the exact
    figure is not critical. 47 nF has roughly twice the impedance of 100 nF at a
    given frequency, so it suppresses about half as hard, which is still most of
    the benefit and far better than nothing. Two in parallel make 94 nF for
    anyone who has a pair.
    Also added what I had left out and should not have: use ceramic and not
    electrolytic, 50 V rating or better because the coil spikes well above 12 V,
    and 10 nF rather than 100 nF for the terminal-to-case pair.
    And the complementary fix, for whe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
    [pads_vending_machine_with_coin_acceptor.ino]
2026-09-28 Add a suppression and decoupling shopping list with real values
    Everything needed to take to a shop: value, voltage rating, quantity, where
    it goes and why.
    The part I had been leaving implicit is that every electrolytic wants a
    100 nF ceramic beside it. An electrolytic has internal resistance and
    inductance and is poor above about 100 kHz, which is exactly where switching
    noise lives. Bulk and bypass are two jobs, not one, and fitting only the big
    one is a common way to be surprised that it did not help.
    Voltage ratings stated explicitly, because they are not optional and
    electrolytics fail messily: 25 V on the 12 V rail, 16 V on the 5 V rail, the
    rule being at least twice the working vol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
2026-09-28 Make n0/n1 a measurement protocol for the inhibit relay
    Audited the firmware side first, because you are sure it is software and
    that deserved checking rather than arguing. It is clean:
    pinMode(PIN_INHIBIT, OUTPUT) set once in setup
    digitalWrite exactly TWO call sites — the automatic one
    in coinAcceptorAllow() and the n0/n1 override
    nothing else no other code or library touches GPIO 4 or 19
    inhibitOverride -1, or the bracketed lines would not print
    And your own log proves the automatic write runs with the right level. So the
    firmware asks for the right thing. Whether the PIN does it is a differe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
2026-09-28 Explain why a working active-HIGH relay proves nothing about an active-LOW one
    Retracting a retraction. You told me the motor relay runs fine on 3.3 V so
    the 3.3 V theory must be wrong, and I accepted that. It does not follow, and
    the reason is precisely the polarity difference you have been pointing at.
    They are different circuits with different failure modes:
    active HIGH pin -> resistor -> LED -> GND
    3.3 V switches it ON easily, LOW switches it fully OFF.
    A 3.3 V MCU drives this perfectly. Your motor relay.
    active LOW 5 V -> LED -> resistor -> pin
    Pulling LOW switches it ON fine. Turning it OFF needs the pin
    near th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
    [pads_vending_machine_with_coin_acceptor.ino]
2026-09-28 Add an open-drain diagnostic for the inhibit pin, and say why a pull-up cannot help
    You asked for the internal pull-up on the inhibit pin. It cannot do what is
    needed, for two separate reasons, and both are worth writing down because
    they are easy to assume otherwise:
    On a push-pull OUTPUT the internal pull-up is not in the circuit at all —
    the output driver wins.
    During the boot window it is not available either. The ESP32 leaves reset
    with pins as inputs and pull-ups DISABLED, and setup() is the first thing
    that could enable one, which is precisely the window the resistor exists to
    cover. Only an EXTERNAL resistor holds a pin through boot.
    And on a 5 V active-low opto modu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
    [pads_vending_machine_with_coin_acceptor.ino]
2026-09-28 An ESP32 cannot turn off a 5 V active-LOW relay module — confirmed by Blink
    You settled it with the cleanest possible test: the bare Blink example
    toggling GPIO 19 every second, nothing else running, and the relay never
    moved. A jumper from 5 V releases it; a jumper from the ESP32's 3V3 does not.
    That removes the firmware from the question entirely, which is what Blink is
    for.
    I had this diagnosis first and retracted it when you raised the motor relay
    working on 3.3 V. That evidence was real but did not apply, and I should have
    explained why instead of conceding:
    active HIGH (motor) pin -[R]-|>- GND
    3.3 V switches ON, LOW switches fully OFF.
    active LOW (in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
2026-09-28 Remove the relay diagnostics now the cause is known
    The hunt is over, so the scaffolding built for it comes out.
    Removed:
    INHIBIT_PIN_OPEN_DRAIN the experiment that would have confirmed the
    diagnosis. Blink confirmed it instead, and leaving
    an option in the tree that puts 5 V on a pin which
    is not 5 V tolerant is a liability, not a feature
    n0 / n1 the pin-hold override, and the inhibitOverride gate
    in loop() that went with it. loop() drives the slot
    unconditionally again, which is one fewer thing
    between the state an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
2026-09-28 Out of retries stays inhibited, and say honestly why it might not be a jam
    Answering the question your log raises: when the retries are spent, keep the
    slot shut. I would push back on making that a client preference.
    The machine cannot tell three things apart, because the beam is its only
    evidence and all three look identical from inside:
    1. a pad wedged in the coil
    2. the coil empty, if no stock switch is fitted
    3. THE IR SENSOR BLIND — pads dropping perfectly and the machine unable to
    see them
    A machine that cannot tell whether pads are coming out must not keep taking
    money for them. That is the principle the whole payment model rests on, and a
    flag that turns it off is not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
    [pads_vending_machine_with_coin_acceptor.ino]
2026-09-28 Put the out-of-retries fault on the screen, for both people who read it
    The serial triage was only reaching somebody with a laptop. An attendant in a
    washroom has the screen and nothing else, so the screen now carries it too —
    paged, since it does not fit in sixteen columns.
    OUT OF ORDER OUT OF ORDER OUT OF ORDER
    YOU PAID KSH 20 - PLEASE CALL 07XX XXX XXX -
    ... STAFF CHECK COIL / AND SENSOR
    Two audiences, one screen, ordered by who is standing there now. The customer
    gets the two things she can act on first — that she has paid, and the number —
    so the message still works for somebody who reads it and walks off. The staff
    hint trails behin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
    [pads_vending_machine_with_coin_acceptor.ino]
2026-09-29 Find what has been killing the boards: spikes on the coin line
    Three ESP32s went silent. The first looked like a toolchain fault, but a full
    disk was only stopping esptool from unpacking itself. With space cleared the
    board was still silent in every DTR/RTS state, while a second board on the
    same cable and port booted and talked. So the first board was dead.
    Metering the acceptor's COIN output with the ESP32 out of circuit: ~0 V at
    idle, but 24 V and 36 V when the acceptor is connected or disconnected. That
    is inductive kickback from its solenoid, read on a meter too slow to see the
    true peak, against a GPIO rated for 3.6 V. The idle reading is why the old
    "measure it first" rule in the REA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
2026-09-29 Rewrite the resume block around the coin-line fix
    The "next session" list still said to wire the LCD first and to settle the
    relay polarity with n0/n1. Both are stale: no board should be connected
    until the coin line is optocoupled, and the inhibit relay is now decided.
    The new order builds the protection and proves it with a meter before any
    ESP32 goes near it, then repeats the coin tests, because the PC817 changes
    the input path those tests were run on.
2026-09-30 Add WIRING.md: the machine as built, with the PC817 and new relay
    firmware_dev_paperwork/WIRING.md is now the authoritative wiring: pin map,
    power tree, the PC817 coin line with how to identify its pins, both relays,
    IR sensor, buzzer, button, stock switch, grounds, and the I2C level
    converter for the LCD. Every item is marked metered, fitted-not-run, or
    not built.
    Bench work recorded in it and in FIRMWARE_PROGRESS:
    - PC817 coin line metered: 3.29 V idle, 33 mV held low, and no change when
    the acceptor is unplugged and replugged. The same action used to put
    24-36 V on the line.
    - Post-mortem: one dead board has GPIO 18 shorted to GND, another has its
    3V3 rail shorted. Direct evidence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
    [pads_vending_machine_with_coin_acceptor.ino]
2026-09-30 Add LESSONS_LEARNED.md: what went wrong, what it cost, the rule taken
    Every entry is something that happened on this project, pointing back to
    FIRMWARE_PROGRESS or the git log: the coin line that killed three boards,
    the active-LOW relay a 3.3 V pin cannot release, floating pins at boot,
    the unsigned-time underflow, motor noise spent as money, diagnostics that
    reported untrue numbers, the full disk that looked like a dead board, and
    the times reasoning ran ahead of measurement - including the assistant's
    own wrong calls, since those are the ones most likely to repeat.
    Ends with a checklist meant to carry over to the next build.
2026-09-30 Put the active-LOW relay lesson in the short list at the top
    A 3.3 V board cannot release a 5 V active-LOW module. It was already lesson
    1.4; it belongs in the list people read when they read nothing else.
2026-09-30 New board up: level converter, LCD, and a clean first boot
    The I2C level converter metered 3.29 V on LV1/LV2 and 5.02 V on HV1/HV2
    before the ESP32 was connected, so the ESP32 side can only ever see 3.3 V.
    The new ESP32 flashed first time and the boot self-test passed: LCD found
    at 0x27 through the converter and showing the idle screen, GPIO 18 idle
    HIGH through the PC817, inhibit relay reported active HIGH on NC, stock
    switch PADS PRESENT, buzzer chirping. No relay clicked before the chirp,
    so the new pull-downs hold GPIO 19 and 26 through reset.
    Recorded in FIRMWARE_PROGRESS (dated section and RESUME block), WIRING.md
    (pin statuses, section 9 readings, backlight sleep) and the paperwork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
2026-09-30 Stop the inhibit relay flapping the stock switch into a reset loop
    On the bench the machine sat in a loop several times a second: relay
    energises, stock line reads EMPTY, enterEmpty() releases the relay, stock
    reads PRESENT, back in service, relay energises. Every stock change in the
    log landed straight after a relay line. Hammering the coil like that reset
    the board twice (an interrupt watchdog and a double exception).
    - INHIBIT_SETTLE_MS (600 ms): the stock switch is not sampled for this long
    after the inhibit relay moves, and its debounce restarts afterwards.
    - Re-opening the slot is rate-limited by the same window; closing it is
    never delayed, since blocking money early costs nothin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
    [pads_vending_machine_with_coin_acceptor.ino]
2026-09-30 Add P: record the raw coin waveform beside what the interrupt counted
    The interrupt only sees falling edges, so when a coin arrives with the wrong
    count it cannot say why. P samples GPIO 18 every ~20 us for one coin and
    prints every LOW and HIGH period, the raw number of pulses, and what the
    interrupt counted for the same coin. It only reads the pin: the interrupt
    keeps counting and the coin is banked as normal afterwards.
    Its first run found the double-count fault fixed in the next commit: 5
    clean pulses on the wire, 9 counted.
    Verified on hardware 2026-10-01.
    [pads_vending_machine_with_coin_acceptor.ino]
2026-09-30 Fix every coin being counted twice, and recalibrate to the real pulses
    After the PC817 went in, the same coin gave different counts (a KSh 10 read
    7-10) and coins went into the cash box uncredited. The P probe showed why:
    a KSh 10 is 5 pulses, each 50 ms LOW then 105 ms HIGH, but the interrupt
    had counted 9. A FALLING interrupt on the ESP32 can also fire on a rising
    edge's microsecond glitch, and that false count lands 50 ms after the real
    one, past the old 20 ms debounce.
    With the direct wiring it fired on every rising edge, so every coin read
    exactly double and COIN_TABLE had been calibrated to the doubled counts
    (2/10/20/40). The logged "gaps 50-105 ms" were a pulse's own end and the
    nex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
    [pads_vending_machine_with_coin_acceptor.ino]
2026-09-30 Stop the display rebuild freezing the loop for a second, every vend
    After a status reset, loop max read 2.2 s with the machine idle. The
    display rebuild in say() called lcd.init(), and in LiquidCrystal_I2C 1.1.2
    that is the power-up routine: delay(50) then delay(1000) before anything
    is sent. It ran after every motor start, relay switch and coin. The worst
    case was the vend: motorOn() marks the display for rebuild and the
    dispensing screen follows, so for the first second of every vend loop()
    was not watching the IR beam. A real pad falls through in a fraction of
    that. Finger tests hid it by holding the beam blocked.
    lcdResync() now re-syncs the 4-bit interface with the HD44780 software
    res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
    [pads_vending_machine_with_coin_acceptor.ino]
2026-09-30 Keep the service phone number out of git, in a local header
    The fault screen shows a phone number to a customer who has paid and needs
    help. The real number is now set, but it must not be in the repository, so
    it lives in service_contact.h beside the sketch, which .gitignore excludes.
    The sketch includes it with __has_include and falls back to the
    07XX XXX XXX placeholder when it is absent, so a fresh clone still compiles
    and the boot self-test still warns about the placeholder.
    service_contact.example.h is the committed template: copy it to
    service_contact.h and put the number in. Any machine that flashes the board
    needs its own copy.
    Verified: the built binary contains the real number an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
2026-10-01 Hold the service number on the top line, and bring the paperwork up to date
    The fault screens gave the service number inside the paged sentence on
    line 2: two seconds a page, too short to write down, and because pages
    break on spaces a spaced number could be split across two pages depending
    on the credit shown before it. Every screen that gives the number now puts
    it on line 1 through callLine() ("CALL <number>" if it fits 16, else
    "TEL <number>", else the number alone) and pages the message on line 2, so
    the number stays on screen for as long as the fault lasts. Two duplicated
    comment paragraphs in the fault screen were tidied while there.
    Verified on hardware: a test vend left to time out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
    [pads_vending_machine_with_coin_acceptor.ino]
2026-10-02 Shut the coin slot during a sale, and make each step of the sale talk
    A coin inserted while the motor turned was lost. Decision 2 (25 Sep) kept
    the slot open mid-vend and banked those coins; decision 18 (26 Sep) muted
    the coin line while the coil turns and binned any burst. Together, a coin
    whose pulses arrived during a vend was in the cash box and never credited.
    The builder noticed coins could still go in while dispensing.
    New state ST_PAID between IDLE and DISPENSING. The slot is now live only in
    IDLE while the credit is short of a pad, so it shuts the instant the price
    is met and stays shut until the pad is collected. PAID holds PAID_HOLD_MS
    (2 s) and waits for the coin line to go quiet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
    [pads_vending_machine_with_coin_acceptor.ino]
2026-10-07 LCD decoupling not needed at 4 cm from the buck; solder the display wiring
    The display garbled once on the new firmware while the LCD was on Dupont
    jumper wires, and cleared itself on the next rebuild. A push-on contact
    that breaks for a fraction of a millisecond under motor and relay vibration
    has the same effect as a supply dip. The builder has soldered the wiring,
    still through the level converter, with the I2C lines short and crossing
    nothing. WIRING.md section 9 now says to solder rather than use jumpers.
    The 100 uF + 100 nF at the LCD is dropped from the to-do list: the LCD is
    about 4 cm from the buck's output, whose 1000 uF + 100 nF already serve as
    its local decoupling. A 100 nF acr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
2026-10-07 Watch the beam always, let sensor faults clear themselves, and fix paging
    Reported by the builder:
    1. The fault screen read "COINS ARE BEING TAKEN". The pager filled
    16-character pages word by word and split "... - NO COINS ARE BEING
    TAKEN" after the "NO", so the last two pages said the opposite.
    2. With the IR sensor unplugged at boot the machine halted correctly, but
    plugging it back in did nothing until the button was held.
    3. Unplugging the sensor on a running machine was not noticed: the beam
    debouncer was only polled during a vend.
    4. "SEE SERIAL" on a customer screen means nothing.
    Fixes:
    - lcdPage() honours '|' as a forced page break, and every customer message
    now pag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
    [pads_vending_machine_with_coin_acceptor.ino]
2026-10-07 Stop the buzzer coil drawing current between beeps, and add SOUND_ON
    The builder noticed the buzzer module running warm. It drives its coil with
    a 9012 PNP, on while the input is LOW, and the firmware silenced it with
    ledcWriteTone(ch, 0), which in ESP32 core 2.0.11 is 0% duty: a steady LOW.
    So between every beep the coil carried DC. A passive buzzer makes no sound
    on DC, so nothing was heard; the coil just heated. The builder had already
    swapped the module, thinking it faulty, and was about to buy another.
    buzzerSilence() now takes the pin off the PWM channel and holds it HIGH;
    beep() reattaches it. HIGH only turns the PNP fully off when the module runs
    from the same 3.3 V, so its VCC move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
    [pads_vending_machine_with_coin_acceptor.ino]
2026-10-07 Look for the screen again if it is missed at boot; pull-down needs 1 Mohm
    On some cold power-ups the screen stayed blank all session while coins,
    vends and everything else worked. The LCD was looked for once, in self-test
    [4]; missed then, lcdOk stayed false and every screen update returned for
    the whole session. At power-on the 5 V rail ramps as its 1000 uF charges,
    and the ESP32 could ask before the backpack had enough voltage to answer.
    An EN reset never showed it, because the rails were already up.
    - Self-test [4] waits up to LCD_BOOT_WAIT_MS (2 s) for the LCD to answer.
    - If it is still missing, loop() looks again every LCD_REPROBE_MS (5 s),
    outside a vend, and brings the screen up t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
    [pads_vending_machine_with_coin_acceptor.ino]
2026-10-07 Relay-module decoupling not needed: the relays sit 1.3 cm from the buck
    The 100 uF + 100 nF at the relay module VCC was on the to-do list for two
    reasons. As a local supply for the coils it is redundant: the modules are
    about 1.3 cm from the buck's 1000 uF + 100 nF, which already serve them, the
    same reasoning that dropped the LCD's. And as part of the fix for the relay
    disturbing the stock switch, that is handled by the firmware guard, verified
    with no stock-line change through 24 relay clicks and every vend since.
    Removed from the to-do list in WIRING, README's parts list, the backlog and
    the progress log; a 100 nF across the module is optional insurance. Also
    corrects WIRING.md, which st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
2026-10-07 Fix the lit, frozen screen, and add a loop watchdog
    The builder found the screen lit on "PAD = KSH 20" / "THIS MACHINE" for
    over ten minutes, not rotating and not sleeping. Investigated before
    changing anything: s, sent with DTR/RTS held so the board did not reset,
    showed the loop alive and one fault this session. Reproduced on the old
    firmware: idle until the backlight slept, sensor VCC off (CHECK SENSOR),
    back on (recovered), and the screen was lit and frozen within seconds.
    Cause: a rebuild in say() called lcd.backlight() unconditionally, lighting
    the screen while backlightOn still said asleep. The idle rotation and the
    sleep timer both require backlightOn, so both stopped for good. The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
    [pads_vending_machine_with_coin_acceptor.ino]
2026-10-22 Harden the part-payment countdown against a stale-now wrap
    creditPromptLine() measured the countdown with a raw (now - lastCoinMs).
    bankCoin() stamps lastCoinMs with millis(), which can land a hair ahead of
    the loop's now, and the unsigned subtraction would then wrap to ~4.29
    billion and flash "0:00" for one frame. The banner shown after a coin keeps
    this off the dangerous pass today, so it never surfaced, but the project's
    rule is to never write (now - stamp) directly. Switched to the wrap-safe
    sinceMs() helper the file already provides. Behaviourally identical.
    Flashed 2026-10-08 and running since, including a 6-day continuous run with
    flat heap, so verified on the board.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
2026-10-22 Log the box build: TVS and pull-down fitted, 6-day run, first real pads
    Assembled in the box. Fitted the P6KE15CA TVS at the 12 V block
    (bidirectional, fine on a 12 V rail) and the 1 MOhm pull-down on GPIO 27.
    A six-day continuous run showed flat heap (no leak), zero motor noise, and
    the watchdog recovered again on the assembled unit.
    First real pads off the coil: 2 of 2 present fed and dropped cleanly at
    1038 and 1950 ms, the first evidence pads feed without jamming. Only two
    pads were on hand, so the soak's "60% no pad" is the empty coil, not a
    misfeed. DISPENSE_TIMEOUT_MS left at 7000: the soak's 4000 suggestion is
    from only two drops, and 7000 is safe. The real value waits on a 25-50 pa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
2026-10-22 Clear stale paperwork now the TVS and pull-down are fitted and in the box
    A staleness sweep of the docs. The P6KE15CA TVS and the 1 MOhm GPIO-27
    pull-down are fitted, so every "to fit / not bought" mark for them was wrong:
    updated the WIRING pin table, power tree, why-each-part table and status
    summary, and softened rule 2 ("switch 12 V off... until the TVS is fitted")
    now the TVS is in. WIRING's status summary gains "assembled in the enclosure"
    and "coil feeds real pads (2/2, full soak pending)", and drops the stale
    "n1/n0 next" on the inhibit relay. The index status table now shows the first
    real drops (1038/1950 ms) and the coil feeding 2 of 2 instead of "untested",
    and the size as ~339 K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
2026-10-22 Add a layman operating manual (Markdown source + printable PDF)
    An operations manual for Rebecca and her staff: how a customer buys a pad,
    what every screen message means (two tables, each message quoted exactly as
    the firmware displays it), how the balance and countdown survive a power cut,
    how to refill the coil front-first, what OUT OF ORDER / JAMMED mean and what
    to check, and a quick problem guide (including the jumbled-text power-cycle
    note). Written for a non-technical reader.
    The PDF is a 4-page A4 render of the Markdown, generated with reportlab; the
    Markdown is the source of truth, so regenerate the PDF if it changes. The
    service phone number is deliberately NOT in either file: a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
2026-10-27 Add ABOUT.md as the project's front door, linked from the README top
    A single source-of-truth overview written for a newcomer or a funding
    evaluator landing on the repo: the problem, the solution, how the machine
    works, where it stands today (with the quantitative evidence — 100% coin
    decode, six-day run, watchdog, first real pads 2/2), why it is engineered the
    way it is (the three-boards reliability story, the pay-on-delivery money
    model), affordability (~KSh 9,000 / ~USD 65 in locally-available parts), a map
    of the repository, and the 12-month roadmap.
    The README now opens with a "Start with ABOUT.md" callout that also points to
    the operating manual and the engineering record, and state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
